kingoflolz/lutcam/gateware/fixtures/lrcca/test12.png

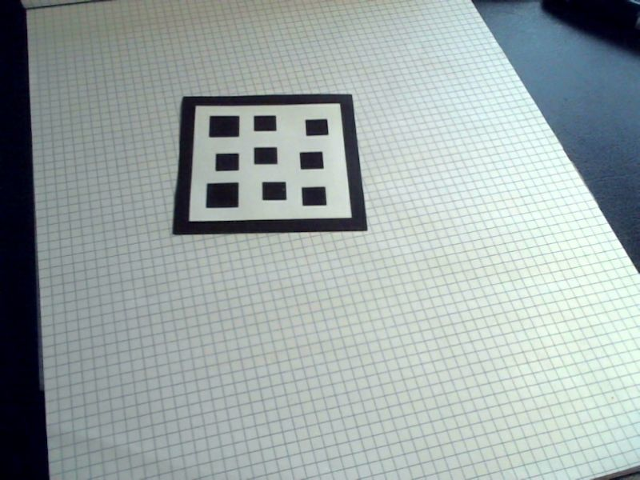
gateware/fixtures/lrcca/test12.png
