kingoflolz/lutcam/hardware/README.md

# Lutcam hardware

Open `lutcam-hardware.kicad_pro` in KiCad to work on the board and schematics.
The [datasheet inventory](datasheets/README.md) and
[3D model provenance](models3d/README.md) describe the supporting assets.

## License

Lutcam's original hardware design files, including schematics, PCB layout,
original symbols and footprints, and original mechanical models, are licensed
under the [Apache License, Version 2.0](../LICENSE).

Third-party library elements, supplier models, and manufacturer documentation
retain their own terms, including when embedded in a design or converted to
another format. See [NOTICE](../NOTICE) and
[THIRD_PARTY_NOTICES.md](../THIRD_PARTY_NOTICES.md) for the scope and exceptions.
