kingoflolz/lutcam/hardware/TI60F225/ti60_pinout-v1.1.xlsx

Sheet: V64
© 2021
Bank Number | Pin Names | Configuration Functions | MIPI RX Function | VREF Function for HSTL/SSTL | LVDS and MIPI Pairs | Clock Region | DDIO | WLCSP64
BL | TDI | TDI |  |  |  |  |  | H5
BL | TCK | TCK |  |  |  |  |  | H4
BL | TMS | TMS |  |  |  |  |  | H3 | Note:
BL | TDO | TDO |  |  |  |  |  | G4 | VCCIOxx_yy_zz indicates Power for I/O banks that are shorted together.
BANK1A | REF_RES_1A |  |  |  |  |  |  | F4 | xx, yy, and zz are the bank locations
BANK1A | CDONE | CDONE |  |  |  |  |  | F2 | For example, VCCIO1B_1C shorts banks 1B and 1C
BANK1A | CRESET_N | CRESET_N |  |  |  |  |  | H1
BANK1A | GPIOL_P_01_SSL_N | SSL_N | RX_DATA_P1_I0 |  | GPIOL_PN_01 | L0 | Y | F3
BANK1A | GPIOL_N_01_CCK | CCK | RX_DATA_N1_I0 |  | GPIOL_PN_01 | L0 | Y | E3
BANK1A | GPIOL_P_02_CSI | CSI | RX_CLK_P_I0 |  | GPIOL_PN_02 | L1 | Y | G1
BANK1A | GPIOL_N_02_CSO | CSO | RX_CLK_N_I0 |  | GPIOL_PN_02 | L1 | Y | F1
BANK1A | GPIOL_P_03_CDI0 | CDI0 | RX_DATA_P2_I0 |  | GPIOL_PN_03 | L1 | Y | D3
BANK1A | GPIOL_N_03_CDI1 | CDI1 | RX_DATA_N2_I0 |  | GPIOL_PN_03 | L1 | Y | C3
BANK1A | GPIOL_P_04_CDI2 | CDI2 | RX_DATA_P3_I0 | VREF1A | GPIOL_PN_04 | L1 | Y | D2
BANK1A | GPIOL_N_04_CDI3 | CDI3 | RX_DATA_N3_I0 |  | GPIOL_PN_04 | L1 | Y | C1
BANK1A | GPIOL_P_08_CLK1_P | EXT_CONFIG_CLK |  |  | GPIOL_PN_08 | L3 | Y | E1
BANK1A | GPIOL_N_08_CLK1_N |  |  |  | GPIOL_PN_08 | L3 | Y | D1
BANK1B | GPIOL_P_10_CLK3_P |  |  |  | GPIOL_PN_10 | L4 | Y | C4
BANK1B | GPIOL_N_10_CLK3_N |  |  |  | GPIOL_PN_10 | L4 | Y | B4
BANK1B | GPIOL_P_13_CBSEL0 | CBSEL0 |  |  | GPIOL_PN_13 | L5 | Y | B6
BANK1B | GPIOL_N_13_CBSEL1 | CBSEL1 |  |  | GPIOL_PN_13 | L5 | Y | B5
BANK1B | GPIOL_P_15_NSTATUS | NSTATUS |  | VREF1B | GPIOL_PN_15 | L6 | Y | A5
BANK1B | GPIOL_N_15_TEST_N | TEST_N |  |  | GPIOL_PN_15 | L6 | Y | A4
BANK1B | GPIOL_P_17_EXTFB |  |  |  | GPIOL_PN_17 | L6, L7 | Y | B3
BANK1B | GPIOL_N_17 |  |  |  | GPIOL_PN_17 | L6, L7 | Y | A3
BANK1B | GPIOL_P_18_PLLIN0 |  |  |  | GPIOL_PN_18 | L7 | Y | A2
BANK1B | GPIOL_N_18 |  |  |  | GPIOL_PN_18 | L7 | Y | A1
BANK1B | REF_RES_1B |  |  |  |  |  |  | C5
BANK2A | REF_RES_2A |  |  |  |  |  |  | A6
BANK2A | REF_RES_3A |  |  |  |  |  |  | A7
BANK3B | GPIOR_N_09_CLK10_N |  |  |  | GPIOR_PN_09 | R3 | Y | B8
BANK3B | GPIOR_P_09_CLK10_P |  |  |  | GPIOR_PN_09 | R3 | Y | B7
BANK3B | GPIOR_N_05_CDI31 |  | RX_DATA_N4_I6 |  | GPIOR_PN_05 | R2 | Y | D8
BANK3B | GPIOR_P_05_CDI30 |  | RX_DATA_P4_I6 | VREF3B | GPIOR_PN_05 | R2 | Y | C8
BANK3B | GPIOR_N_04_CDI29 |  | RX_DATA_N3_I6 |  | GPIOR_PN_04 | R1 | Y | F8
BANK3B | GPIOR_P_04_CDI28 |  | RX_DATA_P3_I6 |  | GPIOR_PN_04 | R1 | Y | E8
BANK3B | GPIOR_N_03_CDI27 |  | RX_DATA_N2_I6 |  | GPIOR_PN_03 | R1 | Y | C7
BANK3B | GPIOR_P_03_CDI26 |  | RX_DATA_P2_I6 |  | GPIOR_PN_03 | R1 | Y | D7
BANK3B | GPIOR_N_02_CDI25 |  | RX_CLK_N_I6 |  | GPIOR_PN_02 | R1 | Y | C6
BANK3B | GPIOR_P_02_CDI24 |  | RX_CLK_P_I6 |  | GPIOR_PN_02 | R1 | Y | D6
BANK3B | GPIOR_N_01_CDI23 |  | RX_DATA_N1_I6 |  | GPIOR_PN_01 | R0 | Y | F7
BANK3B | GPIOR_P_01_EXTFB |  | RX_DATA_P1_I6 |  | GPIOR_PN_01 | R0 | Y | G7
BANK3B | GPIOR_N_00_CDI22 |  | RX_DATA_N0_I6 |  | GPIOR_PN_00 | R0 | Y | G6
BANK3B | GPIOR_P_00_PLLIN0 |  | RX_DATA_P0_I6 |  | GPIOR_PN_00 | R0 | Y | H6
BANK3B | REF_RES_3B |  |  |  |  |  |  | G8
BANK4A | REF_RES_4A |  |  |  |  |  |  | H7
 | VCC |  |  |  |  |  |  | E7
 | VCC |  |  |  |  |  |  | E4
 | VCC |  |  |  |  |  |  | E2
 | VCC |  |  |  |  |  |  | D5
 | VCCA_BR |  |  |  |  |  |  | F6
 | VCCA_TL |  |  |  |  |  |  | B2
 | VCCAUX |  |  |  |  |  |  | F5
 | VCCIO1A_4B |  |  |  |  |  |  | G3
 | VCCIO1B_2A |  |  |  |  |  |  | C2
 | VCCIO2B_3A_3B_4A |  |  |  |  |  |  | E6
 | VCCIO33_BL |  |  |  |  |  |  | H2
 | VQPS_GND |  |  |  |  |  |  | B1
 | GND |  |  |  |  |  |  | H8
 | GND |  |  |  |  |  |  | G5
 | GND |  |  |  |  |  |  | G2
 | GND |  |  |  |  |  |  | E5
 | GND |  |  |  |  |  |  | D4
 | GND |  |  |  |  |  |  | A8

Sheet: W64
© 2021
Bank Number | Pin Names | Configuration Functions | MIPI RX Function | VREF Function for HSTL/SSTL | LVDS and MIPI Pairs | Clock Region | DDIO | WLCSP64
BL | TDI | TDI |  |  |  |  |  | H5
BL | TCK | TCK |  |  |  |  |  | H4
BL | TMS | TMS |  |  |  |  |  | H3 | Note:
BL | TDO | TDO |  |  |  |  |  | G4 | VCCIOxx_yy_zz indicates Power for I/O banks that are shorted together.
BANK1A | REF_RES_1A |  |  |  |  |  |  | F4 | xx, yy, and zz are the bank locations
BANK1A | CDONE | CDONE |  |  |  |  |  | F2 | For example, VCCIO1B_1C shorts banks 1B and 1C
BANK1A | CRESET_N | CRESET_N |  |  |  |  |  | H1
BANK1A | GPIOL_P_01_SSL_N | SSL_N | RX_DATA_P1_I0 |  | GPIOL_PN_01 | L0 | Y | F3
BANK1A | GPIOL_N_01_CCK | CCK | RX_DATA_N1_I0 |  | GPIOL_PN_01 | L0 | Y | E3
BANK1A | GPIOL_P_02_CSI | CSI | RX_CLK_P_I0 |  | GPIOL_PN_02 | L1 | Y | G1
BANK1A | GPIOL_N_02_CSO | CSO | RX_CLK_N_I0 |  | GPIOL_PN_02 | L1 | Y | F1
BANK1A | GPIOL_P_03_CDI0 | CDI0 | RX_DATA_P2_I0 |  | GPIOL_PN_03 | L1 | Y | D3
BANK1A | GPIOL_N_03_CDI1 | CDI1 | RX_DATA_N2_I0 |  | GPIOL_PN_03 | L1 | Y | C3
BANK1A | GPIOL_P_04_CDI2 | CDI2 | RX_DATA_P3_I0 | VREF1A | GPIOL_PN_04 | L1 | Y | D2
BANK1A | GPIOL_N_04_CDI3 | CDI3 | RX_DATA_N3_I0 |  | GPIOL_PN_04 | L1 | Y | C1
BANK1A | GPIOL_P_08_CLK1_P | EXT_CONFIG_CLK |  |  | GPIOL_PN_08 | L3 | Y | E1
BANK1A | GPIOL_N_08_CLK1_N |  |  |  | GPIOL_PN_08 | L3 | Y | D1
BANK1B | GPIOL_P_10_CLK3_P |  |  |  | GPIOL_PN_10 | L4 | Y | C4
BANK1B | GPIOL_N_10_CLK3_N |  |  |  | GPIOL_PN_10 | L4 | Y | B4
BANK1B | GPIOL_P_13_CBSEL0 | CBSEL0 |  |  | GPIOL_PN_13 | L5 | Y | B6
BANK1B | GPIOL_N_13_CBSEL1 | CBSEL1 |  |  | GPIOL_PN_13 | L5 | Y | B5
BANK1B | GPIOL_P_15_NSTATUS | NSTATUS |  | VREF1B | GPIOL_PN_15 | L6 | Y | A5
BANK1B | GPIOL_N_15_TEST_N | TEST_N |  |  | GPIOL_PN_15 | L6 | Y | A4
BANK1B | GPIOL_P_17_EXTFB |  |  |  | GPIOL_PN_17 | L6, L7 | Y | B3
BANK1B | GPIOL_N_17 |  |  |  | GPIOL_PN_17 | L6, L7 | Y | A3
BANK1B | GPIOL_P_18_PLLIN0 |  |  |  | GPIOL_PN_18 | L7 | Y | A2
BANK1B | GPIOL_N_18 |  |  |  | GPIOL_PN_18 | L7 | Y | A1
BANK1B | REF_RES_1B |  |  |  |  |  |  | C5
BANK2A | REF_RES_2A |  |  |  |  |  |  | A6
BANK2A | REF_RES_3A |  |  |  |  |  |  | A7
BANK3B | GPIOR_N_09_CLK10_N |  |  |  | GPIOR_PN_09 | R3 | Y | B8
BANK3B | GPIOR_P_09_CLK10_P |  |  |  | GPIOR_PN_09 | R3 | Y | B7
BANK3B | GPIOR_N_05_CDI31 |  | RX_DATA_N4_I6 |  | GPIOR_PN_05 | R2 | Y | D8
BANK3B | GPIOR_P_05_CDI30 |  | RX_DATA_P4_I6 | VREF3B | GPIOR_PN_05 | R2 | Y | C8
BANK3B | GPIOR_N_04_CDI29 |  | RX_DATA_N3_I6 |  | GPIOR_PN_04 | R1 | Y | F8
BANK3B | GPIOR_P_04_CDI28 |  | RX_DATA_P3_I6 |  | GPIOR_PN_04 | R1 | Y | E8
BANK3B | GPIOR_N_03_CDI27 |  | RX_DATA_N2_I6 |  | GPIOR_PN_03 | R1 | Y | C7
BANK3B | GPIOR_P_03_CDI26 |  | RX_DATA_P2_I6 |  | GPIOR_PN_03 | R1 | Y | D7
BANK3B | GPIOR_N_02_CDI25 |  | RX_CLK_N_I6 |  | GPIOR_PN_02 | R1 | Y | C6
BANK3B | GPIOR_P_02_CDI24 |  | RX_CLK_P_I6 |  | GPIOR_PN_02 | R1 | Y | D6
BANK3B | GPIOR_N_01_CDI23 |  | RX_DATA_N1_I6 |  | GPIOR_PN_01 | R0 | Y | F7
BANK3B | GPIOR_P_01_EXTFB |  | RX_DATA_P1_I6 |  | GPIOR_PN_01 | R0 | Y | G7
BANK3B | GPIOR_N_00_CDI22 |  | RX_DATA_N0_I6 |  | GPIOR_PN_00 | R0 | Y | G6
BANK3B | GPIOR_P_00_PLLIN0 |  | RX_DATA_P0_I6 |  | GPIOR_PN_00 | R0 | Y | H6
BANK3B | REF_RES_3B |  |  |  |  |  |  | G8
BANK4A | REF_RES_4A |  |  |  |  |  |  | H7
 | VCC |  |  |  |  |  |  | E7
 | VCC |  |  |  |  |  |  | E4
 | VCC |  |  |  |  |  |  | E2
 | VCC |  |  |  |  |  |  | D5
 | VCCA_BR |  |  |  |  |  |  | F6
 | VCCA_TL |  |  |  |  |  |  | B2
 | VCCAUX |  |  |  |  |  |  | F5
 | VCCIO1A_4B |  |  |  |  |  |  | G3
 | VCCIO1B_2A |  |  |  |  |  |  | C2
 | VCCIO2B_3A_3B_4A |  |  |  |  |  |  | E6
 | VCCIO33_BL |  |  |  |  |  |  | H2
 | GND |  |  |  |  |  |  | H8
 | GND |  |  |  |  |  |  | G5
 | GND |  |  |  |  |  |  | G2
 | GND |  |  |  |  |  |  | E5
 | GND |  |  |  |  |  |  | D4
 | GND |  |  |  |  |  |  | B1
 | GND |  |  |  |  |  |  | A8

Sheet: F100
© 2024
Bank Number | Pin Names | Configuration Functions | MIPI RX Function | VREF Function for HSTL/SSTL | LVDS and MIPI Pairs | Clock Region | DDIO | FBGA100
BL | TDI | TDI |  |  |  |  |  | K5
BL | TCK | TCK |  |  |  |  |  | K3
BL | TMS | TMS |  |  |  |  |  | K4 | Note:
BL | TDO | TDO |  |  |  |  |  | J4 | VCCIOxx_yy_zz indicates Power for I/O banks that are shorted together.
BANK1A | REF_RES_1A |  |  |  |  |  |  | H4 | xx, yy, and zz are the bank locations
BANK1A | CDONE | CDONE |  |  |  |  |  | H3 | For example, VCCIO1B_1C shorts banks 1B and 1C
BANK1A | CRESET_N | CRESET_N |  |  |  |  |  | K1
BANK1A | GPIOL_P_01_SSL_N | SSL_N |  |  | GPIOL_PN_01 | L0 |  | J1
BANK1A | GPIOL_N_01_CCK | CCK |  |  | GPIOL_PN_01 | L0 |  | J2
BANK1A | GPIOL_P_03_CDI0 | CDI0 |  |  | GPIOL_PN_03 | L1 |  | H2
BANK1A | GPIOL_N_03_CDI1 | CDI1 |  |  | GPIOL_PN_03 | L1 |  | H1
BANK1A | GPIOL_P_05 |  | RX_DATA_P0_I1 |  | GPIOL_PN_05 | L2 | Y | G4
BANK1A | GPIOL_N_05 |  | RX_DATA_N0_I1 |  | GPIOL_PN_05 | L2 | Y | G3
BANK1A | GPIOL_P_06 |  | RX_DATA_P1_I1 |  | GPIOL_PN_06 | L2 | Y | G1
BANK1A | GPIOL_N_06 |  | RX_DATA_N1_I1 |  | GPIOL_PN_06 | L2 | Y | F1
BANK1A | GPIOL_P_07_CLK0_P |  | RX_DATA_P2_I1 |  | GPIOL_PN_07 | L3 | Y | F4
BANK1A | GPIOL_N_07_CLK0_N |  | RX_DATA_N2_I1 |  | GPIOL_PN_07 | L3 | Y | F5
BANK1A | GPIOL_P_08_CLK1_P | EXT_CONFIG_CLK | RX_DATA_P3_I1 |  | GPIOL_PN_08 | L3 | Y | E4
BANK1A | GPIOL_N_08_CLK1_N |  | RX_DATA_N3_I1 |  | GPIOL_PN_08 | L3 | Y | E5
BANK1B | GPIOL_P_09_CLK2_P |  | RX_CLK_P_I1 |  | GPIOL_PN_09 | L4 | Y | F3
BANK1B | GPIOL_N_09_CLK2_N |  | RX_CLK_N_I1 |  | GPIOL_PN_09 | L4 | Y | F2
BANK1B | GPIOL_P_10_CLK3_P |  | RX_DATA_P4_I1 |  | GPIOL_PN_10 | L4 | Y | E1
BANK1B | GPIOL_N_10_CLK3_N |  | RX_DATA_N4_I1 |  | GPIOL_PN_10 | L4 | Y | D1
BANK1B | GPIOL_P_11 |  | RX_DATA_P5_I1 |  | GPIOL_PN_11 | L4 | Y | E2
BANK1B | GPIOL_N_11 |  | RX_DATA_N5_I1 |  | GPIOL_PN_11 | L4 | Y | E3
BANK1B | GPIOL_P_12 |  | RX_DATA_P6_I1 |  | GPIOL_PN_12 | L5 | Y | C3
BANK1B | GPIOL_N_12 |  | RX_DATA_N6_I1 |  | GPIOL_PN_12 | L5 | Y | C2
BANK1B | GPIOL_P_13_CBSEL0 | CBSEL0 | RX_DATA_P7_I1 |  | GPIOL_PN_13 | L5 | Y | B1
BANK1B | GPIOL_N_13_CBSEL1 | CBSEL1 | RX_DATA_N7_I1 |  | GPIOL_PN_13 | L5 | Y | C1
BANK1B | GPIOL_P_15_NSTATUS | NSTATUS |  | VREF1B | GPIOL_PN_15 | L6 | Y | C5
BANK1B | GPIOL_N_15_TEST_N | TEST_N |  |  | GPIOL_PN_15 | L6 | Y | D5
BANK1B | GPIOL_P_17_EXTFB |  |  |  | GPIOL_PN_17 | L6, L7 | Y | B4
BANK1B | GPIOL_N_17 |  |  |  | GPIOL_PN_17 | L6, L7 | Y | C4
BANK1B | GPIOL_P_18_PLLIN0 |  |  |  | GPIOL_PN_18 | L7 | Y | B3
BANK1B | GPIOL_N_18 |  |  |  | GPIOL_PN_18 | L7 | Y | B2
BANK1B | REF_RES_1B |  |  |  |  |  |  | A3
BANK2A | REF_RES_2A |  |  |  |  |  |  | B5
BANK2A | GPIOT_P_01 |  |  |  |  | T0 | Y | A4
BANK3A | REF_RES_3A |  |  |  |  |  |  | B7
BANK3A | GPIOR_N_19 |  |  |  | GPIOR_PN_19 | R7 | Y | A10
BANK3A | GPIOR_P_19_PLLIN0 |  |  |  | GPIOR_PN_19 | R7 | Y | A9
BANK3A | GPIOR_N_14 |  | RX_DATA_N7_I7 |  | GPIOR_PN_14 | R5 | Y | B10
BANK3A | GPIOR_P_14 |  | RX_DATA_P7_I7 |  | GPIOR_PN_14 | R5 | Y | B9
BANK3A | GPIOR_N_13 |  | RX_DATA_N6_I7 |  | GPIOR_PN_13 | R5 | Y | B8
BANK3A | GPIOR_P_13 |  | RX_DATA_P6_I7 | VREF3A | GPIOR_PN_13 | R5 | Y | C8
BANK3A | GPIOR_N_12 |  | RX_DATA_N5_I7 |  | GPIOR_PN_12 | R4 | Y | C10
BANK3A | GPIOR_P_12 |  | RX_DATA_P5_I7 |  | GPIOR_PN_12 | R4 | Y | D10
BANK3A | GPIOR_N_11_CLK8_N |  | RX_DATA_N4_I7 |  | GPIOR_PN_11 | R4 | Y | D9
BANK3A | GPIOR_P_11_CLK8_P |  | RX_DATA_P4_I7 |  | GPIOR_PN_11 | R4 | Y | D8
BANK3A | GPIOR_N_10_CLK9_N |  | RX_CLK_N_I7 |  | GPIOR_PN_10 | R4 | Y | C7
BANK3A | GPIOR_P_10_CLK9_P |  | RX_CLK_P_I7 |  | GPIOR_PN_10 | R4 | Y | D6
BANK3B | GPIOR_N_09_CLK10_N |  | RX_DATA_N3_I7 |  | GPIOR_PN_09 | R3 | Y | E9
BANK3B | GPIOR_P_09_CLK10_P |  | RX_DATA_P3_I7 |  | GPIOR_PN_09 | R3 | Y | E8
BANK3B | GPIOR_N_08_CLK11_N |  | RX_DATA_N2_I7 |  | GPIOR_PN_08 | R3 | Y | E7
BANK3B | GPIOR_P_08_CLK11_P |  | RX_DATA_P2_I7 |  | GPIOR_PN_08 | R3 | Y | F7
BANK3B | GPIOR_N_07 |  | RX_DATA_N1_I7 |  | GPIOR_PN_07 | R3 | Y | F8
BANK3B | GPIOR_P_07 |  | RX_DATA_P1_I7 |  | GPIOR_PN_07 | R3 | Y | G8
BANK3B | GPIOR_N_06 |  | RX_DATA_N0_I7 |  | GPIOR_PN_06 | R2 | Y | F10
BANK3B | GPIOR_P_06 |  | RX_DATA_P0_I7 |  | GPIOR_PN_06 | R2 | Y | F9
BANK3B | GPIOR_N_05 |  | RX_DATA_N4_I6 |  | GPIOR_PN_05 | R2 | Y | H8
BANK3B | GPIOR_P_05 |  | RX_DATA_P4_I6 | VREF3B | GPIOR_PN_05 | R2 | Y | H9
BANK3B | GPIOR_N_04 |  | RX_DATA_N3_I6 |  | GPIOR_PN_04 | R1 | Y | G10
BANK3B | GPIOR_P_04 |  | RX_DATA_P3_I6 |  | GPIOR_PN_04 | R1 | Y | H10
BANK3B | GPIOR_N_03 |  | RX_DATA_N2_I6 |  | GPIOR_PN_03 | R1 | Y | J6
BANK3B | GPIOR_P_03 |  | RX_DATA_P2_I6 |  | GPIOR_PN_03 | R1 | Y | H6
BANK3B | GPIOR_N_02 |  | RX_CLK_N_I6 |  | GPIOR_PN_02 | R1 | Y | J7
BANK3B | GPIOR_P_02 |  | RX_CLK_P_I6 |  | GPIOR_PN_02 | R1 | Y | J8
BANK3B | GPIOR_N_01 |  | RX_DATA_N1_I6 |  | GPIOR_PN_01 | R0 | Y | J10
BANK3B | GPIOR_P_01_EXTFB |  | RX_DATA_P1_I6 |  | GPIOR_PN_01 | R0 | Y | K10
BANK3B | GPIOR_N_00 |  | RX_DATA_N0_I6 |  | GPIOR_PN_00 | R0 | Y | H5
BANK3B | GPIOR_P_00_PLLIN0 |  | RX_DATA_P0_I6 |  | GPIOR_PN_00 | R0 | Y | J5
BANK3B | REF_RES_3B |  |  |  |  |  |  | K9
BANK4A | REF_RES_4A |  |  |  |  |  |  | K8
 | VCC |  |  |  |  |  |  | G5
 | VCC |  |  |  |  |  |  | C6
 | VCC |  |  |  |  |  |  | E6
 | VCC |  |  |  |  |  |  | F6
 | VCC |  |  |  |  |  |  | D7
 | VCC |  |  |  |  |  |  | H7
 | VCCA_BR |  |  |  |  |  |  | K7
 | VCCA_TL |  |  |  |  |  |  | A2
 | VCCA_TR |  |  |  |  |  |  | A7
 | VCCAUX |  |  |  |  |  |  | B6
 | VCCAUX |  |  |  |  |  |  | G6
 | VCCIO1A_4B |  |  |  |  |  |  | G2
 | VCCIO1B |  |  |  |  |  |  | D3
 | VCCIO2A_2B |  |  |  |  |  |  | A6
 | VCCIO33_BL |  |  |  |  |  |  | J3
 | VCCIO3A |  |  |  |  |  |  | C9
 | VCCIO3B_4A |  |  |  |  |  |  | G9
 | VQPS |  |  |  |  |  |  | A5
 | GND |  |  |  |  |  |  | A1
 | GND |  |  |  |  |  |  | D2
 | GND |  |  |  |  |  |  | K2
 | GND |  |  |  |  |  |  | D4
 | GND |  |  |  |  |  |  | K6
 | GND |  |  |  |  |  |  | G7
 | GND |  |  |  |  |  |  | A8
 | GND |  |  |  |  |  |  | J9
 | GND |  |  |  |  |  |  | E10

Sheet: F100S3F2
© 2021
Bank Number | Pin Names | Configuration Functions | MIPI RX Function | VREF Function for HSTL/SSTL | LVDS and MIPI Pairs | Clock Region | DDIO | FBGA100
BL | TDI | TDI |  |  |  |  |  | K5
BL | TCK | TCK |  |  |  |  |  | K3
BL | TMS | TMS |  |  |  |  |  | K4 | Note:
BL | TDO | TDO |  |  |  |  |  | J4 | VCCIOxx_yy_zz indicates Power for I/O banks that are shorted together.
BANK1A | REF_RES_1A |  |  |  |  |  |  | H4 | xx, yy, and zz are the bank locations
BANK1A | CDONE | CDONE |  |  |  |  |  | H3 | For example, VCCIO1B_1C shorts banks 1B and 1C
BANK1A | CRESET_N | CRESET_N |  |  |  |  |  | K1
BANK1A | GPIOL_P_01_SSL_N | SSL_N |  |  | GPIOL_PN_01 | L0 |  | J1
BANK1A | GPIOL_N_01_CCK | CCK |  |  | GPIOL_PN_01 | L0 |  | J2
BANK1A | GPIOL_P_03_CDI0 | CDI0 |  |  | GPIOL_PN_03 | L1 |  | H2
BANK1A | GPIOL_N_03_CDI1 | CDI1 |  |  | GPIOL_PN_03 | L1 |  | H1
BANK1A | GPIOL_P_05 |  | RX_DATA_P0_I1 |  | GPIOL_PN_05 | L2 | Y | G4
BANK1A | GPIOL_N_05 |  | RX_DATA_N0_I1 |  | GPIOL_PN_05 | L2 | Y | G3
BANK1A | GPIOL_P_06 |  | RX_DATA_P1_I1 |  | GPIOL_PN_06 | L2 | Y | G1
BANK1A | GPIOL_N_06 |  | RX_DATA_N1_I1 |  | GPIOL_PN_06 | L2 | Y | F1
BANK1A | GPIOL_P_07_CLK0_P |  | RX_DATA_P2_I1 |  | GPIOL_PN_07 | L3 | Y | F4
BANK1A | GPIOL_N_07_CLK0_N |  | RX_DATA_N2_I1 |  | GPIOL_PN_07 | L3 | Y | F5
BANK1A | GPIOL_P_08_CLK1_P | EXT_CONFIG_CLK | RX_DATA_P3_I1 |  | GPIOL_PN_08 | L3 | Y | E4
BANK1A | GPIOL_N_08_CLK1_N |  | RX_DATA_N3_I1 |  | GPIOL_PN_08 | L3 | Y | E5
BANK1B | GPIOL_P_09_CLK2_P |  | RX_CLK_P_I1 |  | GPIOL_PN_09 | L4 | Y | F3
BANK1B | GPIOL_N_09_CLK2_N |  | RX_CLK_N_I1 |  | GPIOL_PN_09 | L4 | Y | F2
BANK1B | GPIOL_P_10_CLK3_P |  | RX_DATA_P4_I1 |  | GPIOL_PN_10 | L4 | Y | E1
BANK1B | GPIOL_N_10_CLK3_N |  | RX_DATA_N4_I1 |  | GPIOL_PN_10 | L4 | Y | D1
BANK1B | GPIOL_P_11 |  | RX_DATA_P5_I1 |  | GPIOL_PN_11 | L4 | Y | E2
BANK1B | GPIOL_N_11 |  | RX_DATA_N5_I1 |  | GPIOL_PN_11 | L4 | Y | E3
BANK1B | GPIOL_P_12 |  | RX_DATA_P6_I1 |  | GPIOL_PN_12 | L5 | Y | C3
BANK1B | GPIOL_N_12 |  | RX_DATA_N6_I1 |  | GPIOL_PN_12 | L5 | Y | C2
BANK1B | GPIOL_P_13_CBSEL0 | CBSEL0 | RX_DATA_P7_I1 |  | GPIOL_PN_13 | L5 | Y | B1
BANK1B | GPIOL_N_13_CBSEL1 | CBSEL1 | RX_DATA_N7_I1 |  | GPIOL_PN_13 | L5 | Y | C1
BANK1B | GPIOL_P_15_NSTATUS | NSTATUS |  | VREF1B | GPIOL_PN_15 | L6 | Y | C5
BANK1B | GPIOL_N_15_TEST_N | TEST_N |  |  | GPIOL_PN_15 | L6 | Y | D5
BANK1B | GPIOL_P_17_EXTFB |  |  |  | GPIOL_PN_17 | L6, L7 | Y | B4
BANK1B | GPIOL_N_17 |  |  |  | GPIOL_PN_17 | L6, L7 | Y | C4
BANK1B | GPIOL_P_18_PLLIN0 |  |  |  | GPIOL_PN_18 | L7 | Y | B3
BANK1B | GPIOL_N_18 |  |  |  | GPIOL_PN_18 | L7 | Y | B2
BANK1B | REF_RES_1B |  |  |  |  |  |  | A3
BANK2A | REF_RES_2A |  |  |  |  |  |  | B5
BANK2A | GPIOT_P_01 |  |  |  |  | T0 | Y | A4
BANK3A | REF_RES_3A |  |  |  |  |  |  | B7
BANK3A | GPIOR_N_19 |  |  |  | GPIOR_PN_19 | R7 | Y | A10
BANK3A | GPIOR_P_19_PLLIN0 |  |  |  | GPIOR_PN_19 | R7 | Y | A9
BANK3A | GPIOR_N_14 |  | RX_DATA_N7_I7 |  | GPIOR_PN_14 | R5 | Y | B10
BANK3A | GPIOR_P_14 |  | RX_DATA_P7_I7 |  | GPIOR_PN_14 | R5 | Y | B9
BANK3A | GPIOR_N_13 |  | RX_DATA_N6_I7 |  | GPIOR_PN_13 | R5 | Y | B8
BANK3A | GPIOR_P_13 |  | RX_DATA_P6_I7 | VREF3A | GPIOR_PN_13 | R5 | Y | C8
BANK3A | GPIOR_N_12 |  | RX_DATA_N5_I7 |  | GPIOR_PN_12 | R4 | Y | C10
BANK3A | GPIOR_P_12 |  | RX_DATA_P5_I7 |  | GPIOR_PN_12 | R4 | Y | D10
BANK3A | GPIOR_N_11_CLK8_N |  | RX_DATA_N4_I7 |  | GPIOR_PN_11 | R4 | Y | D9
BANK3A | GPIOR_P_11_CLK8_P |  | RX_DATA_P4_I7 |  | GPIOR_PN_11 | R4 | Y | D8
BANK3A | GPIOR_N_10_CLK9_N |  | RX_CLK_N_I7 |  | GPIOR_PN_10 | R4 | Y | C7
BANK3A | GPIOR_P_10_CLK9_P |  | RX_CLK_P_I7 |  | GPIOR_PN_10 | R4 | Y | D6
BANK3B | GPIOR_N_09_CLK10_N |  | RX_DATA_N3_I7 |  | GPIOR_PN_09 | R3 | Y | E9
BANK3B | GPIOR_P_09_CLK10_P |  | RX_DATA_P3_I7 |  | GPIOR_PN_09 | R3 | Y | E8
BANK3B | GPIOR_N_08_CLK11_N |  | RX_DATA_N2_I7 |  | GPIOR_PN_08 | R3 | Y | E7
BANK3B | GPIOR_P_08_CLK11_P |  | RX_DATA_P2_I7 |  | GPIOR_PN_08 | R3 | Y | F7
BANK3B | GPIOR_N_07 |  | RX_DATA_N1_I7 |  | GPIOR_PN_07 | R3 | Y | F8
BANK3B | GPIOR_P_07 |  | RX_DATA_P1_I7 |  | GPIOR_PN_07 | R3 | Y | G8
BANK3B | GPIOR_N_06 |  | RX_DATA_N0_I7 |  | GPIOR_PN_06 | R2 | Y | F10
BANK3B | GPIOR_P_06 |  | RX_DATA_P0_I7 |  | GPIOR_PN_06 | R2 | Y | F9
BANK3B | GPIOR_N_05 |  | RX_DATA_N4_I6 |  | GPIOR_PN_05 | R2 | Y | H8
BANK3B | GPIOR_P_05 |  | RX_DATA_P4_I6 | VREF3B | GPIOR_PN_05 | R2 | Y | H9
BANK3B | GPIOR_N_04 |  | RX_DATA_N3_I6 |  | GPIOR_PN_04 | R1 | Y | G10
BANK3B | GPIOR_P_04 |  | RX_DATA_P3_I6 |  | GPIOR_PN_04 | R1 | Y | H10
BANK3B | GPIOR_N_03 |  | RX_DATA_N2_I6 |  | GPIOR_PN_03 | R1 | Y | J6
BANK3B | GPIOR_P_03 |  | RX_DATA_P2_I6 |  | GPIOR_PN_03 | R1 | Y | H6
BANK3B | GPIOR_N_02 |  | RX_CLK_N_I6 |  | GPIOR_PN_02 | R1 | Y | J7
BANK3B | GPIOR_P_02 |  | RX_CLK_P_I6 |  | GPIOR_PN_02 | R1 | Y | J8
BANK3B | GPIOR_N_01 |  | RX_DATA_N1_I6 |  | GPIOR_PN_01 | R0 | Y | J10
BANK3B | GPIOR_P_01_EXTFB |  | RX_DATA_P1_I6 |  | GPIOR_PN_01 | R0 | Y | K10
BANK3B | GPIOR_N_00 |  | RX_DATA_N0_I6 |  | GPIOR_PN_00 | R0 | Y | H5
BANK3B | GPIOR_P_00_PLLIN0 |  | RX_DATA_P0_I6 |  | GPIOR_PN_00 | R0 | Y | J5
BANK3B | REF_RES_3B |  |  |  |  |  |  | K9
BANK4A | REF_RES_4A |  |  |  |  |  |  | K8
 | VCC |  |  |  |  |  |  | G5
 | VCC |  |  |  |  |  |  | C6
 | VCC |  |  |  |  |  |  | E6
 | VCC |  |  |  |  |  |  | F6
 | VCC |  |  |  |  |  |  | D7
 | VCC |  |  |  |  |  |  | H7
 | VCCA_BR |  |  |  |  |  |  | K7
 | VCCA_TL |  |  |  |  |  |  | A2
 | VCCA_TR |  |  |  |  |  |  | A7
 | VCCAUX |  |  |  |  |  |  | B6
 | VCCAUX |  |  |  |  |  |  | G6
 | VCCIO1A_4B |  |  |  |  |  |  | G2
 | VCCIO1B |  |  |  |  |  |  | D3
 | VCCIO2A_2B |  |  |  |  |  |  | A6
 | VCCIO33_BL |  |  |  |  |  |  | J3
 | VCCIO3A |  |  |  |  |  |  | C9
 | VCCIO3B_4A |  |  |  |  |  |  | G9
 | VQPS_GND |  |  |  |  |  |  | A5
 | GND |  |  |  |  |  |  | A1
 | GND |  |  |  |  |  |  | D2
 | GND |  |  |  |  |  |  | K2
 | GND |  |  |  |  |  |  | D4
 | GND |  |  |  |  |  |  | K6
 | GND |  |  |  |  |  |  | G7
 | GND |  |  |  |  |  |  | A8
 | GND |  |  |  |  |  |  | J9
 | GND |  |  |  |  |  |  | E10

Sheet: F225
© 2021
Bank Number | Pin Names | Configuration Functions | MIPI RX Function | VREF Function for HSTL/SSTL | LVDS and MIPI Pairs | Clock Region | DDIO | FBGA225
BL | GPIOL_01 |  |  |  |  | B0 | Y | R3
BL | GPIOL_02 |  |  |  |  | B0 | Y | R4
BL | TDI | TDI |  |  |  |  |  | P3 | Note:
BL | TCK | TCK |  |  |  |  |  | N4 | VCCIOxx_yy_zz indicates Power for I/O banks that are shorted together.
BL | TMS | TMS |  |  |  |  |  | N3 | xx, yy, and zz are the bank locations
BL | TDO | TDO |  |  |  |  |  | M4 | For example, VCCIO1B_1C shorts banks 1B and 1C
BANK1A | REF_RES_1A |  |  |  |  |  |  | K5
BANK1A | CDONE | CDONE |  |  |  |  |  | L3
BANK1A | CRESET_N | CRESET_N |  |  |  |  |  | J5
BANK1A | GPIOL_P_00_PLLIN0 |  | RX_DATA_P0_I0 |  | GPIOL_PN_00 | L0 | Y | P2
BANK1A | GPIOL_N_00 |  | RX_DATA_N0_I0 |  | GPIOL_PN_00 | L0 | Y | R2
BANK1A | GPIOL_P_01_SSL_N | SSL_N | RX_DATA_P1_I0 |  | GPIOL_PN_01 | L0 | Y | P1
BANK1A | GPIOL_N_01_CCK | CCK | RX_DATA_N1_I0 |  | GPIOL_PN_01 | L0 | Y | N1
BANK1A | GPIOL_P_02_CSI | CSI | RX_CLK_P_I0 |  | GPIOL_PN_02 | L1 | Y | N2
BANK1A | GPIOL_N_02_CSO | CSO | RX_CLK_N_I0 |  | GPIOL_PN_02 | L1 | Y | M2
BANK1A | GPIOL_P_03_CDI0 | CDI0 | RX_DATA_P2_I0 |  | GPIOL_PN_03 | L1 | Y | M1
BANK1A | GPIOL_N_03_CDI1 | CDI1 | RX_DATA_N2_I0 |  | GPIOL_PN_03 | L1 | Y | L1
BANK1A | GPIOL_P_04_CDI2 | CDI2 | RX_DATA_P3_I0 | VREF1A | GPIOL_PN_04 | L1 | Y | H5
BANK1A | GPIOL_N_04_CDI3 | CDI3 | RX_DATA_N3_I0 |  | GPIOL_PN_04 | L1 | Y | H4
BANK1A | GPIOL_P_05 |  | RX_DATA_P0_I1 |  | GPIOL_PN_05 | L2 | Y | K4
BANK1A | GPIOL_N_05 |  | RX_DATA_N0_I1 |  | GPIOL_PN_05 | L2 | Y | J3
BANK1A | GPIOL_P_06 |  | RX_DATA_P1_I1 |  | GPIOL_PN_06 | L2 | Y | K3
BANK1A | GPIOL_N_06 |  | RX_DATA_N1_I1 |  | GPIOL_PN_06 | L2 | Y | K2
BANK1A | GPIOL_P_07_CLK0_P |  | RX_DATA_P2_I1 |  | GPIOL_PN_07 | L3 | Y | K1
BANK1A | GPIOL_N_07_CLK0_N |  | RX_DATA_N2_I1 |  | GPIOL_PN_07 | L3 | Y | J1
BANK1A | GPIOL_P_08_CLK1_P | EXT_CONFIG_CLK | RX_DATA_P3_I1 |  | GPIOL_PN_08 | L3 | Y | J2
BANK1A | GPIOL_N_08_CLK1_N |  | RX_DATA_N3_I1 |  | GPIOL_PN_08 | L3 | Y | H3
BANK1B | GPIOL_P_09_CLK2_P |  | RX_CLK_P_I1 |  | GPIOL_PN_09 | L4 | Y | H1
BANK1B | GPIOL_N_09_CLK2_N |  | RX_CLK_N_I1 |  | GPIOL_PN_09 | L4 | Y | G1
BANK1B | GPIOL_P_10_CLK3_P |  | RX_DATA_P4_I1 |  | GPIOL_PN_10 | L4 | Y | H2
BANK1B | GPIOL_N_10_CLK3_N |  | RX_DATA_N4_I1 |  | GPIOL_PN_10 | L4 | Y | G2
BANK1B | GPIOL_P_11 |  | RX_DATA_P5_I1 |  | GPIOL_PN_11 | L4 | Y | G5
BANK1B | GPIOL_N_11 |  | RX_DATA_N5_I1 |  | GPIOL_PN_11 | L4 | Y | F5
BANK1B | GPIOL_P_12 |  | RX_DATA_P6_I1 |  | GPIOL_PN_12 | L5 | Y | G3
BANK1B | GPIOL_N_12 |  | RX_DATA_N6_I1 |  | GPIOL_PN_12 | L5 | Y | G4
BANK1B | GPIOL_P_13_CBSEL0 | CBSEL0 | RX_DATA_P7_I1 |  | GPIOL_PN_13 | L5 | Y | F3
BANK1B | GPIOL_N_13_CBSEL1 | CBSEL1 | RX_DATA_N7_I1 |  | GPIOL_PN_13 | L5 | Y | E3
BANK1B | GPIOL_P_14 |  | RX_DATA_P0_I2 |  | GPIOL_PN_14 | L6 | Y | F1
BANK1B | GPIOL_N_14 |  | RX_DATA_N0_I2 |  | GPIOL_PN_14 | L6 | Y | F2
BANK1B | GPIOL_P_15_NSTATUS | NSTATUS | RX_DATA_P1_I2 | VREF1B | GPIOL_PN_15 | L6 | Y | E1
BANK1B | GPIOL_N_15_TEST_N | TEST_N | RX_DATA_N1_I2 |  | GPIOL_PN_15 | L6 | Y | E2
BANK1B | GPIOL_P_16 |  | RX_CLK_P_I2 |  | GPIOL_PN_16 | L6 | Y | D1
BANK1B | GPIOL_N_16 |  | RX_CLK_N_I2 |  | GPIOL_PN_16 | L6 | Y | C1
BANK1B | GPIOL_P_17_EXTFB |  | RX_DATA_P2_I2 |  | GPIOL_PN_17 | L6, L7 | Y | B1
BANK1B | GPIOL_N_17 |  | RX_DATA_N2_I2 |  | GPIOL_PN_17 | L6, L7 | Y | C2
BANK1B | GPIOL_P_18_PLLIN0 |  | RX_DATA_P3_I2 |  | GPIOL_PN_18 | L7 | Y | B2
BANK1B | GPIOL_N_18 |  | RX_DATA_N3_I2 |  | GPIOL_PN_18 | L7 | Y | A2
BANK1B | REF_RES_1B |  |  |  |  |  |  | E4
TL | GPIOL_03 |  |  |  |  | T0 | Y | A3
TL | GPIOL_04 |  |  |  |  | T0 | Y | B3
TL | GPIOL_06 |  |  |  |  | T0 | Y | C3
TL | GPIOL_07 |  |  |  |  | T0 | Y | C4
TL | GPIOL_09 |  |  |  |  | T0 | Y | A4
TL | GPIOL_10 |  |  |  |  | T0 | Y | B5
TL | GPIOL_11_PLLIN2 |  |  |  |  | T0 | Y | C5
BANK2A | REF_RES_2A |  |  |  |  |  |  | F6
BANK2A | GPIOT_P_00_PLLIN1 |  | RX_DATA_P0_I3 | VREF2A | GPIOT_PN_00 | T0 | Y | E6
BANK2A | GPIOT_N_00 |  | RX_DATA_N0_I3 |  | GPIOT_PN_00 | T0 | Y | D5
BANK2A | GPIOT_P_01 |  | RX_DATA_P1_I3 |  | GPIOT_PN_01 | T0 | Y | B6
BANK2A | GPIOT_N_01 |  | RX_DATA_N1_I3 |  | GPIOT_PN_01 | T0 | Y | C6
BANK2A | GPIOT_P_03 |  | RX_CLK_P_I3 |  | GPIOT_PN_03 | T0 | Y | A5
BANK2A | GPIOT_N_03 |  | RX_CLK_N_I3 |  | GPIOT_PN_03 | T0 | Y | A6
BANK2A | GPIOT_P_04 |  | RX_DATA_P3_I3 |  | GPIOT_PN_04 | T0 | Y | F7
BANK2A | GPIOT_N_04 |  | RX_DATA_N3_I3 |  | GPIOT_PN_04 | T0 | Y | F8
BANK2A | GPIOT_P_05 |  | RX_DATA_P4_I3 |  | GPIOT_PN_05 | T0 | Y | E7
BANK2A | GPIOT_N_05 |  | RX_DATA_N4_I3 |  | GPIOT_PN_05 | T0 | Y | D7
BANK2A | GPIOT_P_06 |  | RX_DATA_P0_I4 |  | GPIOT_PN_06 | T0 | Y | B7
BANK2A | GPIOT_N_06 |  | RX_DATA_N0_I4 |  | GPIOT_PN_06 | T0 | Y | A7
BANK2A | GPIOT_P_07_CLK4_P |  | RX_DATA_P1_I4 |  | GPIOT_PN_07 | T0 | Y | B8
BANK2A | GPIOT_N_07_CLK4_N |  | RX_DATA_N1_I4 |  | GPIOT_PN_07 | T0 | Y | A8
BANK2B | GPIOT_P_09_CLK6_P |  | RX_CLK_P_I4 |  | GPIOT_PN_09 | T1 | Y | E8
BANK2B | GPIOT_N_09_CLK6_N |  | RX_CLK_N_I4 |  | GPIOT_PN_09 | T1 | Y | D8
BANK2B | GPIOT_P_10_CLK7_P |  | RX_DATA_P3_I4 |  | GPIOT_PN_10 | T1 | Y | C8
BANK2B | GPIOT_N_10_CLK7_N |  | RX_DATA_N3_I4 |  | GPIOT_PN_10 | T1 | Y | C9
BANK2B | GPIOT_P_11 |  | RX_DATA_P4_I4 |  | GPIOT_PN_11 | T1 | Y | B9
BANK2B | GPIOT_N_11 |  | RX_DATA_N4_I4 |  | GPIOT_PN_11 | T1 | Y | A9
BANK2B | GPIOT_P_12 |  | RX_DATA_P0_I5 |  | GPIOT_PN_12 | T1 | Y | F9
BANK2B | GPIOT_N_12 |  | RX_DATA_N0_I5 |  | GPIOT_PN_12 | T1 | Y | E9
BANK2B | GPIOT_P_13 |  | RX_DATA_P1_I5 | VREF2B | GPIOT_PN_13 | T1 | Y | C10
BANK2B | GPIOT_N_13 |  | RX_DATA_N1_I5 |  | GPIOT_PN_13 | T1 | Y | D10
BANK2B | GPIOT_P_14 |  | RX_CLK_P_I5 |  | GPIOT_PN_14 | T1 | Y | A10
BANK2B | GPIOT_N_14 |  | RX_CLK_N_I5 |  | GPIOT_PN_14 | T1 | Y | B10
BANK2B | GPIOT_P_16_EXTFB |  | RX_DATA_P3_I5 |  | GPIOT_PN_16 | T1 | Y | E10
BANK2B | GPIOT_N_16 |  | RX_DATA_N3_I5 |  | GPIOT_PN_16 | T1 | Y | F10
BANK2B | GPIOT_P_17_PLLIN1 |  | RX_DATA_P4_I5 |  | GPIOT_PN_17 | T1 | Y | A11
BANK2B | GPIOT_N_17 |  | RX_DATA_N4_I5 |  | GPIOT_PN_17 | T1 | Y | B11
BANK2B | REF_RES_2B |  |  |  |  |  |  | D11
TR | GPIOR_12 |  |  |  |  | T1 | Y | A13
TR | GPIOR_13 |  |  |  |  | T1 | Y | A12
TR | GPIOR_15 |  |  |  |  | T1 | Y | B12
TR | GPIOR_16 |  |  |  |  | T1 | Y | C12
TR | GPIOR_18 |  |  |  |  | T1 | Y | B14
TR | GPIOR_19 |  |  |  |  | T1 | Y | A14
TR | GPIOR_20 |  |  |  |  | T1 | Y | D12
BANK3A | REF_RES_3A |  |  |  |  |  |  | B15
BANK3A | GPIOR_N_19 |  | RX_DATA_N3_I8 |  | GPIOR_PN_19 | R7 | Y | C15
BANK3A | GPIOR_P_19_PLLIN0 |  | RX_DATA_P3_I8 |  | GPIOR_PN_19 | R7 | Y | C14
BANK3A | GPIOR_N_18 |  | RX_DATA_N2_I8 |  | GPIOR_PN_18 | R6, R7 | Y | D14
BANK3A | GPIOR_P_18 |  | RX_DATA_P2_I8 |  | GPIOR_PN_18 | R6, R7 | Y | D15
BANK3A | GPIOR_N_17 |  | RX_CLK_N_I8 |  | GPIOR_PN_17 | R6 | Y | D13
BANK3A | GPIOR_P_17 |  | RX_CLK_P_I8 |  | GPIOR_PN_17 | R6 | Y | C13
BANK3A | GPIOR_N_16 |  | RX_DATA_N1_I8 |  | GPIOR_PN_16 | R6 | Y | E14
BANK3A | GPIOR_P_16 |  | RX_DATA_P1_I8 |  | GPIOR_PN_16 | R6 | Y | E15
BANK3A | GPIOR_N_15 |  | RX_DATA_N0_I8 |  | GPIOR_PN_15 | R6 | Y | E12
BANK3A | GPIOR_P_15 |  | RX_DATA_P0_I8 |  | GPIOR_PN_15 | R6 | Y | F12
BANK3A | GPIOR_N_14 |  | RX_DATA_N7_I7 |  | GPIOR_PN_14 | R5 | Y | F11
BANK3A | GPIOR_P_14 |  | RX_DATA_P7_I7 |  | GPIOR_PN_14 | R5 | Y | G11
BANK3A | GPIOR_N_13 |  | RX_DATA_N6_I7 |  | GPIOR_PN_13 | R5 | Y | F15
BANK3A | GPIOR_P_13 |  | RX_DATA_P6_I7 | VREF3A | GPIOR_PN_13 | R5 | Y | G15
BANK3A | GPIOR_N_12 |  | RX_DATA_N5_I7 |  | GPIOR_PN_12 | R4 | Y | F13
BANK3A | GPIOR_P_12 |  | RX_DATA_P5_I7 |  | GPIOR_PN_12 | R4 | Y | G13
BANK3A | GPIOR_N_11_CLK8_N |  | RX_DATA_N4_I7 |  | GPIOR_PN_11 | R4 | Y | G14
BANK3A | GPIOR_P_11_CLK8_P |  | RX_DATA_P4_I7 |  | GPIOR_PN_11 | R4 | Y | H14
BANK3A | GPIOR_N_10_CLK9_N |  | RX_CLK_N_I7 |  | GPIOR_PN_10 | R4 | Y | H12
BANK3A | GPIOR_P_10_CLK9_P |  | RX_CLK_P_I7 |  | GPIOR_PN_10 | R4 | Y | H13
BANK3B | GPIOR_N_09_CLK10_N |  | RX_DATA_N3_I7 |  | GPIOR_PN_09 | R3 | Y | H15
BANK3B | GPIOR_P_09_CLK10_P |  | RX_DATA_P3_I7 |  | GPIOR_PN_09 | R3 | Y | J15
BANK3B | GPIOR_N_08_CLK11_N |  | RX_DATA_N2_I7 |  | GPIOR_PN_08 | R3 | Y | H11
BANK3B | GPIOR_P_08_CLK11_P |  | RX_DATA_P2_I7 |  | GPIOR_PN_08 | R3 | Y | H10
BANK3B | GPIOR_N_07 |  | RX_DATA_N1_I7 |  | GPIOR_PN_07 | R3 | Y | J14
BANK3B | GPIOR_P_07 |  | RX_DATA_P1_I7 |  | GPIOR_PN_07 | R3 | Y | K14
BANK3B | GPIOR_N_06_CDI21 | CDI21 | RX_DATA_N0_I7 |  | GPIOR_PN_06 | R2 | Y | J13
BANK3B | GPIOR_P_06_CDI20 | CDI20 | RX_DATA_P0_I7 |  | GPIOR_PN_06 | R2 | Y | K13
BANK3B | GPIOR_N_05_CDI31 | CDI31 | RX_DATA_N4_I6 |  | GPIOR_PN_05 | R2 | Y | K15
BANK3B | GPIOR_P_05_CDI30 | CDI30 | RX_DATA_P4_I6 | VREF3B | GPIOR_PN_05 | R2 | Y | L15
BANK3B | GPIOR_N_04_CDI29 | CDI29 | RX_DATA_N3_I6 |  | GPIOR_PN_04 | R1 | Y | J12
BANK3B | GPIOR_P_04_CDI28 | CDI28 | RX_DATA_P3_I6 |  | GPIOR_PN_04 | R1 | Y | K12
BANK3B | GPIOR_N_03_CDI27 | CDI27 | RX_DATA_N2_I6 |  | GPIOR_PN_03 | R1 | Y | J10
BANK3B | GPIOR_P_03_CDI26 | CDI26 | RX_DATA_P2_I6 |  | GPIOR_PN_03 | R1 | Y | K10
BANK3B | GPIOR_N_02_CDI25 | CDI25 | RX_CLK_N_I6 |  | GPIOR_PN_02 | R1 | Y | M15
BANK3B | GPIOR_P_02_CDI24 | CDI24 | RX_CLK_P_I6 |  | GPIOR_PN_02 | R1 | Y | M14
BANK3B | GPIOR_N_01_CDI23 | CDI23 | RX_DATA_N1_I6 |  | GPIOR_PN_01 | R0 | Y | L13
BANK3B | GPIOR_P_01_EXTFB |  | RX_DATA_P1_I6 |  | GPIOR_PN_01 | R0 | Y | L12
BANK3B | GPIOR_N_00_CDI22 | CDI22 | RX_DATA_N0_I6 |  | GPIOR_PN_00 | R0 | Y | K11
BANK3B | GPIOR_P_00_PLLIN0 |  | RX_DATA_P0_I6 |  | GPIOR_PN_00 | R0 | Y | L11
BANK3B | REF_RES_3B |  |  |  |  |  |  | M12
BR | GPIOR_21 |  |  |  |  | B1 | Y | N14
BR | GPIOR_22 |  |  |  |  | B1 | Y | P14
BR | GPIOR_24 |  |  |  |  | B1 | Y | N13
BR | GPIOR_25 |  |  |  |  | B1 | Y | P15
BR | GPIOR_27 |  |  |  |  | B1 | Y | P13
BR | GPIOR_28 |  |  |  |  | B1 | Y | R14
BR | GPIOR_29_PLLIN2 |  |  |  |  | B1 | Y | R13
BANK4A | REF_RES_4A |  |  |  |  |  |  | N12
BANK4A | GPIOB_N_17 |  | RX_DATA_N4_I11 |  | GPIOB_PN_17 | B1 | Y | P12
BANK4A | GPIOB_P_17_PLLIN1 |  | RX_DATA_P4_I11 |  | GPIOB_PN_17 | B1 | Y | P11
BANK4A | GPIOB_N_15_CDI19 | CDI19 | RX_DATA_N2_I11 |  | GPIOB_PN_15 | B1 | Y | R11
BANK4A | GPIOB_P_15_CDI18 | CDI18 | RX_DATA_P2_I11 |  | GPIOB_PN_15 | B1 | Y | R12
BANK4A | GPIOB_N_14_CDI17 | CDI17 | RX_CLK_N_I11 |  | GPIOB_PN_14 | B1 | Y | P10
BANK4A | GPIOB_P_14_CDI16 | CDI16 | RX_CLK_P_I11 |  | GPIOB_PN_14 | B1 | Y | R10
BANK4A | GPIOB_N_13_CDI15 | CDI15 | RX_DATA_N1_I11 |  | GPIOB_PN_13 | B1 | Y | M10
BANK4A | GPIOB_P_13_CDI14 | CDI14 | RX_DATA_P1_I11 |  | GPIOB_PN_13 | B1 | Y | N10
BANK4A | GPIOB_N_12_CDI13 | CDI13 | RX_DATA_N0_I11 |  | GPIOB_PN_12 | B1 | Y | P9
BANK4A | GPIOB_P_12_CDI12 | CDI12 | RX_DATA_P0_I11 |  | GPIOB_PN_12 | B1 | Y | R9
BANK4A | GPIOB_N_11_CDI11 | CDI11 | RX_DATA_N4_I10 |  | GPIOB_PN_11 | B1 | Y | K9
BANK4A | GPIOB_P_11_CDI10 | CDI10 | RX_DATA_P4_I10 |  | GPIOB_PN_11 | B1 | Y | K8
BANK4A | GPIOB_N_10_CLK12_N |  | RX_DATA_N3_I10 |  | GPIOB_PN_10 | B1 | Y | L9
BANK4A | GPIOB_P_10_CLK12_P |  | RX_DATA_P3_I10 |  | GPIOB_PN_10 | B1 | Y | M9
BANK4A | GPIOB_N_09_CLK13_N |  | RX_CLK_N_I10 |  | GPIOB_PN_09 | B1 | Y | L8
BANK4A | GPIOB_P_09_CLK13_P |  | RX_CLK_P_I10 | VREF4A | GPIOB_PN_09 | B1 | Y | K7
BANK4B | GPIOB_N_08_CLK14_N |  | RX_DATA_N2_I10 |  | GPIOB_PN_08 | B0 | Y | M8
BANK4B | GPIOB_P_08_CLK14_P |  | RX_DATA_P2_I10 |  | GPIOB_PN_08 | B0 | Y | N8
BANK4B | GPIOB_N_07_CLK15_N |  | RX_DATA_N1_I10 |  | GPIOB_PN_07 | B0 | Y | P8
BANK4B | GPIOB_P_07_CLK15_P |  | RX_DATA_P1_I10 |  | GPIOB_PN_07 | B0 | Y | R8
BANK4B | GPIOB_N_06_CDI9 | CDI9 | RX_DATA_N0_I10 |  | GPIOB_PN_06 | B0 | Y | L7
BANK4B | GPIOB_P_06_CDI8 | CDI8 | RX_DATA_P0_I10 |  | GPIOB_PN_06 | B0 | Y | M7
BANK4B | GPIOB_N_04 |  | RX_DATA_N3_I9 |  | GPIOB_PN_04 | B0 | Y | K6
BANK4B | GPIOB_P_04_SSU_N | SSU_N | RX_DATA_P3_I9 | VREF4B | GPIOB_PN_04 | B0 | Y | L6
BANK4B | GPIOB_N_03_CDI7 | CDI7 | RX_CLK_N_I9 |  | GPIOB_PN_03 | B0 | Y | M6
BANK4B | GPIOB_P_03_CDI6 | CDI6 | RX_CLK_P_I9 |  | GPIOB_PN_03 | B0 | Y | N6
BANK4B | GPIOB_N_02_CDI5 | CDI5 | RX_DATA_N2_I9 |  | GPIOB_PN_02 | B0 | Y | P7
BANK4B | GPIOB_P_02_CDI4 | CDI4 | RX_DATA_P2_I9 |  | GPIOB_PN_02 | B0 | Y | R7
BANK4B | GPIOB_N_01 |  | RX_DATA_N1_I9 |  | GPIOB_PN_01 | B0 | Y | P6
BANK4B | GPIOB_P_01_EXTFB |  | RX_DATA_P1_I9 |  | GPIOB_PN_01 | B0 | Y | R6
BANK4B | GPIOB_N_00 |  | RX_DATA_N0_I9 |  | GPIOB_PN_00 | B0 | Y | P5
BANK4B | GPIOB_P_00_PLLIN1 |  | RX_DATA_P0_I9 |  | GPIOB_PN_00 | B0 | Y | R5
BANK4B | REF_RES_4B |  |  |  |  |  |  | M5
 | VCC |  |  |  |  |  |  | M3
 | VCC |  |  |  |  |  |  | H6
 | VCC |  |  |  |  |  |  | G7
 | VCC |  |  |  |  |  |  | J7
 | VCC |  |  |  |  |  |  | H8
 | VCC |  |  |  |  |  |  | G9
 | VCC |  |  |  |  |  |  | J9
 | VCC |  |  |  |  |  |  | E13
 | VCCA_BL |  |  |  |  |  |  | L5
 | VCCA_BR |  |  |  |  |  |  | L10
 | VCCA_TL |  |  |  |  |  |  | E5
 | VCCA_TR |  |  |  |  |  |  | G10
 | VCCAUX |  |  |  |  |  |  | D4
 | VCCAUX |  |  |  |  |  |  | L4
 | VCCAUX |  |  |  |  |  |  | E11
 | VCCAUX |  |  |  |  |  |  | M11
 | VCCIO1A |  |  |  |  |  |  | L2
 | VCCIO1A |  |  |  |  |  |  | J4
 | VCCIO1B |  |  |  |  |  |  | D2
 | VCCIO1B |  |  |  |  |  |  | F4
 | VCCIO2A |  |  |  |  |  |  | D6
 | VCCIO2A |  |  |  |  |  |  | C7
 | VCCIO2B |  |  |  |  |  |  | D9
 | VCCIO2B |  |  |  |  |  |  | C11
 | VCCIO33_BL |  |  |  |  |  |  | P4
 | VCCIO33_BR |  |  |  |  |  |  | N15
 | VCCIO33_TL |  |  |  |  |  |  | B4
 | VCCIO33_TR |  |  |  |  |  |  | B13
 | VCCIO3A |  |  |  |  |  |  | G12
 | VCCIO3A |  |  |  |  |  |  | F14
 | VCCIO3B |  |  |  |  |  |  | J11
 | VCCIO3B |  |  |  |  |  |  | L14
 | VCCIO4A |  |  |  |  |  |  | N9
 | VCCIO4A |  |  |  |  |  |  | N11
 | VCCIO4B |  |  |  |  |  |  | N5
 | VCCIO4B |  |  |  |  |  |  | N7
 | VQPS_GND |  |  |  |  |  |  | G6
 | GND |  |  |  |  |  |  | A1
 | GND |  |  |  |  |  |  | R1
 | GND |  |  |  |  |  |  | D3
 | GND |  |  |  |  |  |  | J6
 | GND |  |  |  |  |  |  | H7
 | GND |  |  |  |  |  |  | G8
 | GND |  |  |  |  |  |  | J8
 | GND |  |  |  |  |  |  | H9
 | GND |  |  |  |  |  |  | M13
 | GND |  |  |  |  |  |  | A15
 | GND |  |  |  |  |  |  | R15

Sheet: F256
© 2024
Bank Number | Pin Names | Configuration Functions | MIPI RX Function | VREF Function for HSTL/SSTL | LVDS and MIPI Pairs | Clock Region | DDIO | FBGA256
BL | GPIOL_01 |  |  |  |  | B0 | Y | N5
BL | GPIOL_02 |  |  |  |  | B0 | Y | N4
BL | TDI | TDI |  |  |  |  |  | T3 | Note:
BL | TCK | TCK |  |  |  |  |  | T2 | VCCIOxx_yy_zz indicates Power for I/O banks that are shorted together.
BL | TMS | TMS |  |  |  |  |  | P3 | xx, yy, and zz are the bank locations
BL | TDO | TDO |  |  |  |  |  | R3 | For example, VCCIO1B_1C shorts banks 1B and 1C
BANK1A | REF_RES_1A |  |  |  |  |  |  | J6
BANK1A | CDONE | CDONE |  |  |  |  |  | K5
BANK1A | CRESET_N | CRESET_N |  |  |  |  |  | J5
BANK1A | GPIOL_P_00_PLLIN0 |  | RX_DATA_P0_I0 |  | GPIOL_PN_00 | L0 | Y | M5
BANK1A | GPIOL_N_00 |  | RX_DATA_N0_I0 |  | GPIOL_PN_00 | L0 | Y | M4
BANK1A | GPIOL_P_01_SSL_N | SSL_N | RX_DATA_P1_I0 |  | GPIOL_PN_01 | L0 | Y | R1
BANK1A | GPIOL_N_01_CCK | CCK | RX_DATA_N1_I0 |  | GPIOL_PN_01 | L0 | Y | P1
BANK1A | GPIOL_P_02_CSI | CSI | RX_CLK_P_I0 |  | GPIOL_PN_02 | L1 | Y | P2
BANK1A | GPIOL_N_02_CSO | CSO | RX_CLK_N_I0 |  | GPIOL_PN_02 | L1 | Y | N3
BANK1A | GPIOL_P_03_CDI0 | CDI0 | RX_DATA_P2_I0 |  | GPIOL_PN_03 | L1 | Y | N2
BANK1A | GPIOL_N_03_CDI1 | CDI1 | RX_DATA_N2_I0 |  | GPIOL_PN_03 | L1 | Y | M2
BANK1A | GPIOL_P_04_CDI2 | CDI2 | RX_DATA_P3_I0 | VREF1A | GPIOL_PN_04 | L1 | Y | M1
BANK1A | GPIOL_N_04_CDI3 | CDI3 | RX_DATA_N3_I0 |  | GPIOL_PN_04 | L1 | Y | L1
BANK1A | GPIOL_P_05 |  | RX_DATA_P0_I1 |  | GPIOL_PN_05 | L2 | Y | L3
BANK1A | GPIOL_N_05 |  | RX_DATA_N0_I1 |  | GPIOL_PN_05 | L2 | Y | L2
BANK1A | GPIOL_P_06 |  | RX_DATA_P1_I1 |  | GPIOL_PN_06 | L2 | Y | L4
BANK1A | GPIOL_N_06 |  | RX_DATA_N1_I1 |  | GPIOL_PN_06 | L2 | Y | K4
BANK1A | GPIOL_P_07_CLK0_P |  | RX_DATA_P2_I1 |  | GPIOL_PN_07 | L3 | Y | K3
BANK1A | GPIOL_N_07_CLK0_N |  | RX_DATA_N2_I1 |  | GPIOL_PN_07 | L3 | Y | J3
BANK1A | GPIOL_P_08_CLK1_P | EXT_CONFIG_CLK | RX_DATA_P3_I1 |  | GPIOL_PN_08 | L3 | Y | K1
BANK1A | GPIOL_N_08_CLK1_N |  | RX_DATA_N3_I1 |  | GPIOL_PN_08 | L3 | Y | J1
BANK1B | GPIOL_P_09_CLK2_P |  | RX_CLK_P_I1 |  | GPIOL_PN_09 | L4 | Y | J2
BANK1B | GPIOL_N_09_CLK2_N |  | RX_CLK_N_I1 |  | GPIOL_PN_09 | L4 | Y | H2
BANK1B | GPIOL_P_10_CLK3_P |  | RX_DATA_P4_I1 |  | GPIOL_PN_10 | L4 | Y | G2
BANK1B | GPIOL_N_10_CLK3_N |  | RX_DATA_N4_I1 |  | GPIOL_PN_10 | L4 | Y | G1
BANK1B | GPIOL_P_11 |  | RX_DATA_P5_I1 |  | GPIOL_PN_11 | L4 | Y | H4
BANK1B | GPIOL_N_11 |  | RX_DATA_N5_I1 |  | GPIOL_PN_11 | L4 | Y | H3
BANK1B | GPIOL_P_12 |  | RX_DATA_P6_I1 |  | GPIOL_PN_12 | L5 | Y | F2
BANK1B | GPIOL_N_12 |  | RX_DATA_N6_I1 |  | GPIOL_PN_12 | L5 | Y | F1
BANK1B | GPIOL_P_13_CBSEL0 | CBSEL0 | RX_DATA_P7_I1 |  | GPIOL_PN_13 | L5 | Y | E1
BANK1B | GPIOL_N_13_CBSEL1 | CBSEL1 | RX_DATA_N7_I1 |  | GPIOL_PN_13 | L5 | Y | D1
BANK1B | GPIOL_P_14 |  | RX_DATA_P0_I2 |  | GPIOL_PN_14 | L6 | Y | G5
BANK1B | GPIOL_N_14 |  | RX_DATA_N0_I2 |  | GPIOL_PN_14 | L6 | Y | G4
BANK1B | GPIOL_P_15_NSTATUS | NSTATUS | RX_DATA_P1_I2 | VREF1B | GPIOL_PN_15 | L6 | Y | F4
BANK1B | GPIOL_N_15_TEST_N | TEST_N | RX_DATA_N1_I2 |  | GPIOL_PN_15 | L6 | Y | F3
BANK1B | GPIOL_P_16 |  | RX_CLK_P_I2 |  | GPIOL_PN_16 | L6 | Y | D3
BANK1B | GPIOL_N_16 |  | RX_CLK_N_I2 |  | GPIOL_PN_16 | L6 | Y | D2
BANK1B | GPIOL_P_17_EXTFB |  | RX_DATA_P2_I2 |  | GPIOL_PN_17 | L6,L7 | Y | E4
BANK1B | GPIOL_N_17 |  | RX_DATA_N2_I2 |  | GPIOL_PN_17 | L6,L7 | Y | E3
BANK1B | GPIOL_P_18_PLLIN0 |  | RX_DATA_P3_I2 |  | GPIOL_PN_18 | L7 | Y | C3
BANK1B | GPIOL_N_18 |  | RX_DATA_N3_I2 |  | GPIOL_PN_18 | L7 | Y | C2
BANK1B | REF_RES_1B |  |  |  |  |  |  | H5
TL | GPIOL_03 |  |  |  |  | T0 | Y | E5
TL | GPIOL_04 |  |  |  |  | T0 | Y | D5
TL | GPIOL_06 |  |  |  |  | T0 | Y | B1
TL | GPIOL_07 |  |  |  |  | T0 | Y | A2
TL | GPIOL_09 |  |  |  |  | T0 | Y | B2
TL | GPIOL_10 |  |  |  |  | T0 | Y | A3
TL | GPIOL_11_PLLIN2 |  |  |  |  | T0 | Y | C4
BANK2A | REF_RES_2A |  |  |  |  |  |  | F8
BANK2A | GPIOT_P_00_PLLIN1 |  | RX_DATA_P0_I3 | VREF2A | GPIOT_PN_00 | T0 | Y | D6
BANK2A | GPIOT_N_00 |  | RX_DATA_N0_I3 |  | GPIOT_PN_00 | T0 | Y | E6
BANK2A | GPIOT_P_01 |  | RX_DATA_P1_I3 |  | GPIOT_PN_01 | T0 | Y | B5
BANK2A | GPIOT_N_01 |  | RX_DATA_N1_I3 |  | GPIOT_PN_01 | T0 | Y | C5
BANK2A | GPIOT_P_03 |  | RX_CLK_P_I3 |  | GPIOT_PN_03 | T0 | Y | A4
BANK2A | GPIOT_N_03 |  | RX_CLK_N_I3 |  | GPIOT_PN_03 | T0 | Y | B4
BANK2A | GPIOT_P_04 |  | RX_DATA_P3_I3 |  | GPIOT_PN_04 | T0 | Y | D7
BANK2A | GPIOT_N_04 |  | RX_DATA_N3_I3 |  | GPIOT_PN_04 | T0 | Y | E8
BANK2A | GPIOT_P_05 |  | RX_DATA_P4_I3 |  | GPIOT_PN_05 | T0 | Y | A6
BANK2A | GPIOT_N_05 |  | RX_DATA_N4_I3 |  | GPIOT_PN_05 | T0 | Y | B6
BANK2A | GPIOT_P_06 |  | RX_DATA_P0_I4 |  | GPIOT_PN_06 | T0 | Y | B7
BANK2A | GPIOT_N_06 |  | RX_DATA_N0_I4 |  | GPIOT_PN_06 | T0 | Y | C7
BANK2A | GPIOT_P_07_CLK4_P |  | RX_DATA_P1_I4 |  | GPIOT_PN_07 | T0 | Y | C8
BANK2A | GPIOT_N_07_CLK4_N |  | RX_DATA_N1_I4 |  | GPIOT_PN_07 | T0 | Y | D8
BANK2A | GPIOT_P_08_CLK5_P |  | RX_DATA_P2_I4 |  | GPIOT_PN_08 | T0 | Y | A8
BANK2A | GPIOT_N_08_CLK5_N |  | RX_DATA_N2_I4 |  | GPIOT_PN_08 | T0 | Y | A7
BANK2B | GPIOT_P_09_CLK6_P |  | RX_CLK_P_I4 |  | GPIOT_PN_09 | T1 | Y | A9
BANK2B | GPIOT_N_09_CLK6_N |  | RX_CLK_N_I4 |  | GPIOT_PN_09 | T1 | Y | B9
BANK2B | GPIOT_P_10_CLK7_P |  | RX_DATA_P3_I4 |  | GPIOT_PN_10 | T1 | Y | B10
BANK2B | GPIOT_N_10_CLK7_N |  | RX_DATA_N3_I4 |  | GPIOT_PN_10 | T1 | Y | C9
BANK2B | GPIOT_P_11 |  | RX_DATA_P4_I4 |  | GPIOT_PN_11 | T1 | Y | E9
BANK2B | GPIOT_N_11 |  | RX_DATA_N4_I4 |  | GPIOT_PN_11 | T1 | Y | F9
BANK2B | GPIOT_P_12 |  | RX_DATA_P0_I5 |  | GPIOT_PN_12 | T1 | Y | C10
BANK2B | GPIOT_N_12 |  | RX_DATA_N0_I5 |  | GPIOT_PN_12 | T1 | Y | D10
BANK2B | GPIOT_P_13 |  | RX_DATA_P1_I5 | VREF2B | GPIOT_PN_13 | T1 | Y | A11
BANK2B | GPIOT_N_13 |  | RX_DATA_N1_I5 |  | GPIOT_PN_13 | T1 | Y | B11
BANK2B | GPIOT_P_14 |  | RX_CLK_P_I5 |  | GPIOT_PN_14 | T1 | Y | E11
BANK2B | GPIOT_N_14 |  | RX_CLK_N_I5 |  | GPIOT_PN_14 | T1 | Y | E10
BANK2B | GPIOT_P_16_EXTFB |  | RX_DATA_P3_I5 |  | GPIOT_PN_16 | T1 | Y | B12
BANK2B | GPIOT_N_16 |  | RX_DATA_N3_I5 |  | GPIOT_PN_16 | T1 | Y | C12
BANK2B | GPIOT_P_17_PLLIN1 |  | RX_DATA_P4_I5 |  | GPIOT_PN_17 | T1 | Y | D12
BANK2B | GPIOT_N_17 |  | RX_DATA_N4_I5 |  | GPIOT_PN_17 | T1 | Y | D11
BANK2B | REF_RES_2B |  |  |  |  |  |  | F10
TR | GPIOR_12 |  |  |  |  | T1 | Y | A12
TR | GPIOR_13 |  |  |  |  | T1 | Y | A13
TR | GPIOR_14 |  |  |  |  | T1 | Y | C13
TR | GPIOR_15 |  |  |  |  | T1 | Y | A14
TR | GPIOR_16 |  |  |  |  | T1 | Y | A15
TR | GPIOR_17 |  |  |  |  | T1 | Y | B14
TR | GPIOR_18 |  |  |  |  | T1 | Y | D13
TR | GPIOR_19 |  |  |  |  | T1 | Y | C14
TR | GPIOR_20 |  |  |  |  | T1 | Y | E13
BANK3A | REF_RES_3A |  |  |  |  |  |  | H11
BANK3A | GPIOR_N_19 |  | RX_DATA_N3_I8 |  | GPIOR_PN_19 | R7 | Y | B16
BANK3A | GPIOR_P_19_PLLIN0 |  | RX_DATA_P3_I8 |  | GPIOR_PN_19 | R7 | Y | B15
BANK3A | GPIOR_N_18 |  | RX_DATA_N2_I8 |  | GPIOR_PN_18 | R6,R7 | Y | D15
BANK3A | GPIOR_P_18 |  | RX_DATA_P2_I8 |  | GPIOR_PN_18 | R6,R7 | Y | C15
BANK3A | GPIOR_N_17 |  | RX_CLK_N_I8 |  | GPIOR_PN_17 | R6 | Y | F14
BANK3A | GPIOR_P_17 |  | RX_CLK_P_I8 |  | GPIOR_PN_17 | R6 | Y | E14
BANK3A | GPIOR_N_16 |  | RX_DATA_N1_I8 |  | GPIOR_PN_16 | R6 | Y | F13
BANK3A | GPIOR_P_16 |  | RX_DATA_P1_I8 |  | GPIOR_PN_16 | R6 | Y | F12
BANK3A | GPIOR_N_15 |  | RX_DATA_N0_I8 |  | GPIOR_PN_15 | R6 | Y | D16
BANK3A | GPIOR_P_15 |  | RX_DATA_P0_I8 |  | GPIOR_PN_15 | R6 | Y | E15
BANK3A | GPIOR_N_14 |  | RX_DATA_N7_I7 |  | GPIOR_PN_14 | R5 | Y | H12
BANK3A | GPIOR_P_14 |  | RX_DATA_P7_I7 |  | GPIOR_PN_14 | R5 | Y | G12
BANK3A | GPIOR_N_13 |  | RX_DATA_N6_I7 |  | GPIOR_PN_13 | R5 | Y | F16
BANK3A | GPIOR_P_13 |  | RX_DATA_P6_I7 | VREF3A | GPIOR_PN_13 | R5 | Y | E16
BANK3A | GPIOR_N_12 |  | RX_DATA_N5_I7 |  | GPIOR_PN_12 | R4 | Y | G16
BANK3A | GPIOR_P_12 |  | RX_DATA_P5_I7 |  | GPIOR_PN_12 | R4 | Y | G15
BANK3A | GPIOR_N_11_CLK8_N |  | RX_DATA_N4_I7 |  | GPIOR_PN_11 | R4 | Y | H14
BANK3A | GPIOR_P_11_CLK8_P |  | RX_DATA_P4_I7 |  | GPIOR_PN_11 | R4 | Y | H13
BANK3A | GPIOR_N_10_CLK9_N |  | RX_CLK_N_I7 |  | GPIOR_PN_10 | R4 | Y | H15
BANK3A | GPIOR_P_10_CLK9_P |  | RX_CLK_P_I7 |  | GPIOR_PN_10 | R4 | Y | G14
BANK3B | GPIOR_N_09_CLK10_N |  | RX_DATA_N3_I7 |  | GPIOR_PN_09 | R3 | Y | J16
BANK3B | GPIOR_P_09_CLK10_P |  | RX_DATA_P3_I7 |  | GPIOR_PN_09 | R3 | Y | J15
BANK3B | GPIOR_N_08_CLK11_N |  | RX_DATA_N2_I7 |  | GPIOR_PN_08 | R3 | Y | J13
BANK3B | GPIOR_P_08_CLK11_P |  | RX_DATA_P2_I7 |  | GPIOR_PN_08 | R3 | Y | J12
BANK3B | GPIOR_N_07 |  | RX_DATA_N1_I7 |  | GPIOR_PN_07 | R3 | Y | K16
BANK3B | GPIOR_P_07 |  | RX_DATA_P1_I7 |  | GPIOR_PN_07 | R3 | Y | K15
BANK3B | GPIOR_N_06_CDI21 | CDI21 | RX_DATA_N0_I7 |  | GPIOR_PN_06 | R2 | Y | L14
BANK3B | GPIOR_P_06_CDI20 | CDI20 | RX_DATA_P0_I7 |  | GPIOR_PN_06 | R2 | Y | K14
BANK3B | GPIOR_N_05_CDI31 | CDI31 | RX_DATA_N4_I6 |  | GPIOR_PN_05 | R2 | Y | L13
BANK3B | GPIOR_P_05_CDI30 | CDI30 | RX_DATA_P4_I6 | VREF3B | GPIOR_PN_05 | R2 | Y | K13
BANK3B | GPIOR_N_04_CDI29 | CDI29 | RX_DATA_N3_I6 |  | GPIOR_PN_04 | R1 | Y | M16
BANK3B | GPIOR_P_04_CDI28 | CDI28 | RX_DATA_P3_I6 |  | GPIOR_PN_04 | R1 | Y | L16
BANK3B | GPIOR_N_03_CDI27 | CDI27 | RX_DATA_N2_I6 |  | GPIOR_PN_03 | R1 | Y | M15
BANK3B | GPIOR_P_03_CDI26 | CDI26 | RX_DATA_P2_I6 |  | GPIOR_PN_03 | R1 | Y | M14
BANK3B | GPIOR_N_02_CDI25 | CDI25 | RX_CLK_N_I6 |  | GPIOR_PN_02 | R1 | Y | P15
BANK3B | GPIOR_P_02_CDI24 | CDI24 | RX_CLK_P_I6 |  | GPIOR_PN_02 | R1 | Y | P16
BANK3B | GPIOR_N_01_CDI23 | CDI23 | RX_DATA_N1_I6 |  | GPIOR_PN_01 | R0 | Y | N15
BANK3B | GPIOR_P_01_EXTFB |  | RX_DATA_P1_I6 |  | GPIOR_PN_01 | R0 | Y | N14
BANK3B | GPIOR_N_00_CDI22 | CDI22 | RX_DATA_N0_I6 |  | GPIOR_PN_00 | R0 | Y | L12
BANK3B | GPIOR_P_00_PLLIN0 |  | RX_DATA_P0_I6 |  | GPIOR_PN_00 | R0 | Y | L11
BANK3B | REF_RES_3B |  |  |  |  |  |  | J11
BR | GPIOR_21 |  |  |  |  | B1 | Y | R16
BR | GPIOR_22 |  |  |  |  | B1 | Y | N13
BR | GPIOR_23 |  |  |  |  | B1 | Y | M12
BR | GPIOR_24 |  |  |  |  | B1 | Y | R14
BR | GPIOR_25 |  |  |  |  | B1 | Y | R15
BR | GPIOR_26 |  |  |  |  | B1 | Y | N12
BR | GPIOR_27 |  |  |  |  | B1 | Y | P13
BR | GPIOR_28 |  |  |  |  | B1 | Y | R13
BR | GPIOR_29_PLLIN2 |  |  |  |  | B1 | Y | T14
BANK4A | REF_RES_4A |  |  |  |  |  |  | L9
BANK4A | GPIOB_N_17 |  | RX_DATA_N4_I11 |  | GPIOB_PN_17 | B1 | Y | P12
BANK4A | GPIOB_P_17_PLLIN1 |  | RX_DATA_P4_I11 |  | GPIOB_PN_17 | B1 | Y | P11
BANK4A | GPIOB_N_15_CDI19 | CDI19 | RX_DATA_N2_I11 |  | GPIOB_PN_15 | B1 | Y | T13
BANK4A | GPIOB_P_15_CDI18 | CDI18 | RX_DATA_P2_I11 |  | GPIOB_PN_15 | B1 | Y | T12
BANK4A | GPIOB_N_14_CDI17 | CDI17 | RX_CLK_N_I11 |  | GPIOB_PN_14 | B1 | Y | M11
BANK4A | GPIOB_P_14_CDI16 | CDI16 | RX_CLK_P_I11 |  | GPIOB_PN_14 | B1 | Y | M10
BANK4A | GPIOB_N_13_CDI15 | CDI15 | RX_DATA_N1_I11 |  | GPIOB_PN_13 | B1 | Y | R11
BANK4A | GPIOB_P_13_CDI14 | CDI14 | RX_DATA_P1_I11 |  | GPIOB_PN_13 | B1 | Y | T11
BANK4A | GPIOB_N_12_CDI13 | CDI13 | RX_DATA_N0_I11 |  | GPIOB_PN_12 | B1 | Y | P10
BANK4A | GPIOB_P_12_CDI12 | CDI12 | RX_DATA_P0_I11 |  | GPIOB_PN_12 | B1 | Y | R10
BANK4A | GPIOB_N_11_CDI11 | CDI11 | RX_DATA_N4_I10 |  | GPIOB_PN_11 | B1 | Y | R9
BANK4A | GPIOB_P_11_CDI10 | CDI10 | RX_DATA_P4_I10 |  | GPIOB_PN_11 | B1 | Y | T9
BANK4A | GPIOB_N_10_CLK12_N |  | RX_DATA_N3_I10 |  | GPIOB_PN_10 | B1 | Y | N10
BANK4A | GPIOB_P_10_CLK12_P |  | RX_DATA_P3_I10 |  | GPIOB_PN_10 | B1 | Y | N9
BANK4A | GPIOB_N_09_CLK13_N |  | RX_CLK_N_I10 |  | GPIOB_PN_09 | B1 | Y | M9
BANK4A | GPIOB_P_09_CLK13_P |  | RX_CLK_P_I10 | VREF4A | GPIOB_PN_09 | B1 | Y | N8
BANK4B | GPIOB_N_08_CLK14_N |  | RX_DATA_N2_I10 |  | GPIOB_PN_08 | B0 | Y | T8
BANK4B | GPIOB_P_08_CLK14_P |  | RX_DATA_P2_I10 |  | GPIOB_PN_08 | B0 | Y | R8
BANK4B | GPIOB_N_07_CLK15_N |  | RX_DATA_N1_I10 |  | GPIOB_PN_07 | B0 | Y | P7
BANK4B | GPIOB_P_07_CLK15_P |  | RX_DATA_P1_I10 |  | GPIOB_PN_07 | B0 | Y | P8
BANK4B | GPIOB_N_06_CDI9 | CDI9 | RX_DATA_N0_I10 |  | GPIOB_PN_06 | B0 | Y | T6
BANK4B | GPIOB_P_06_CDI8 | CDI8 | RX_DATA_P0_I10 |  | GPIOB_PN_06 | B0 | Y | T7
BANK4B | GPIOB_N_04 |  | RX_DATA_N3_I9 |  | GPIOB_PN_04 | B0 | Y | R6
BANK4B | GPIOB_P_04_SSU_N | SSU_N | RX_DATA_P3_I9 | VREF4B | GPIOB_PN_04 | B0 | Y | P6
BANK4B | GPIOB_N_03_CDI7 | CDI7 | RX_CLK_N_I9 |  | GPIOB_PN_03 | B0 | Y | N7
BANK4B | GPIOB_P_03_CDI6 | CDI6 | RX_CLK_P_I9 |  | GPIOB_PN_03 | B0 | Y | M7
BANK4B | GPIOB_N_02_CDI5 | CDI5 | RX_DATA_N2_I9 |  | GPIOB_PN_02 | B0 | Y | R5
BANK4B | GPIOB_P_02_CDI4 | CDI4 | RX_DATA_P2_I9 |  | GPIOB_PN_02 | B0 | Y | P5
BANK4B | GPIOB_N_01 |  | RX_DATA_N1_I9 |  | GPIOB_PN_01 | B0 | Y | T4
BANK4B | GPIOB_P_01_EXTFB |  | RX_DATA_P1_I9 |  | GPIOB_PN_01 | B0 | Y | R4
BANK4B | GPIOB_N_00 |  | RX_DATA_N0_I9 |  | GPIOB_PN_00 | B0 | Y | M6
BANK4B | GPIOB_P_00_PLLIN1 |  | RX_DATA_P0_I9 |  | GPIOB_PN_00 | B0 | Y | L6
BANK4B | REF_RES_4B |  |  |  |  |  |  | L8
 | VCC |  |  |  |  |  |  | G8
 | VCC |  |  |  |  |  |  | G10
 | VCC |  |  |  |  |  |  | H7
 | VCC |  |  |  |  |  |  | H9
 | VCC |  |  |  |  |  |  | J8
 | VCC |  |  |  |  |  |  | J10
 | VCC |  |  |  |  |  |  | K7
 | VCC |  |  |  |  |  |  | K9
 | VCCA_BL |  |  |  |  |  |  | L7
 | VCCA_BR |  |  |  |  |  |  | L10
 | VCCA_TL |  |  |  |  |  |  | F6
 | VCCA_TR |  |  |  |  |  |  | F11
 | VCCAUX |  |  |  |  |  |  | G6
 | VCCAUX |  |  |  |  |  |  | G11
 | VCCAUX |  |  |  |  |  |  | K6
 | VCCAUX |  |  |  |  |  |  | K11
 | VCCIO1A |  |  |  |  |  |  | J4
 | VCCIO1A |  |  |  |  |  |  | M3
 | VCCIO1B |  |  |  |  |  |  | F5
 | VCCIO1B |  |  |  |  |  |  | G3
 | VCCIO1B |  |  |  |  |  |  | H6
 | VCCIO2A |  |  |  |  |  |  | C6
 | VCCIO2A |  |  |  |  |  |  | E7
 | VCCIO2B |  |  |  |  |  |  | C11
 | VCCIO2B |  |  |  |  |  |  | D9
 | VCCIO33_BL |  |  |  |  |  |  | P4
 | VCCIO33_BR |  |  |  |  |  |  | T15
 | VCCIO33_BR |  |  |  |  |  |  | P14
 | VCCIO33_TL |  |  |  |  |  |  | B3
 | VCCIO33_TR |  |  |  |  |  |  | B13
 | VCCIO33_TR |  |  |  |  |  |  | D14
 | VCCIO3A |  |  |  |  |  |  | C16
 | VCCIO3A |  |  |  |  |  |  | F15
 | VCCIO3A |  |  |  |  |  |  | G13
 | VCCIO3B |  |  |  |  |  |  | J14
 | VCCIO3B |  |  |  |  |  |  | K12
 | VCCIO3B |  |  |  |  |  |  | L15
 | VCCIO4A |  |  |  |  |  |  | M8
 | VCCIO4A |  |  |  |  |  |  | P9
 | VCCIO4B |  |  |  |  |  |  | N6
 | VCCIO4B |  |  |  |  |  |  | R7
 | VCCIO4B |  |  |  |  |  |  | T5
 | VQPS |  |  |  |  |  |  | F7
 | GND |  |  |  |  |  |  | A1
 | GND |  |  |  |  |  |  | A5
 | GND |  |  |  |  |  |  | A10
 | GND |  |  |  |  |  |  | A16
 | GND |  |  |  |  |  |  | B8
 | GND |  |  |  |  |  |  | C1
 | GND |  |  |  |  |  |  | D4
 | GND |  |  |  |  |  |  | E2
 | GND |  |  |  |  |  |  | E12
 | GND |  |  |  |  |  |  | G7
 | GND |  |  |  |  |  |  | G9
 | GND |  |  |  |  |  |  | H1
 | GND |  |  |  |  |  |  | H8
 | GND |  |  |  |  |  |  | H10
 | GND |  |  |  |  |  |  | H16
 | GND |  |  |  |  |  |  | J7
 | GND |  |  |  |  |  |  | J9
 | GND |  |  |  |  |  |  | K2
 | GND |  |  |  |  |  |  | K8
 | GND |  |  |  |  |  |  | K10
 | GND |  |  |  |  |  |  | L5
 | GND |  |  |  |  |  |  | M13
 | GND |  |  |  |  |  |  | N1
 | GND |  |  |  |  |  |  | N11
 | GND |  |  |  |  |  |  | N16
 | GND |  |  |  |  |  |  | R2
 | GND |  |  |  |  |  |  | R12
 | GND |  |  |  |  |  |  | T1
 | GND |  |  |  |  |  |  | T10
 | GND |  |  |  |  |  |  | T16

Sheet: Revision History
Revision History
Date | Version | Package | Remarks
2021-05-16 | 0.1 | All | Initial preliminary release
2021-10-28 | 0.2 | F100, F225 | Updated MIPI function for GPIOL_N_07_CLK0_N from RX_DATA_P2_I1 to RX_DATA_N2_I1
2021-12-03 | 0.3 | W64 | For pin A7, updated Pin Names from GPIOT_P_01 to REF_RES_3A and deleted DDIO support
2022-01-07 | 0.4 | All | Added LVDS and MIPI pairs column
2022-02-07 | 0.5 | All | Added clock region column Final Release
2024-03-08 | 0.6 | All | Changed tab name F100 to F100S3F2. Initial preliminary release for F100 and F256. Corrected typo on MIPI and LVDS name for F225 Pin E10. Updated Efinix Logo, and Configuration Function for JTAG pins.
2024-05-17 | 0.7 | F100 | Removed CDI20-CDI31 from pin name.
 |  | F100S3F2 | Removed CDI20-CDI31 from pin name. Updated pin name for pin A5 to "VQPS_GND".
 |  | F225 | Updated pin name for pin G6 to "VQPS_GND".
 |  | F256 | Corrected package type.
2024-11-06 | 0.8 | F256 | Updated pin mapping for C2,C3,D1,D2,D3,D5,E1,E5,F1,F2,G1,G2,G14,H2,H13,H14,H15,J1,J2,J3,J5,K1,K3,K5,L1,L2,L8,L9,M1,N14,N15,P7,P8
2024-12-11 | 1.0 | F100, F256 | Production release.
2025-07-18 | 1.1 | V64 | Initial release
