kingoflolz/lutcam/software/crates/lwc/Set12-1280x800/08.png

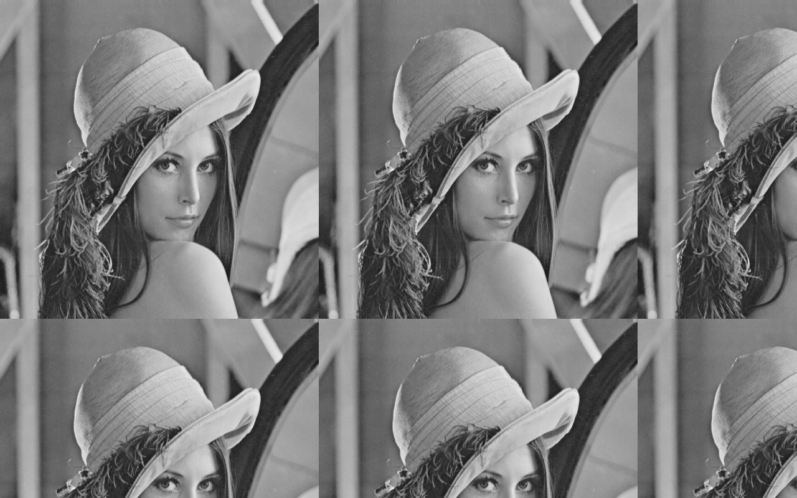
software/crates/lwc/Set12-1280x800/08.png
