kingoflolz/lutcam/software/crates/lwc/Set12-1280x800/09.png

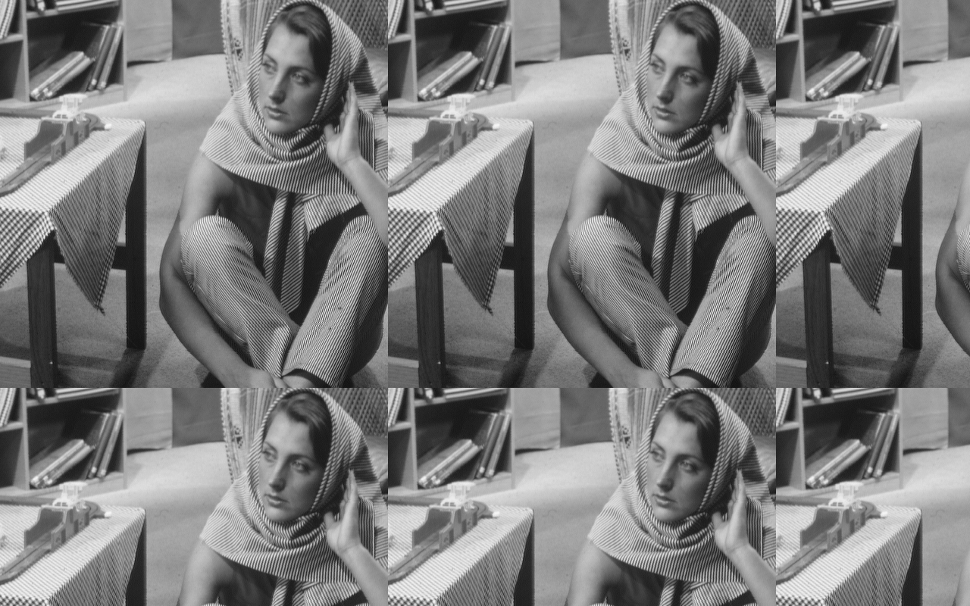
software/crates/lwc/Set12-1280x800/09.png
