kingoflolz/lutcam/software/crates/lwc/Set12-1280x800/10.png

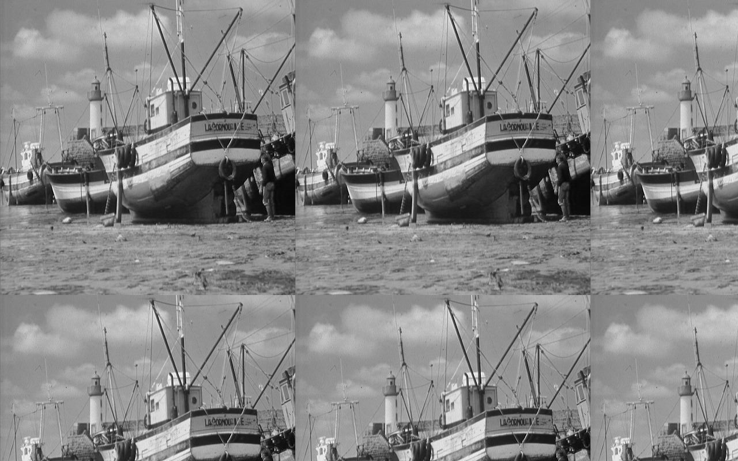
software/crates/lwc/Set12-1280x800/10.png
