kingoflolz/lutcam/hardware/models3d/ABS210.step

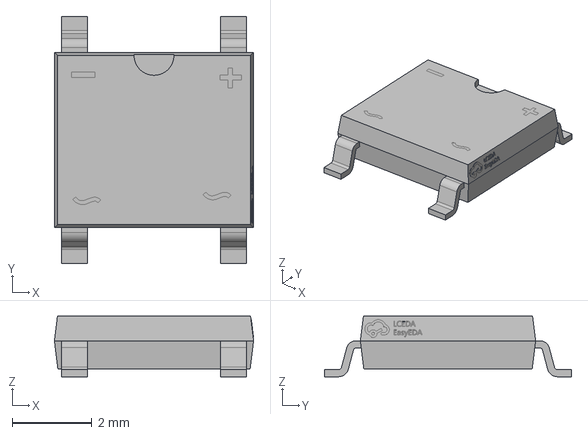
[picture p14: CAD file, 2026-11-08]
hardware/models3d/ABS210.step
5.00 x 6.20 x 1.52 mm
