kingoflolz/lutcam/hardware/models3d/PSPMAA0605H.step

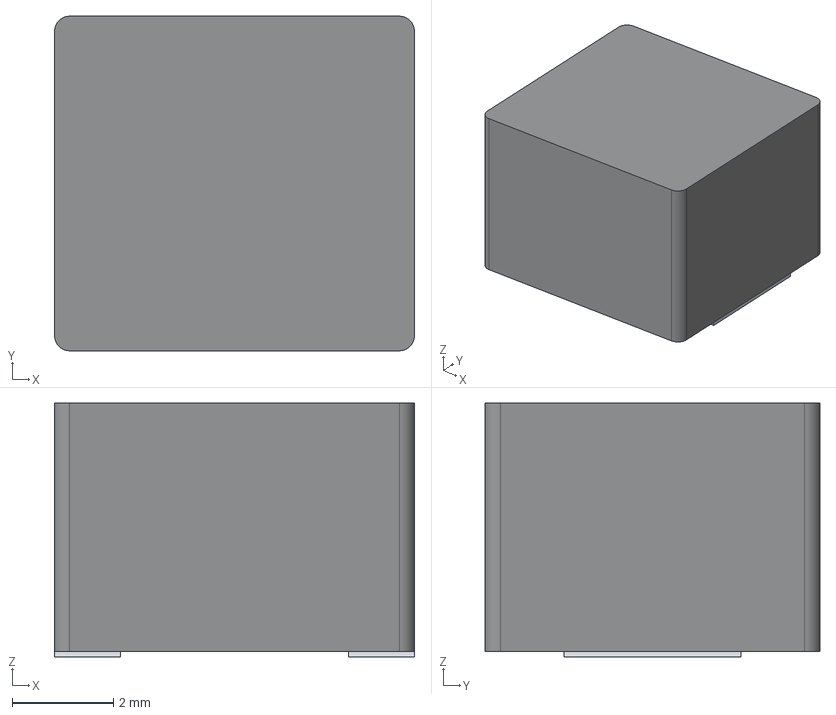
[picture p15: CAD file, 2026-11-08]
hardware/models3d/PSPMAA0605H.step
7.10 x 6.60 x 5.00 mm
molded_body
terminal_1
terminal_2
