kingoflolz/lutcam/hardware/models3d/Generic_M8_LensHolder_20mm.step

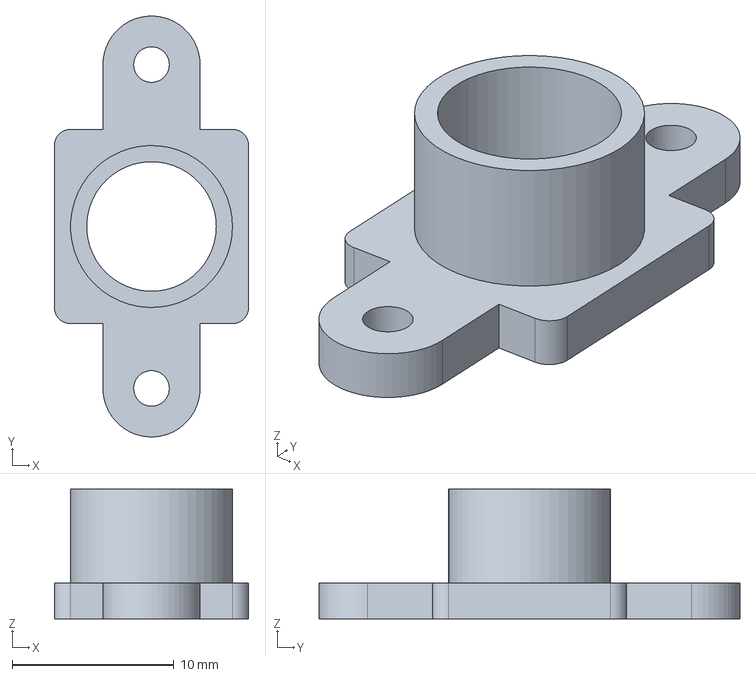
[picture p16: CAD file, 2026-11-08]
hardware/models3d/Generic_M8_LensHolder_20mm.step
12.0 x 26.0 x 8.00 mm
