kingoflolz/lutcam/hardware/models3d/YXC_OSC_1612.step

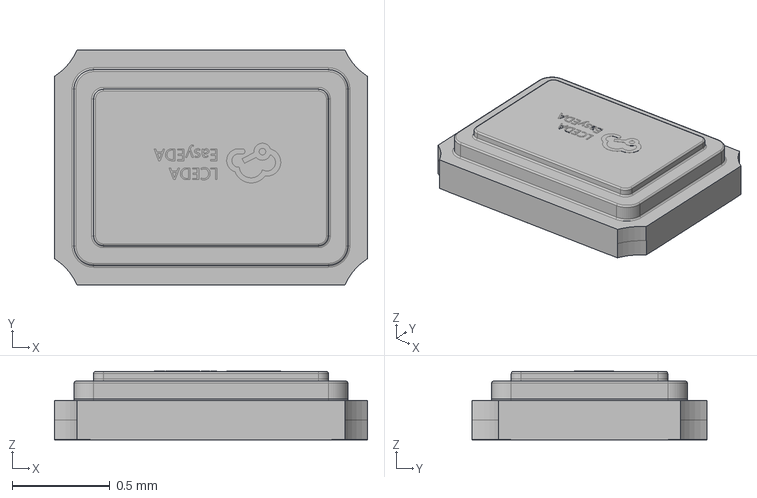
[picture p17: CAD file, 2026-11-08]
hardware/models3d/YXC_OSC_1612.step
1.60 x 1.20 x 0.351 mm
