kingoflolz/lutcam/hardware/models3d/D_PowerDI-5.step

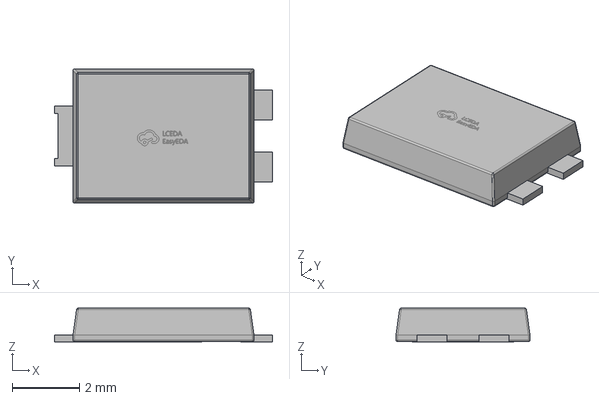
[picture p18: CAD file, 2026-11-08]
hardware/models3d/D_PowerDI-5.step
6.50 x 4.00 x 1.01 mm
