kingoflolz/lutcam/hardware/models3d/GT-USB-7055BB.step

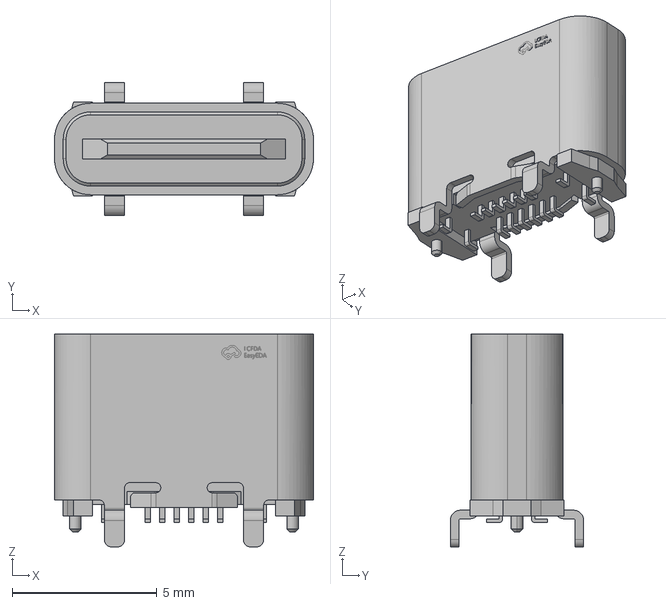
[picture p19: CAD file, 2026-11-08]
hardware/models3d/GT-USB-7055BB.step
8.94 x 4.60 x 7.35 mm
