kingoflolz/lutcam/hardware/models3d/G2419S.step

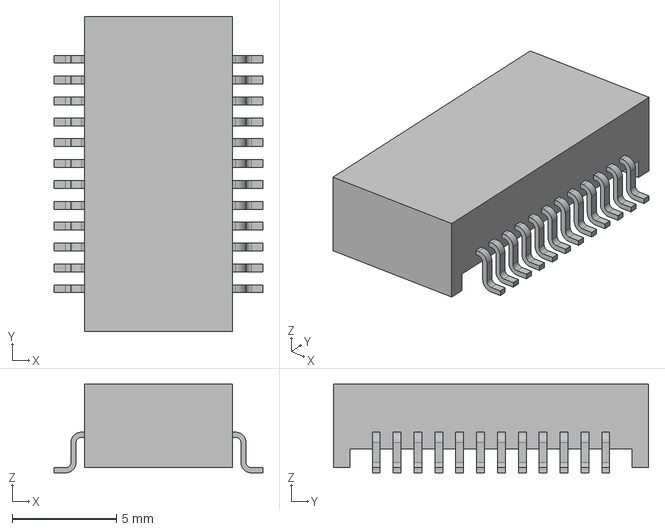
[picture p20: CAD file, 2026-11-08]
hardware/models3d/G2419S.step
10.0 x 15.1 x 4.25 mm
