kingoflolz/lutcam/hardware/models3d/R-RJ45S08P-B000.step

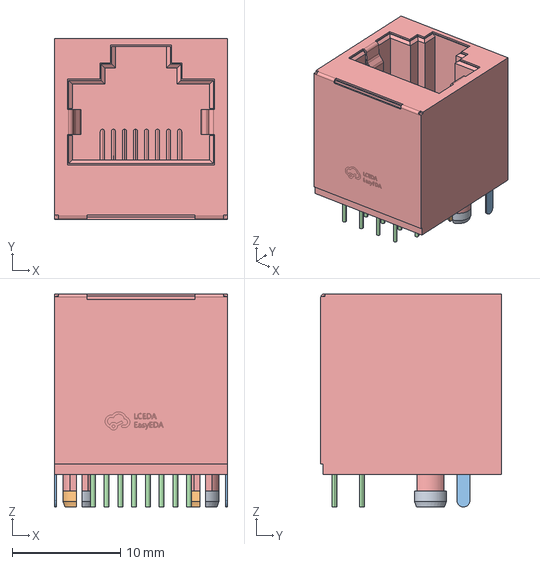
[picture p21: CAD file, 2026-11-08]
hardware/models3d/R-RJ45S08P-B000.step
16.0 x 16.7 x 19.7 mm
