kingoflolz/lutcam/hardware/models3d/OV9281_CSP64.step

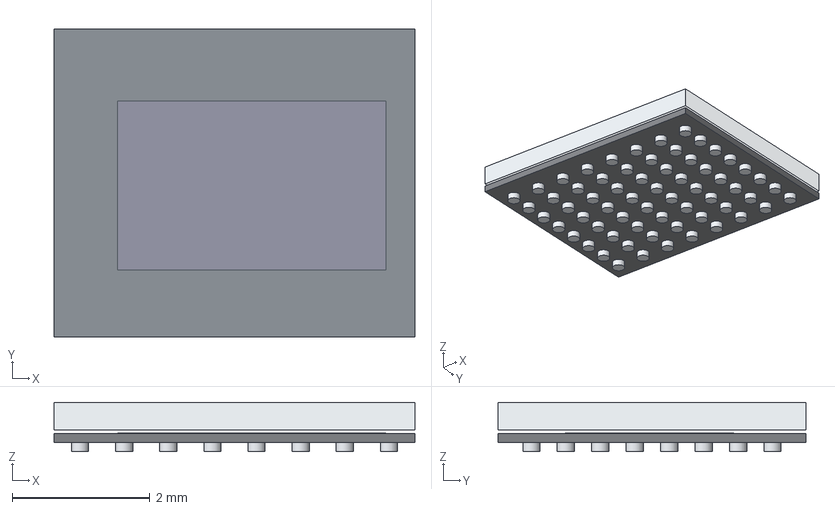
[picture p22: CAD file, 2026-11-08]
hardware/models3d/OV9281_CSP64.step
5.24 x 4.46 x 0.715 mm
sensor_wafer
active_array
cover_glass
balls_simplified
