kingoflolz/lutcam/hardware/models3d/TI60F225C4.step

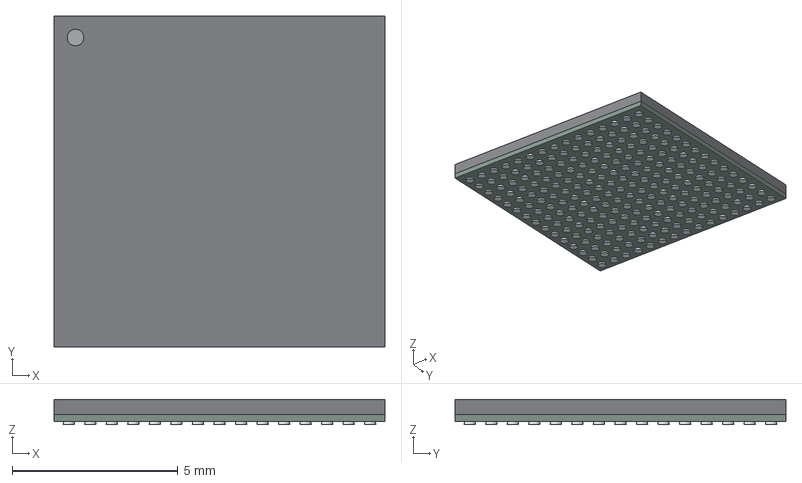
[picture p23: CAD file, 2026-11-08]
hardware/models3d/TI60F225C4.step
10.0 x 10.0 x 0.757 mm
substrate
mold
balls
pin1
