kingoflolz/lutcam/hardware/models3d/Si3404_QFN20.step

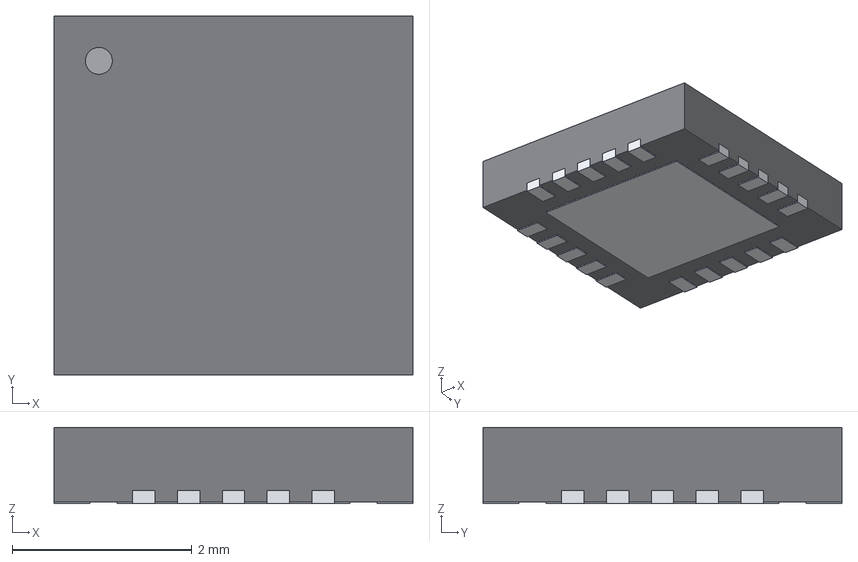
[picture p24: CAD file, 2026-11-08]
hardware/models3d/Si3404_QFN20.step
4.00 x 4.00 x 0.852 mm
mold
thermal_pad
lead_0_0
lead_0_1
lead_0_2
lead_0_3
lead_0_4
lead_1_0
lead_1_1
lead_1_2
lead_1_3
lead_1_4
lead_2_0
lead_2_1
lead_2_2
lead_2_3
lead_2_4
lead_3_0
lead_3_1
lead_3_2
lead_3_3
lead_3_4
pin1
