kingoflolz/lutcam/hardware/lutcam-hardware.kicad_pcb

## KiCad design hardware/lutcam-hardware.kicad_pcb (2026-11-08)

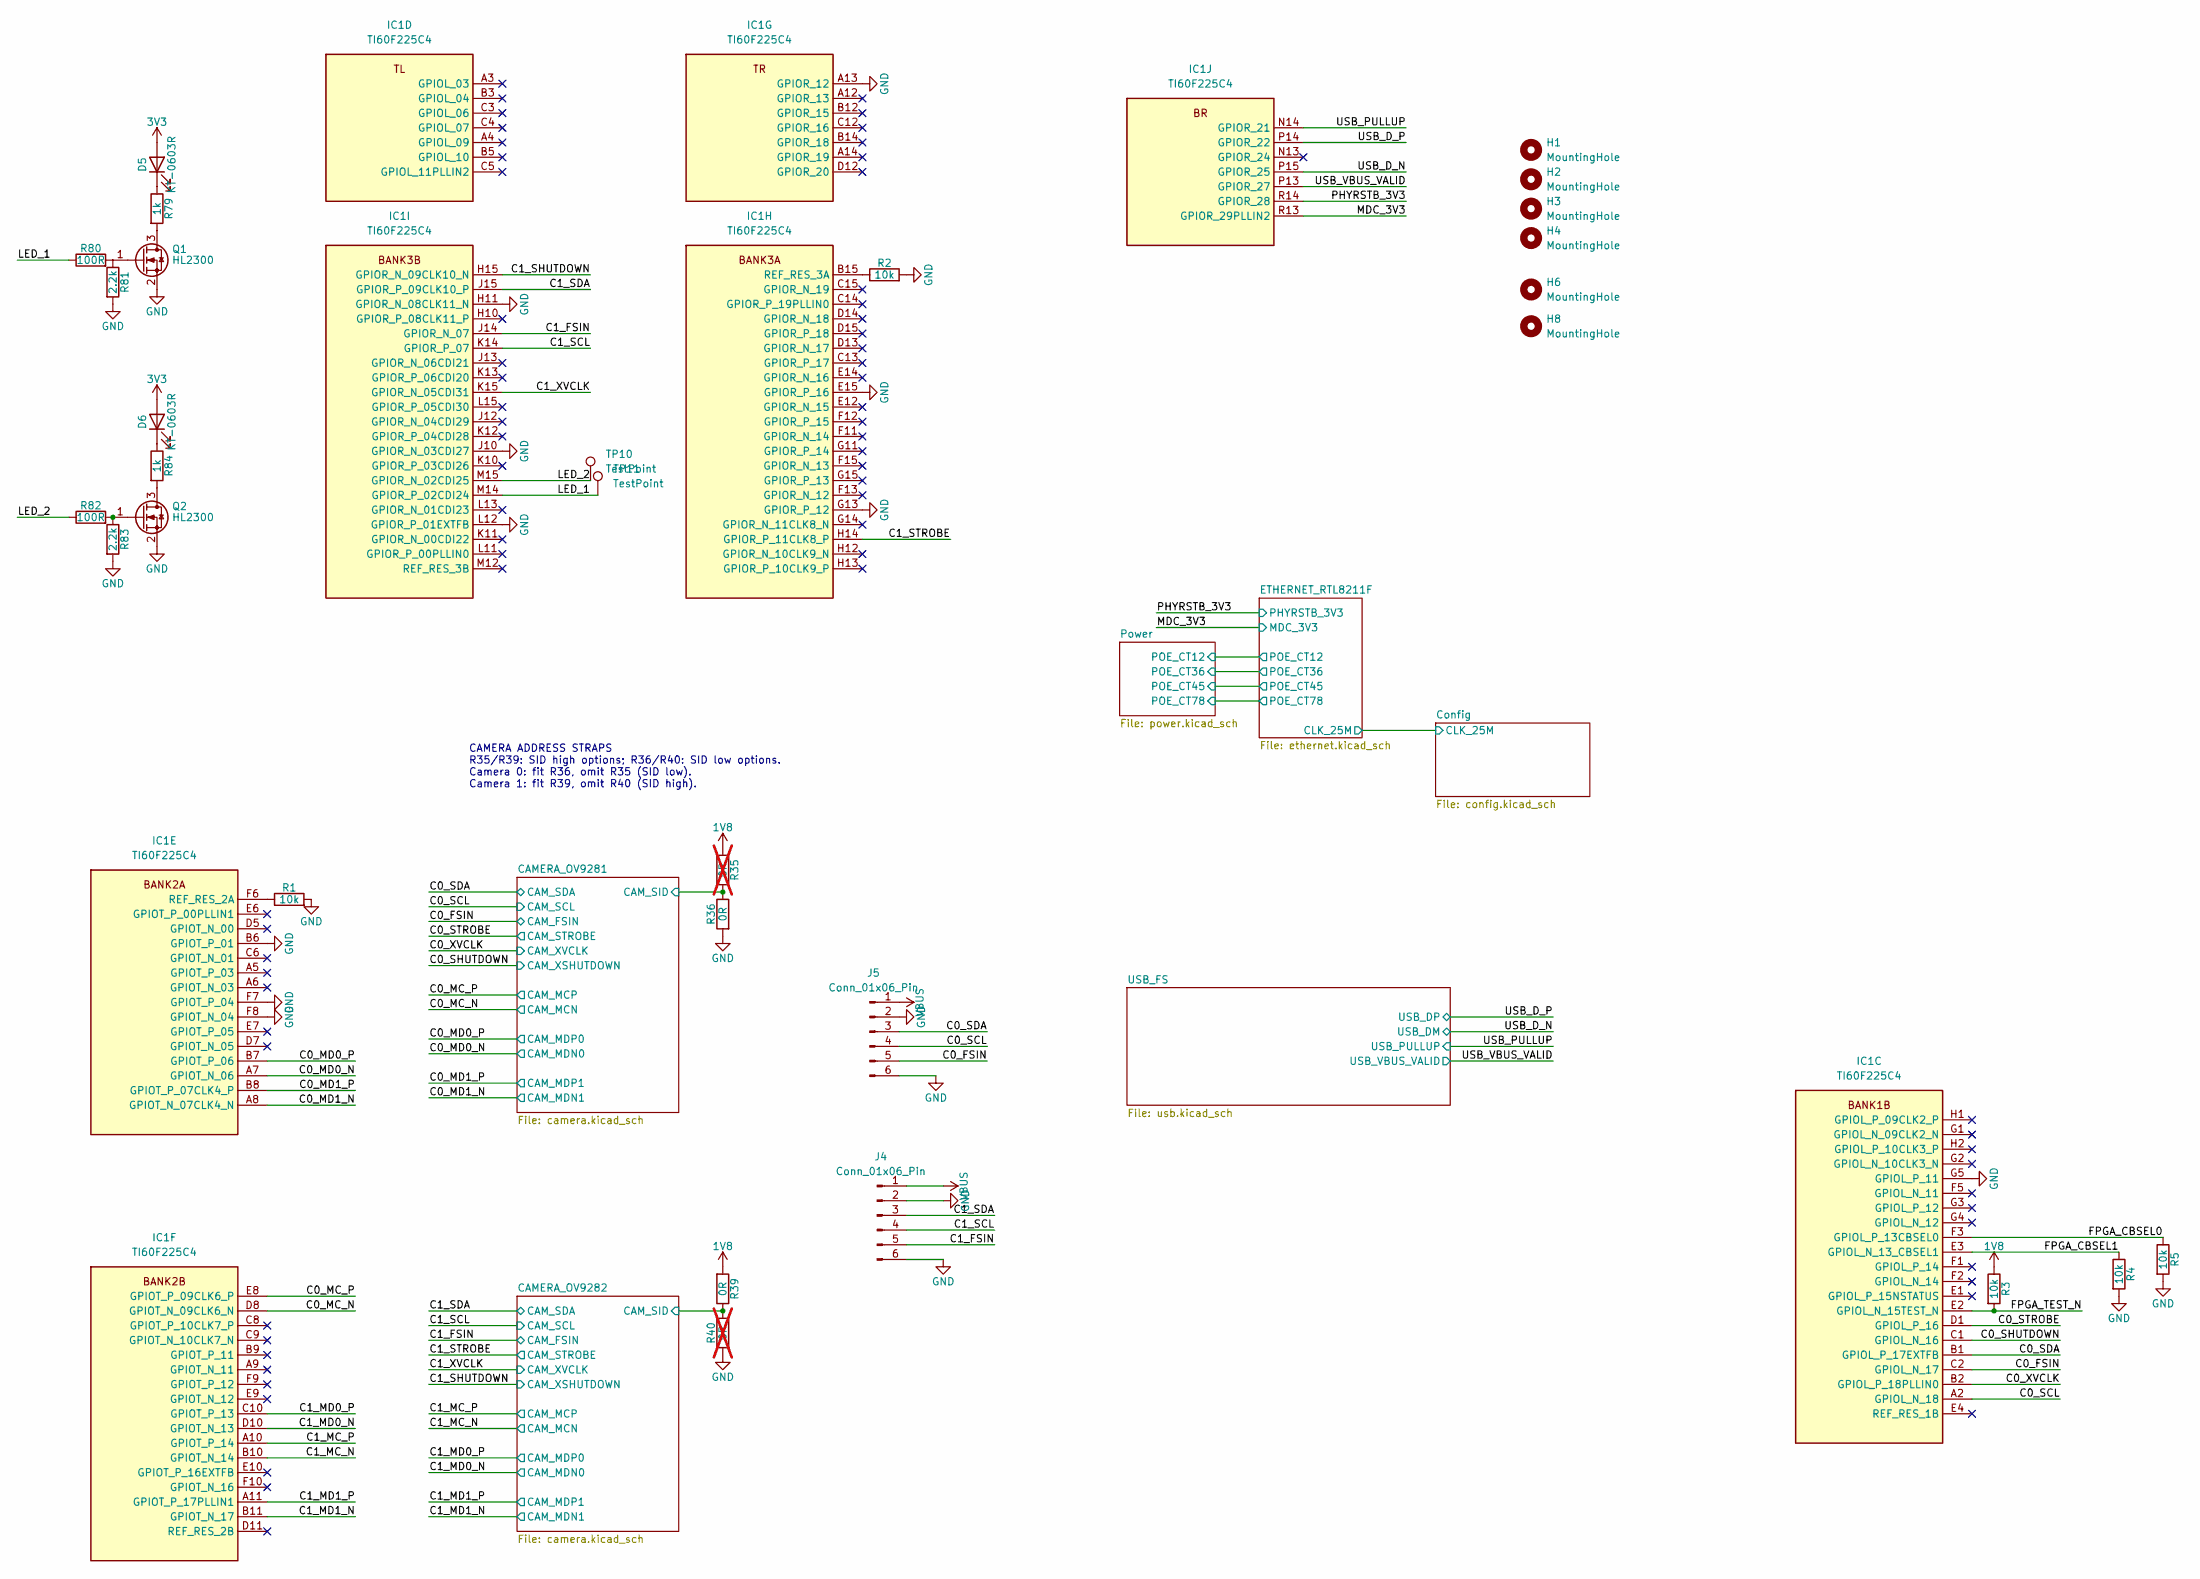
[picture p25: schematic lutcam-hardware.kicad_sch]

Parts:
D5, D6: KT-0603R; LED_0603_1608Metric; MPN KT-0603R; JLCPCB Library Basic
H1, H2, H3, H4, H6: MountingHole; MountingHole_2.2mm_M2_Pad_Via
H8: MountingHole; ToolingHole_1.152mm
IC1: TI60F225C4; BGA225C65P15X15_1000X1000X100; Manufacturer_Part_Number TI60F225C4
J4, J5: Conn_01x06_Pin; PinHeader_1x06_P2.54mm_Vertical
Q1, Q2: HL2300; SOT-23; MPN HL2300; JLCPCB Library Promotional Extended
R1, R2, R3, R4, R5: 10k; R_0402_1005Metric; MPN 0402WGF1002TCE; JLCPCB Library Basic
R35, R40: 0R; R_0402_1005Metric; MPN 0402WGF0000TCE; JLCPCB Library Basic; not fitted
R36, R39: 0R; R_0402_1005Metric; MPN 0402WGF0000TCE; JLCPCB Library Basic
R79, R84: 1k; R_0402_1005Metric; MPN 0402WGF1001TCE; JLCPCB Library Basic
R80, R82: 100R; R_0402_1005Metric; MPN 0402WGF1000TCE; JLCPCB Library Basic
R81, R83: 2.2k; R_0402_1005Metric; MPN 0402WGF2201TCE; JLCPCB Library Basic
TP10, TP11: TestPoint; TestPoint_Pad_D2.0mm

Connections:
1V8: R3.1, R35.2, R39.2; also elsewhere on the board
3V3: D5.2 (A), D6.2 (A); also elsewhere on the board
/C0_FSIN: IC1.C2 (GPIOL_N_17), J5.5; also elsewhere on the board
/C0_MC_N: IC1.D8 (GPIOT_N_09CLK6_N); also elsewhere on the board
/C0_MC_P: IC1.E8 (GPIOT_P_09CLK6_P); also elsewhere on the board
/C0_MD0_N: IC1.A7 (GPIOT_N_06); also elsewhere on the board
/C0_MD0_P: IC1.B7 (GPIOT_P_06); also elsewhere on the board
/C0_MD1_N: IC1.A8 (GPIOT_N_07CLK4_N); also elsewhere on the board
/C0_MD1_P: IC1.B8 (GPIOT_P_07CLK4_P); also elsewhere on the board
/C0_SCL: IC1.A2 (GPIOL_N_18), J5.4; also elsewhere on the board
/C0_SDA: IC1.B1 (GPIOL_P_17EXTFB), J5.3; also elsewhere on the board
/C0_SHUTDOWN: IC1.C1 (GPIOL_N_16); also elsewhere on the board
/C0_STROBE: IC1.D1 (GPIOL_P_16); also elsewhere on the board
/C0_XVCLK: IC1.B2 (GPIOL_P_18PLLIN0); also elsewhere on the board
/C1_FSIN: IC1.J14 (GPIOR_N_07), J4.5; also elsewhere on the board
/C1_MC_N: IC1.B10 (GPIOT_N_14); also elsewhere on the board
/C1_MC_P: IC1.A10 (GPIOT_P_14); also elsewhere on the board
/C1_MD0_N: IC1.D10 (GPIOT_N_13); also elsewhere on the board
/C1_MD0_P: IC1.C10 (GPIOT_P_13); also elsewhere on the board
/C1_MD1_N: IC1.B11 (GPIOT_N_17); also elsewhere on the board
/C1_MD1_P: IC1.A11 (GPIOT_P_17PLLIN1); also elsewhere on the board
/C1_SCL: IC1.K14 (GPIOR_P_07), J4.4; also elsewhere on the board
/C1_SDA: IC1.J15 (GPIOR_P_09CLK10_P), J4.3; also elsewhere on the board
/C1_SHUTDOWN: IC1.H15 (GPIOR_N_09CLK10_N); also elsewhere on the board
/C1_STROBE: IC1.H14 (GPIOR_P_11CLK8_P); also elsewhere on the board
/C1_XVCLK: IC1.K15 (GPIOR_N_05CDI31); also elsewhere on the board
/CAMERA_OV9281/CAM_SID: R35.1, R36.1; also elsewhere on the board
/CAMERA_OV9282/CAM_SID: R39.1, R40.1; also elsewhere on the board
/FPGA_CBSEL0: IC1.F3 (GPIOL_P_13CBSEL0), R5.1
/FPGA_CBSEL1: IC1.E3 (GPIOL_N_13_CBSEL1), R4.1
/FPGA_TEST_N: IC1.E2 (GPIOL_N_15TEST_N), R3.2
/LED_1: IC1.M14 (GPIOR_P_02CDI24), R80.1, TP11.1 (1_1)
/LED_2: IC1.M15 (GPIOR_N_02CDI25), R82.1, TP10.1 (1_1)
/MDC_3V3: IC1.R13 (GPIOR_29PLLIN2); also elsewhere on the board
/PHYRSTB_3V3: IC1.R14 (GPIOR_28); also elsewhere on the board
/USB_D_N: IC1.P15 (GPIOR_25); also elsewhere on the board
/USB_D_P: IC1.P14 (GPIOR_22); also elsewhere on the board
/USB_PULLUP: IC1.N14 (GPIOR_21); also elsewhere on the board
/USB_VBUS_VALID: IC1.P13 (GPIOR_27); also elsewhere on the board
GND: IC1.A13 (GPIOR_12), IC1.B6 (GPIOT_P_01), IC1.E15 (GPIOR_P_16), IC1.F7 (GPIOT_P_04), IC1.F8 (GPIOT_N_04), IC1.G5 (GPIOL_P_11), IC1.G13 (GPIOR_P_12), IC1.H11 (GPIOR_N_08CLK11_N), IC1.J10 (GPIOR_N_03CDI27), IC1.L12 (GPIOR_P_01EXTFB), J4.2, J4.6, J5.2, J5.6, Q1.2 (S), Q2.2 (S), R1.2, R2.2, R4.2, R5.2, R36.2, R40.2, R81.2, R83.2; also elsewhere on the board
unnamed: D5.1 (K), R79.1
unnamed: D6.1 (K), R84.1
unnamed: IC1.F6 (REF_RES_2A), R1.1
unnamed: IC1.B15 (REF_RES_3A), R2.1
unnamed: Q1.3 (D), R79.2
unnamed: Q1.1 (G), R80.2, R81.1
unnamed: Q2.3 (D), R84.2
unnamed: Q2.1 (G), R82.2, R83.1
VBUS: J4.1, J5.1; also elsewhere on the board

Notes on the sheet:
CAMERA ADDRESS STRAPS R35/R39: SID high options; R36/R40: SID low options. Camera 0: fit R36, omit R35 (SID low). Camera 1: fit R39, omit R40 (SID high).

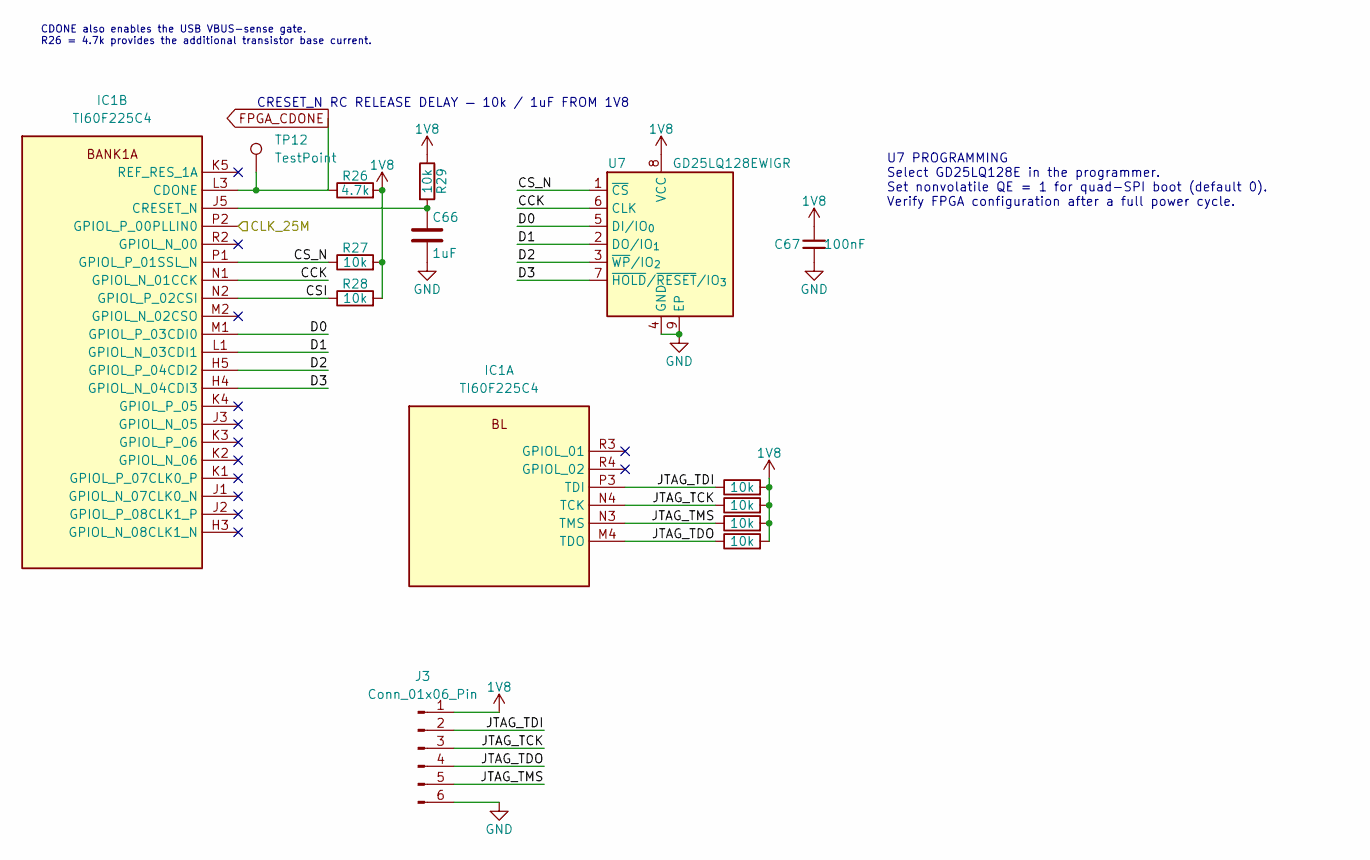
[picture p26: schematic config.kicad_sch]

Parts:
C66: 1uF; C_0402_1005Metric; MPN CL05A105KA5NQNC; JLCPCB Library Basic
C67: 100nF; C_0402_1005Metric; MPN CL05B104KO5NNNC; JLCPCB Library Basic
IC1: TI60F225C4; BGA225C65P15X15_1000X1000X100; Manufacturer_Part_Number TI60F225C4
J3: Conn_01x06_Pin; PinHeader_1x06_P2.54mm_Vertical
R26: 4.7k; R_0402_1005Metric; MPN 0402WGF4701TCE; JLCPCB Library Basic
R27, R28, R29, R30, R31, R32, R33: 10k; R_0402_1005Metric; MPN 0402WGF1002TCE; JLCPCB Library Basic
TP12: TestPoint; TestPoint_Pad_D2.0mm
U7: GD25LQ128EWIGR; WSON-8-1EP_6x5mm_P1.27mm_EP3.4x4.3mm; MPN GD25LQ128EWIGR; LCSC C2928889

Connections:
1V8: C67.2, J3.1, R26.2, R27.2, R28.2, R29.1, R30.2, R31.2, R32.2, R33.2, U7.8 (VCC); also elsewhere on the board
/Config/CCK: IC1.N1 (GPIOL_N_01CCK), U7.6 (CLK)
/Config/CLK_25M: IC1.P2 (GPIOL_P_00PLLIN0); also elsewhere on the board
/Config/CSI: IC1.N2 (GPIOL_P_02CSI), R28.1
/Config/CS_N: IC1.P1 (GPIOL_P_01SSL_N), R27.1, U7.1 (~CS)
/Config/D0: IC1.M1 (GPIOL_P_03CDI0), U7.5 (DI/IO_{0})
/Config/D1: IC1.L1 (GPIOL_N_03CDI1), U7.2 (DO/IO_{1})
/Config/D2: IC1.H5 (GPIOL_P_04CDI2), U7.3 (~WP/IO_{2})
/Config/D3: IC1.H4 (GPIOL_N_04CDI3), U7.7 (~HOLD/~RESET/IO_{3})
/Config/JTAG_TCK: IC1.N4 (TCK), J3.3, R31.1
/Config/JTAG_TDI: IC1.P3 (TDI), J3.2, R30.1
/Config/JTAG_TDO: IC1.M4 (TDO), J3.4, R33.1
/Config/JTAG_TMS: IC1.N3 (TMS), J3.5, R32.1
FPGA_CDONE: IC1.L3 (CDONE), R26.1, TP12.1 (1_1); also elsewhere on the board
GND: C66.2, C67.1, J3.6, U7.4 (GND), U7.9 (EP); also elsewhere on the board
unnamed: C66.1, IC1.J5 (CRESET_N), R29.2

Notes on the sheet:
CRESET_N RC RELEASE DELAY — 10k / 1uF FROM 1V8
U7 PROGRAMMING Select GD25LQ128E in the programmer. Set nonvolatile QE = 1 for quad-SPI boot (default 0). Verify FPGA configuration after a full power cycle.
CDONE also enables the USB VBUS-sense gate. R26 = 4.7k provides the additional transistor base current.

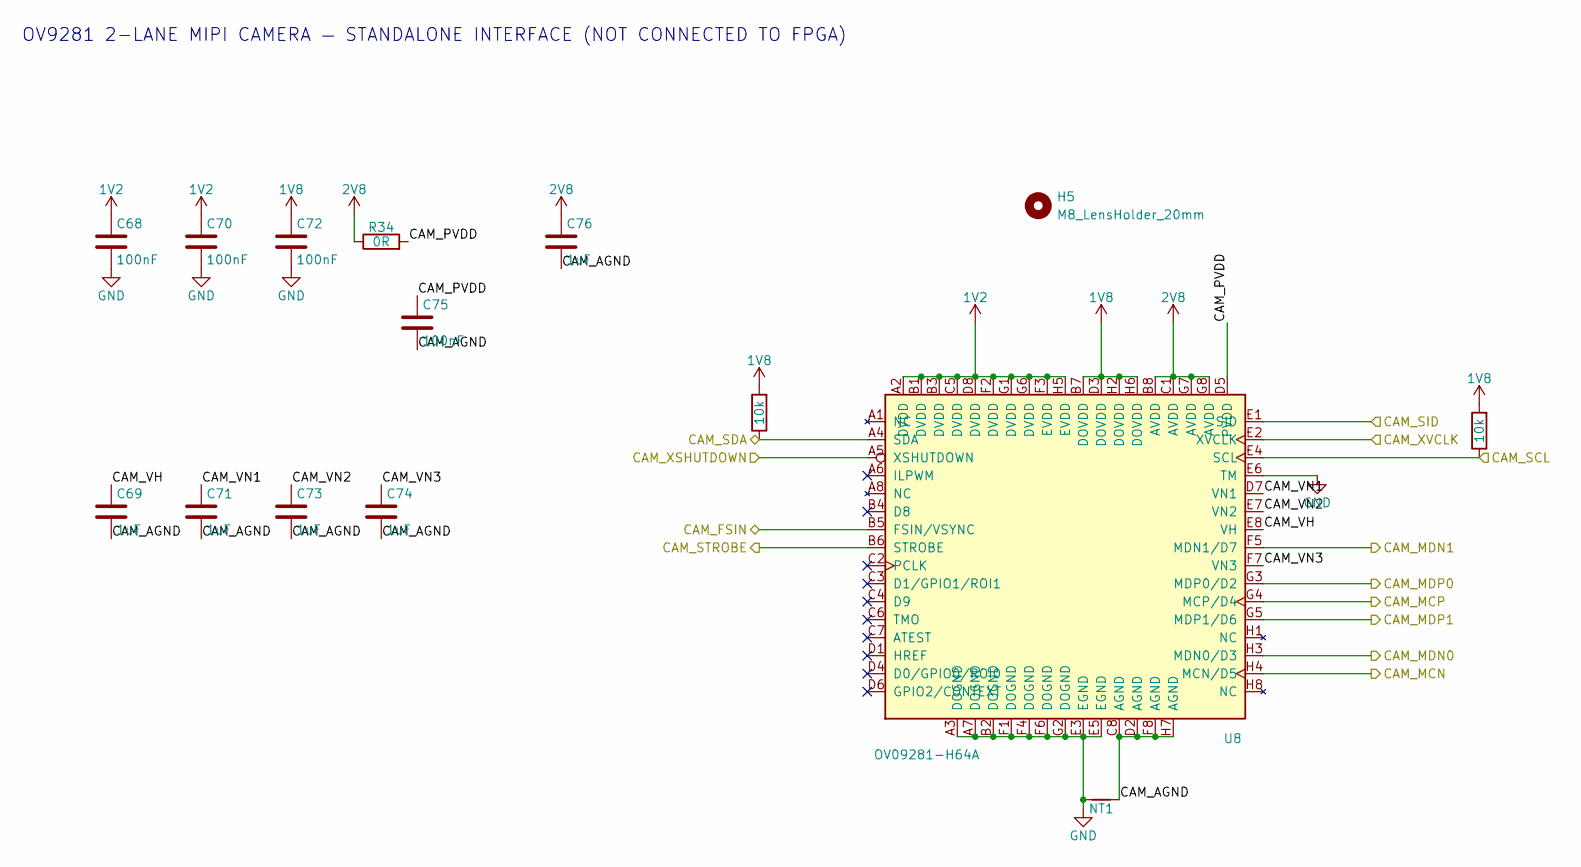
[picture p27: schematic camera.kicad_sch]

Parts:
C68, C70, C72, C75: 100nF; C_0402_1005Metric; MPN CL05B104KO5NNNC; JLCPCB Library Basic
C69, C71, C73, C74, C76: 1uF; C_0402_1005Metric; MPN CL05A105KA5NQNC; JLCPCB Library Basic
H5: M8_LensHolder_20mm; MountingHole_M8_LensHolder_P20mm_2xM2_Pad_Via
NT1: CAM_AGND-GND; NetTie-2_SMD_Pad0.5mm
R34: 0R; R_0402_1005Metric; MPN 0402WGF0000TCE; JLCPCB Library Basic
R212, R213: 10k; R_0402_1005Metric; MPN 0402WGF1002TCE; JLCPCB Library Basic
U8: OV09281-H64A; OmniVision_CSP-64_5.237x4.463mm_Layout8x8_P0.64x0.50mm; MPN OV09281-H64A

Connections:
1V2: C68.1, C70.1, U8.A2 (DVDD), U8.B1 (DVDD), U8.B3 (DVDD), U8.C5 (DVDD), U8.D8 (DVDD), U8.F2 (DVDD), U8.F3 (EVDD), U8.G1 (DVDD), U8.G6 (DVDD), U8.H5 (EVDD); also elsewhere on the board
1V8: C72.1, R212.2, R213.2, U8.B7 (DOVDD), U8.D3 (DOVDD), U8.H2 (DOVDD), U8.H6 (DOVDD); also elsewhere on the board
2V8: C76.1, R34.1, U8.B8 (AVDD), U8.C1 (AVDD), U8.G7 (AVDD), U8.G8 (AVDD); also elsewhere on the board
/C0_FSIN: U8.B5 (FSIN/VSYNC); also elsewhere on the board
/C0_MC_N: U8.H4 (MCN/D5); also elsewhere on the board
/C0_MC_P: U8.G4 (MCP/D4); also elsewhere on the board
/C0_MD0_N: U8.H3 (MDN0/D3); also elsewhere on the board
/C0_MD0_P: U8.G3 (MDP0/D2); also elsewhere on the board
/C0_MD1_N: U8.F5 (MDN1/D7); also elsewhere on the board
/C0_MD1_P: U8.G5 (MDP1/D6); also elsewhere on the board
/C0_SCL: R213.1, U8.E4 (SCL); also elsewhere on the board
/C0_SDA: R212.1, U8.A4 (SDA); also elsewhere on the board
/C0_SHUTDOWN: U8.A5 (XSHUTDOWN); also elsewhere on the board
/C0_STROBE: U8.B6 (STROBE); also elsewhere on the board
/C0_XVCLK: U8.E2 (XVCLK); also elsewhere on the board
/CAMERA_OV9281/CAM_AGND: C69.2, C71.2, C73.2, C74.2, C75.2, C76.2, NT1.1, U8.C8 (AGND), U8.D2 (AGND), U8.F8 (AGND), U8.H7 (AGND)
/CAMERA_OV9281/CAM_PVDD: C75.1, R34.2, U8.D5 (PVDD)
/CAMERA_OV9281/CAM_SID: U8.E1 (SID); also elsewhere on the board
/CAMERA_OV9281/CAM_VH: C69.1, U8.E8 (VH)
/CAMERA_OV9281/CAM_VN1: C71.1, U8.D7 (VN1)
/CAMERA_OV9281/CAM_VN2: C73.1, U8.E7 (VN2)
/CAMERA_OV9281/CAM_VN3: C74.1, U8.F7 (VN3)
GND: C68.2, C70.2, C72.2, NT1.2, U8.A3 (DOGND), U8.A7 (DOGND), U8.B2 (DOGND), U8.E3 (EGND), U8.E5 (EGND), U8.E6 (TM), U8.F1 (DOGND), U8.F4 (DOGND), U8.F6 (DOGND), U8.G2 (DOGND); also elsewhere on the board

Parts of its further copies:
C95, C97, C99, C102: 100nF; C_0402_1005Metric; MPN CL05B104KO5NNNC; JLCPCB Library Basic
C96, C98, C100, C101, C103: 1uF; C_0402_1005Metric; MPN CL05A105KA5NQNC; JLCPCB Library Basic
H7: M8_LensHolder_20mm; MountingHole_M8_LensHolder_P20mm_2xM2_Pad_Via
NT2: CAM_AGND-GND; NetTie-2_SMD_Pad0.5mm
R78: 0R; R_0402_1005Metric; MPN 0402WGF0000TCE; JLCPCB Library Basic
R214, R215: 10k; R_0402_1005Metric; MPN 0402WGF1002TCE; JLCPCB Library Basic
U11: OV09281-H64A; OmniVision_CSP-64_5.237x4.463mm_Layout8x8_P0.64x0.50mm; MPN OV09281-H64A

Connections of its further copies:
1V2: C95.1, C97.1, U11.A2 (DVDD), U11.B1 (DVDD), U11.B3 (DVDD), U11.C5 (DVDD), U11.D8 (DVDD), U11.F2 (DVDD), U11.F3 (EVDD), U11.G1 (DVDD), U11.G6 (DVDD), U11.H5 (EVDD); also elsewhere on the board
1V8: C99.1, R214.2, R215.2, U11.B7 (DOVDD), U11.D3 (DOVDD), U11.H2 (DOVDD), U11.H6 (DOVDD); also elsewhere on the board
2V8: C103.1, R78.1, U11.B8 (AVDD), U11.C1 (AVDD), U11.G7 (AVDD), U11.G8 (AVDD); also elsewhere on the board
/C1_FSIN: U11.B5 (FSIN/VSYNC); also elsewhere on the board
/C1_MC_N: U11.H4 (MCN/D5); also elsewhere on the board
/C1_MC_P: U11.G4 (MCP/D4); also elsewhere on the board
/C1_MD0_N: U11.H3 (MDN0/D3); also elsewhere on the board
/C1_MD0_P: U11.G3 (MDP0/D2); also elsewhere on the board
/C1_MD1_N: U11.F5 (MDN1/D7); also elsewhere on the board
/C1_MD1_P: U11.G5 (MDP1/D6); also elsewhere on the board
/C1_SCL: R215.1, U11.E4 (SCL); also elsewhere on the board
/C1_SDA: R214.1, U11.A4 (SDA); also elsewhere on the board
/C1_SHUTDOWN: U11.A5 (XSHUTDOWN); also elsewhere on the board
/C1_STROBE: U11.B6 (STROBE); also elsewhere on the board
/C1_XVCLK: U11.E2 (XVCLK); also elsewhere on the board
/CAMERA_OV9282/CAM_AGND: C96.2, C98.2, C100.2, C101.2, C102.2, C103.2, NT2.1, U11.C8 (AGND), U11.D2 (AGND), U11.F8 (AGND), U11.H7 (AGND)
/CAMERA_OV9282/CAM_PVDD: C102.1, R78.2, U11.D5 (PVDD)
/CAMERA_OV9282/CAM_SID: U11.E1 (SID); also elsewhere on the board
/CAMERA_OV9282/CAM_VH: C96.1, U11.E8 (VH)
/CAMERA_OV9282/CAM_VN1: C98.1, U11.D7 (VN1)
/CAMERA_OV9282/CAM_VN2: C100.1, U11.E7 (VN2)
/CAMERA_OV9282/CAM_VN3: C101.1, U11.F7 (VN3)
GND: C95.2, C97.2, C99.2, NT2.2, U11.A3 (DOGND), U11.A7 (DOGND), U11.B2 (DOGND), U11.E3 (EGND), U11.E5 (EGND), U11.E6 (TM), U11.F1 (DOGND), U11.F4 (DOGND), U11.F6 (DOGND), U11.G2 (DOGND); also elsewhere on the board

Notes on the sheet:
OV9281 2-LANE MIPI CAMERA — STANDALONE INTERFACE (NOT CONNECTED TO FPGA)

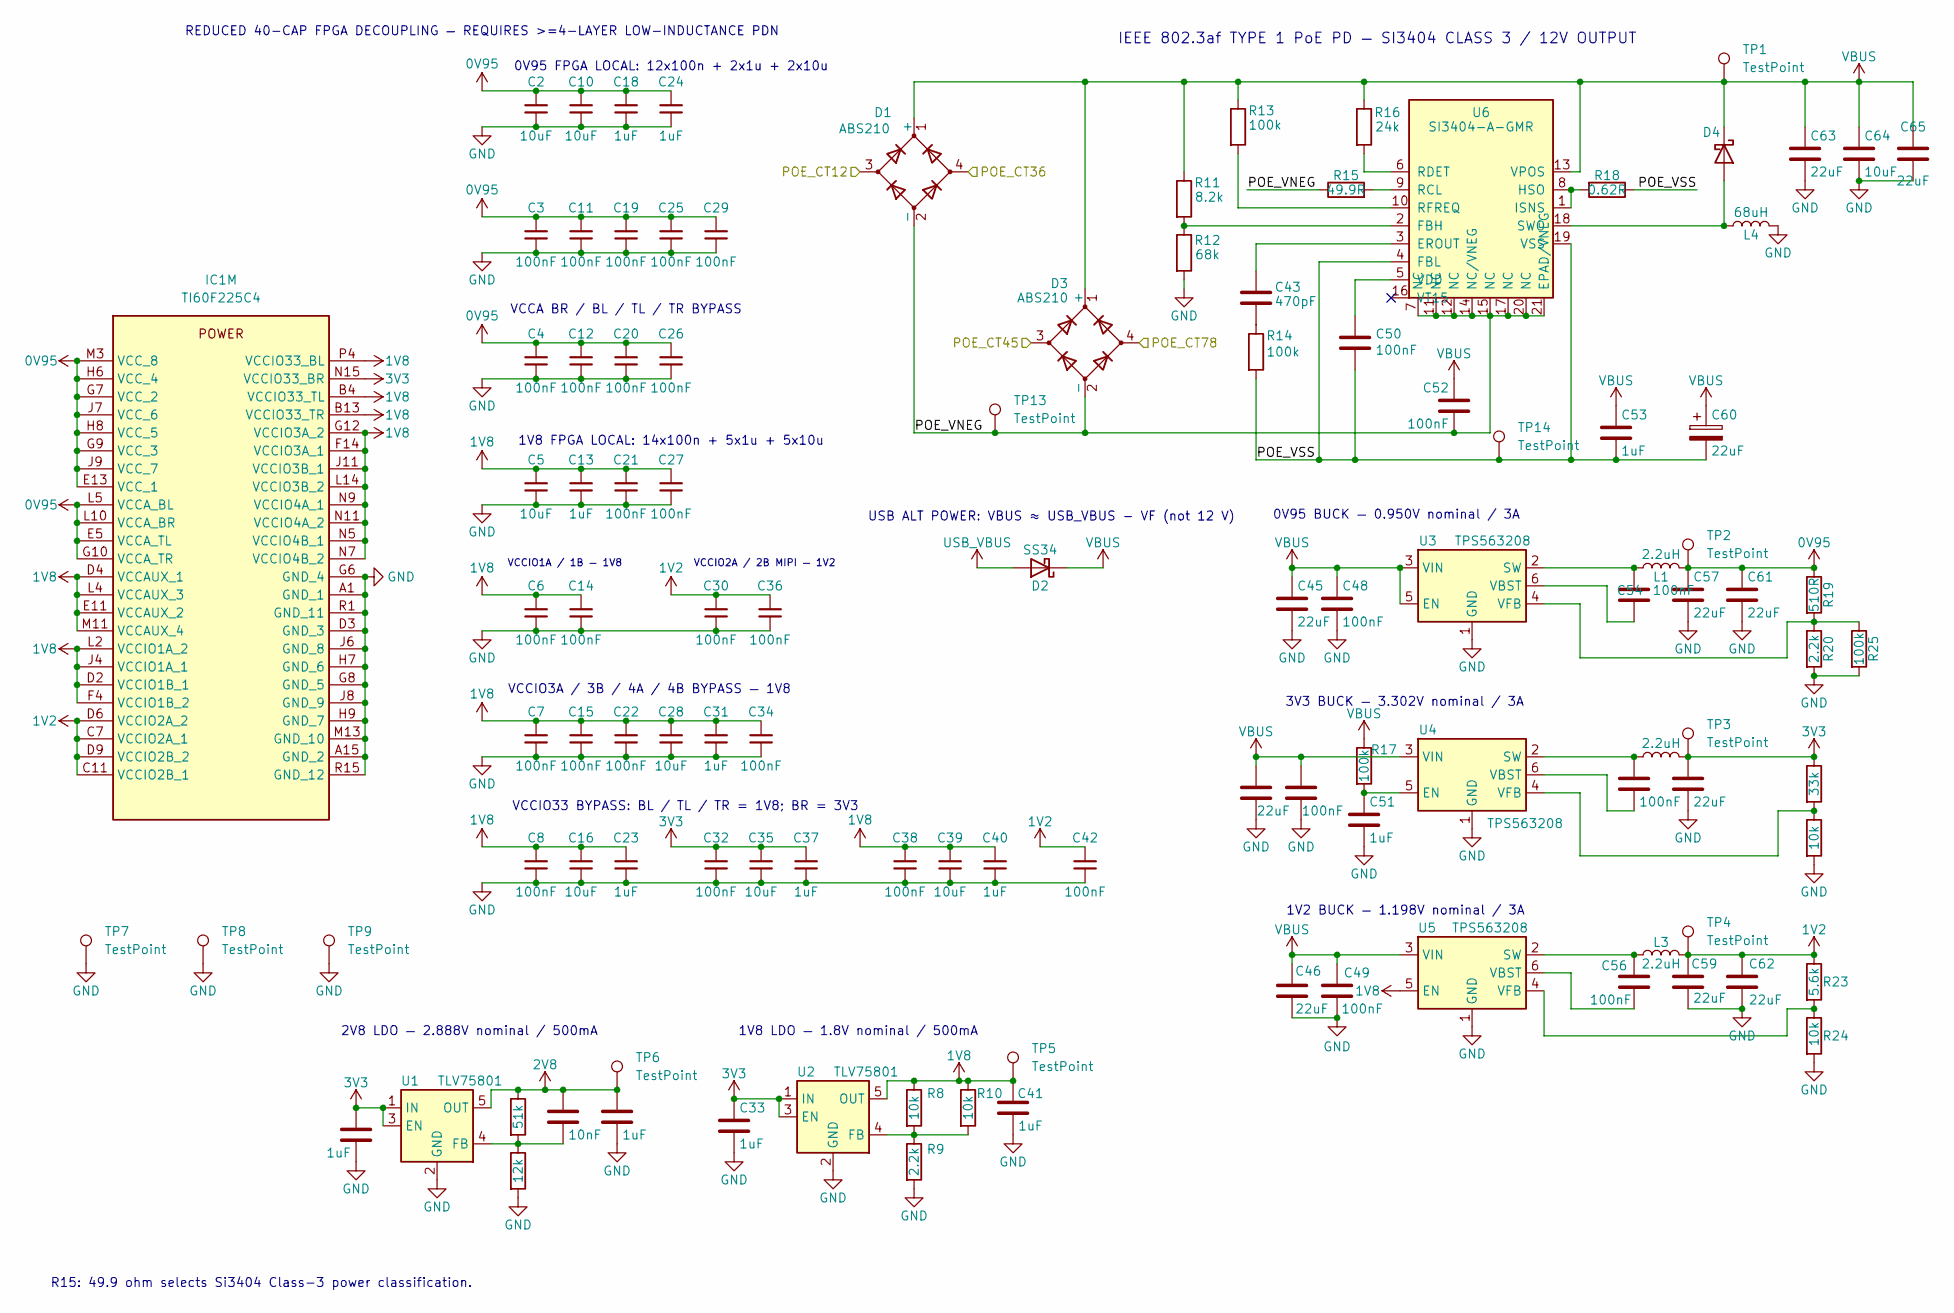
[picture p28: schematic power.kicad_sch]

Parts:
C1, C17, C33, C41, C51: 1uF; C_0402_1005Metric; MPN CL05A105KA5NQNC; LCSC C52923
C2, C5, C10, C16, C28, C35, C39: 10uF; C_0603_1608Metric; MPN CL10A106KP8NNNC; JLCPCB Library Basic
C3, C4, C6, C7, C11, C12, C14, C15, C19, C20, C21, C22, C25, C26, C27, C29, C30, C32, C34, C36, C38, C42: 100nF; C_0402_1005Metric; MPN CL05B104KO5NNNC; JLCPCB Library Basic
C8, C54, C55, C56: 100nF; C_0402_1005Metric; MPN CL05B104KO5NNNC; LCSC C1525
C9: 10nF; C_0402_1005Metric; MPN CL05B103KB5NNNC; LCSC C15195
C13, C18, C23, C24, C31, C37, C40: 1uF; C_0402_1005Metric; MPN CL05A105KA5NQNC; JLCPCB Library Basic
C43: 470pF; C_0402_1005Metric; MPN 0402B471K500NT; LCSC C1537
C44, C45, C46, C63, C65: 22uF; C_1206_3216Metric; MPN CL31A226KAHNNNE; LCSC C12891
C47, C48, C49, C50: 100nF; C_0402_1005Metric; MPN CL05B104KB54PNC; LCSC C307331
C52: 100nF; C_0805_2012Metric; MPN CL21B104KCFNNNE; LCSC C28233
C53: 1uF; C_1210_3225Metric; MPN CL32B105KCJNNNE; LCSC C444847
C57, C59, C61, C62: 22uF; C_0603_1608Metric; MPN CL10A226MQ8NRNC; LCSC C59461
C58: 22uF; C_0805_2012Metric; MPN CL21A226MAQNNNE; LCSC C45783
C60: 22uF; CP_Elec_6.3x9.9; MPN VKMC1002A220MV; LCSC C487431
C64: 10uF; C_0805_2012Metric; MPN CL21A106KAYNNNE; LCSC C15850
D1, D3: ABS210; ABS_4P_L5.0-W4.4_P4.10x5.81mm; MPN ABS210; LCSC C42406052
D2: SS34; D_SMA; MPN SS34; LCSC C8678
D4: PDS3100-13; D_PowerDI-5; MPN PDS3100-13; LCSC C154881
IC1: TI60F225C4; BGA225C65P15X15_1000X1000X100; Manufacturer_Part_Number TI60F225C4
L1, L2, L3: 2.2uH; L_Changjiang_FTC252012S; MPN FTC252012S2R2MBCA; LCSC C5832372
L4: 68uH; L_PROD_PSPMAA0605H_7.1x6.6mm; MPN PSPMAA0605H-680M-ANP; LCSC C49308193
R6: 51k; R_0402_1005Metric; MPN 0402WGF5102TCE; LCSC C25794
R7: 12k; R_0402_1005Metric; MPN 0402WGF1202TCE; LCSC C25752
R8, R22, R24: 10k; R_0402_1005Metric; MPN 0402WGF1002TCE; LCSC C25744
R9, R20: 2.2k; R_0402_1005Metric; MPN 0402WGF2201TCE; LCSC C25879
R10: 10k; R_0402_1005Metric; MPN 0402WGF1002TCE; JLCPCB Library Basic
R11: 8.2k; R_0402_1005Metric; MPN 0402WGF8201TCE; LCSC C25924
R12: 68k; R_0402_1005Metric; MPN 0402WGF6802TCE; LCSC C36871
R13, R14, R17: 100k; R_0402_1005Metric; MPN 0402WGF1003TCE; LCSC C25741
R15: 49.9R; R_0402_1005Metric; MPN 0402WGF499JTCE; LCSC C25120
R16: 24k; R_0402_1005Metric; MPN 0402WGF2402TCE; LCSC C25769
R18: 0.62R; R_0805_2012Metric; MPN FRL0805FR620TS; LCSC C2930222
R19: 510R; R_0402_1005Metric; MPN 0402WGF5100TCE; LCSC C25123
R21: 33k; R_0402_1005Metric; MPN 0402WGF3302TCE; LCSC C25779
R23: 5.6k; R_0402_1005Metric; MPN 0402WGF5601TCE; LCSC C25908
R25: 100k; R_0402_1005Metric; MPN 0402WGF1003TCE; JLCPCB Library Basic
TP1, TP2, TP3, TP4, TP5, TP6, TP7, TP8, TP9, TP13, TP14: TestPoint; TestPoint_Pad_D2.0mm
U1, U2: TLV75801; SOT-23-5; MPN TLV75801PDBVR; LCSC C2877852
U3, U4, U5: TPS563208; TSOT-23-6; MPN TPS563208DDCR; LCSC C468250
U6: SI3404-A-GMR; Skyworks_QFN-20-1EP_4x4mm_P0.5mm_EP2.6x2.6mm_NoVias; MPN SI3404-A-GMR; LCSC C461934

Connections:
0V95: C2.1, C3.1, C4.1, C10.1, C11.1, C12.1, C18.1, C19.1, C20.1, C24.1, C25.1, C26.1, C29.1, C57.1, C61.1, IC1.E5 (VCCA_TL), IC1.E13 (VCC_1), IC1.G7 (VCC_2), IC1.G9 (VCC_3), IC1.G10 (VCCA_TR), IC1.H6 (VCC_4), IC1.H8 (VCC_5), IC1.J7 (VCC_6), IC1.J9 (VCC_7), IC1.L5 (VCCA_BL), IC1.L10 (VCCA_BR), IC1.M3 (VCC_8), L1.2, R19.1, TP2.1 (1_1)
1V2: C30.1, C36.1, C42.1, C59.1, C62.1, IC1.C7 (VCCIO2A_1), IC1.C11 (VCCIO2B_1), IC1.D6 (VCCIO2A_2), IC1.D9 (VCCIO2B_2), L3.2, R23.1, TP4.1 (1_1); also elsewhere on the board
1V8: C5.1, C6.1, C7.1, C8.1, C13.1, C14.1, C15.1, C16.1, C21.1, C22.1, C23.1, C27.1, C28.1, C31.1, C34.1, C38.1, C39.1, C40.1, C41.1, IC1.B4 (VCCIO33_TL), IC1.B13 (VCCIO33_TR), IC1.D2 (VCCIO1B_1), IC1.D4 (VCCAUX_1), IC1.E11 (VCCAUX_2), IC1.F4 (VCCIO1B_2), IC1.F14 (VCCIO3A_1), IC1.G12 (VCCIO3A_2), IC1.J4 (VCCIO1A_1), IC1.J11 (VCCIO3B_1), IC1.L2 (VCCIO1A_2), IC1.L4 (VCCAUX_3), IC1.L14 (VCCIO3B_2), IC1.M11 (VCCAUX_4), IC1.N5 (VCCIO4B_1), IC1.N7 (VCCIO4B_2), IC1.N9 (VCCIO4A_1), IC1.N11 (VCCIO4A_2), IC1.P4 (VCCIO33_BL), R8.1, R10.1, TP5.1 (1_1), U2.5 (OUT), U5.5 (EN); also elsewhere on the board
2V8: C9.1, C17.1, R6.1, TP6.1 (1_1), U1.5 (OUT); also elsewhere on the board
3V3: C1.1, C32.1, C33.1, C35.1, C37.1, C58.1, IC1.N15 (VCCIO33_BR), L2.2, R21.1, TP3.1 (1_1), U1.1 (IN), U1.3 (EN), U2.1 (IN), U2.3 (EN); also elsewhere on the board
/ETHERNET_RTL8211F/POE_CT12: D1.3; also elsewhere on the board
/ETHERNET_RTL8211F/POE_CT36: D1.4; also elsewhere on the board
/ETHERNET_RTL8211F/POE_CT45: D3.3; also elsewhere on the board
/ETHERNET_RTL8211F/POE_CT78: D3.4; also elsewhere on the board
/Power/POE_VNEG: C52.2, D1.2 (-), D3.2 (-), R15.1, TP13.1 (1_1), U6.7 (NC), U6.11 (NC), U6.12 (NC), U6.14 (NC/VNEG), U6.15 (NC), U6.17 (NC), U6.20 (NC), U6.21 (EPAD/VNEG)
/Power/POE_VSS: C50.2, C53.2, C60.2, R14.2, R18.1, TP14.1 (1_1), U6.4 (FBL), U6.19 (VSS)
GND: C1.2, C2.2, C3.2, C4.2, C5.2, C6.2, C7.2, C8.2, C10.2, C11.2, C12.2, C13.2, C14.2, C15.2, C16.2, C17.2, C18.2, C19.2, C20.2, C21.2, C22.2, C23.2, C24.2, C25.2, C26.2, C27.2, C28.2, C29.2, C30.2, C31.2, C32.2, C33.2, C34.2, C35.2, C36.2, C37.2, C38.2, C39.2, C40.2, C41.2, C42.2, C44.2, C45.2, C46.2, C47.2, C48.2, C49.2, C51.2, C57.2, C58.2, C59.2, C61.2, C62.2, C63.2, C64.2, C65.2, IC1.A1 (GND_1), IC1.A15 (GND_2), IC1.D3 (GND_3), IC1.G6 (GND_4), IC1.G8 (GND_5), IC1.H7 (GND_6), IC1.H9 (GND_7), IC1.J6 (GND_8), IC1.J8 (GND_9), IC1.M13 (GND_10), IC1.R1 (GND_11), IC1.R15 (GND_12), L4.2, R7.2, R9.2, R12.2, R20.2, R22.2, R24.2, R25.2, TP7.1 (1_1), TP8.1 (1_1), TP9.1 (1_1), U1.2 (GND), U2.2 (GND), U3.1 (GND), U4.1 (GND), U5.1 (GND); also elsewhere on the board
unnamed: C43.2, R14.1
unnamed: D4.2 (A), L4.1, U6.18 (SWO)
unnamed: C9.2, R6.2, R7.1, U1.4 (FB)
unnamed: R8.2, R9.1, R10.2, U2.4 (FB)
unnamed: C54.1, L1.1, U3.2 (SW)
unnamed: C54.2, U3.6 (VBST)
unnamed: R19.2, R20.1, R25.1, U3.4 (VFB)
unnamed: C51.1, R17.2, U4.5 (EN)
unnamed: C55.1, L2.1, U4.2 (SW)
unnamed: C55.2, U4.6 (VBST)
unnamed: R21.2, R22.1, U4.4 (VFB)
unnamed: C56.1, L3.1, U5.2 (SW)
unnamed: C56.2, U5.6 (VBST)
unnamed: R23.2, R24.1, U5.4 (VFB)
unnamed: C43.1, U6.3 (EROUT)
unnamed: R11.2, R12.1, U6.2 (FBH)
unnamed: R18.2, U6.1 (ISNS), U6.8 (HSO)
unnamed: R15.2, U6.9 (RCL)
unnamed: R16.2, U6.6 (RDET)
unnamed: R13.2, U6.10 (RFREQ)
unnamed: C50.1, U6.5 (VDD)
USB_VBUS: D2.2 (A); also elsewhere on the board
VBUS: C44.1, C45.1, C46.1, C47.1, C48.1, C49.1, C52.1, C53.1, C60.1, C63.1, C64.1, C65.1, D1.1 (+), D2.1 (K), D3.1 (+), D4.1 (K), R11.1, R13.1, R16.1, R17.1, TP1.1 (1_1), U3.3 (VIN), U3.5 (EN), U4.3 (VIN), U5.3 (VIN), U6.13 (VPOS); also elsewhere on the board

Parts of its further copies:
C103: 1uF; C_0402_1005Metric; MPN CL05A105KA5NQNC; JLCPCB Library Basic

Connections of its further copies:
2V8: C103.1; also elsewhere on the board
/CAMERA_OV9282/CAM_AGND: C103.2; also elsewhere on the board

Notes on the sheet:
USB ALT POWER: VBUS ≈ USB_VBUS − VF (not 12 V)
3V3 BUCK — 3.302V nominal / 3A
IEEE 802.3af TYPE 1 PoE PD — SI3404 CLASS 3 / 12V OUTPUT
0V95 BUCK — 0.950V nominal / 3A
VCCIO1A / 1B — 1V8
0V95 FPGA LOCAL: 12x100n + 2x1u + 2x10u
1V8 FPGA LOCAL: 14x100n + 5x1u + 5x10u
VCCIO2A / 2B MIPI — 1V2
1V8 LDO — 1.8V nominal / 500mA
VCCA BR / BL / TL / TR BYPASS
2V8 LDO — 2.888V nominal / 500mA
1V2 BUCK — 1.198V nominal / 3A
R15: 49.9 ohm selects Si3404 Class-3 power classification.
VCCIO33 BYPASS: BL / TL / TR = 1V8; BR = 3V3
REDUCED 40-CAP FPGA DECOUPLING — REQUIRES >=4-LAYER LOW-INDUCTANCE PDN
VCCIO3A / 3B / 4A / 4B BYPASS — 1V8
