kingoflolz/lutcam/hardware/lutcam-hardware.kicad_pcb

## KiCad design hardware/lutcam-hardware.kicad_pcb (continued)

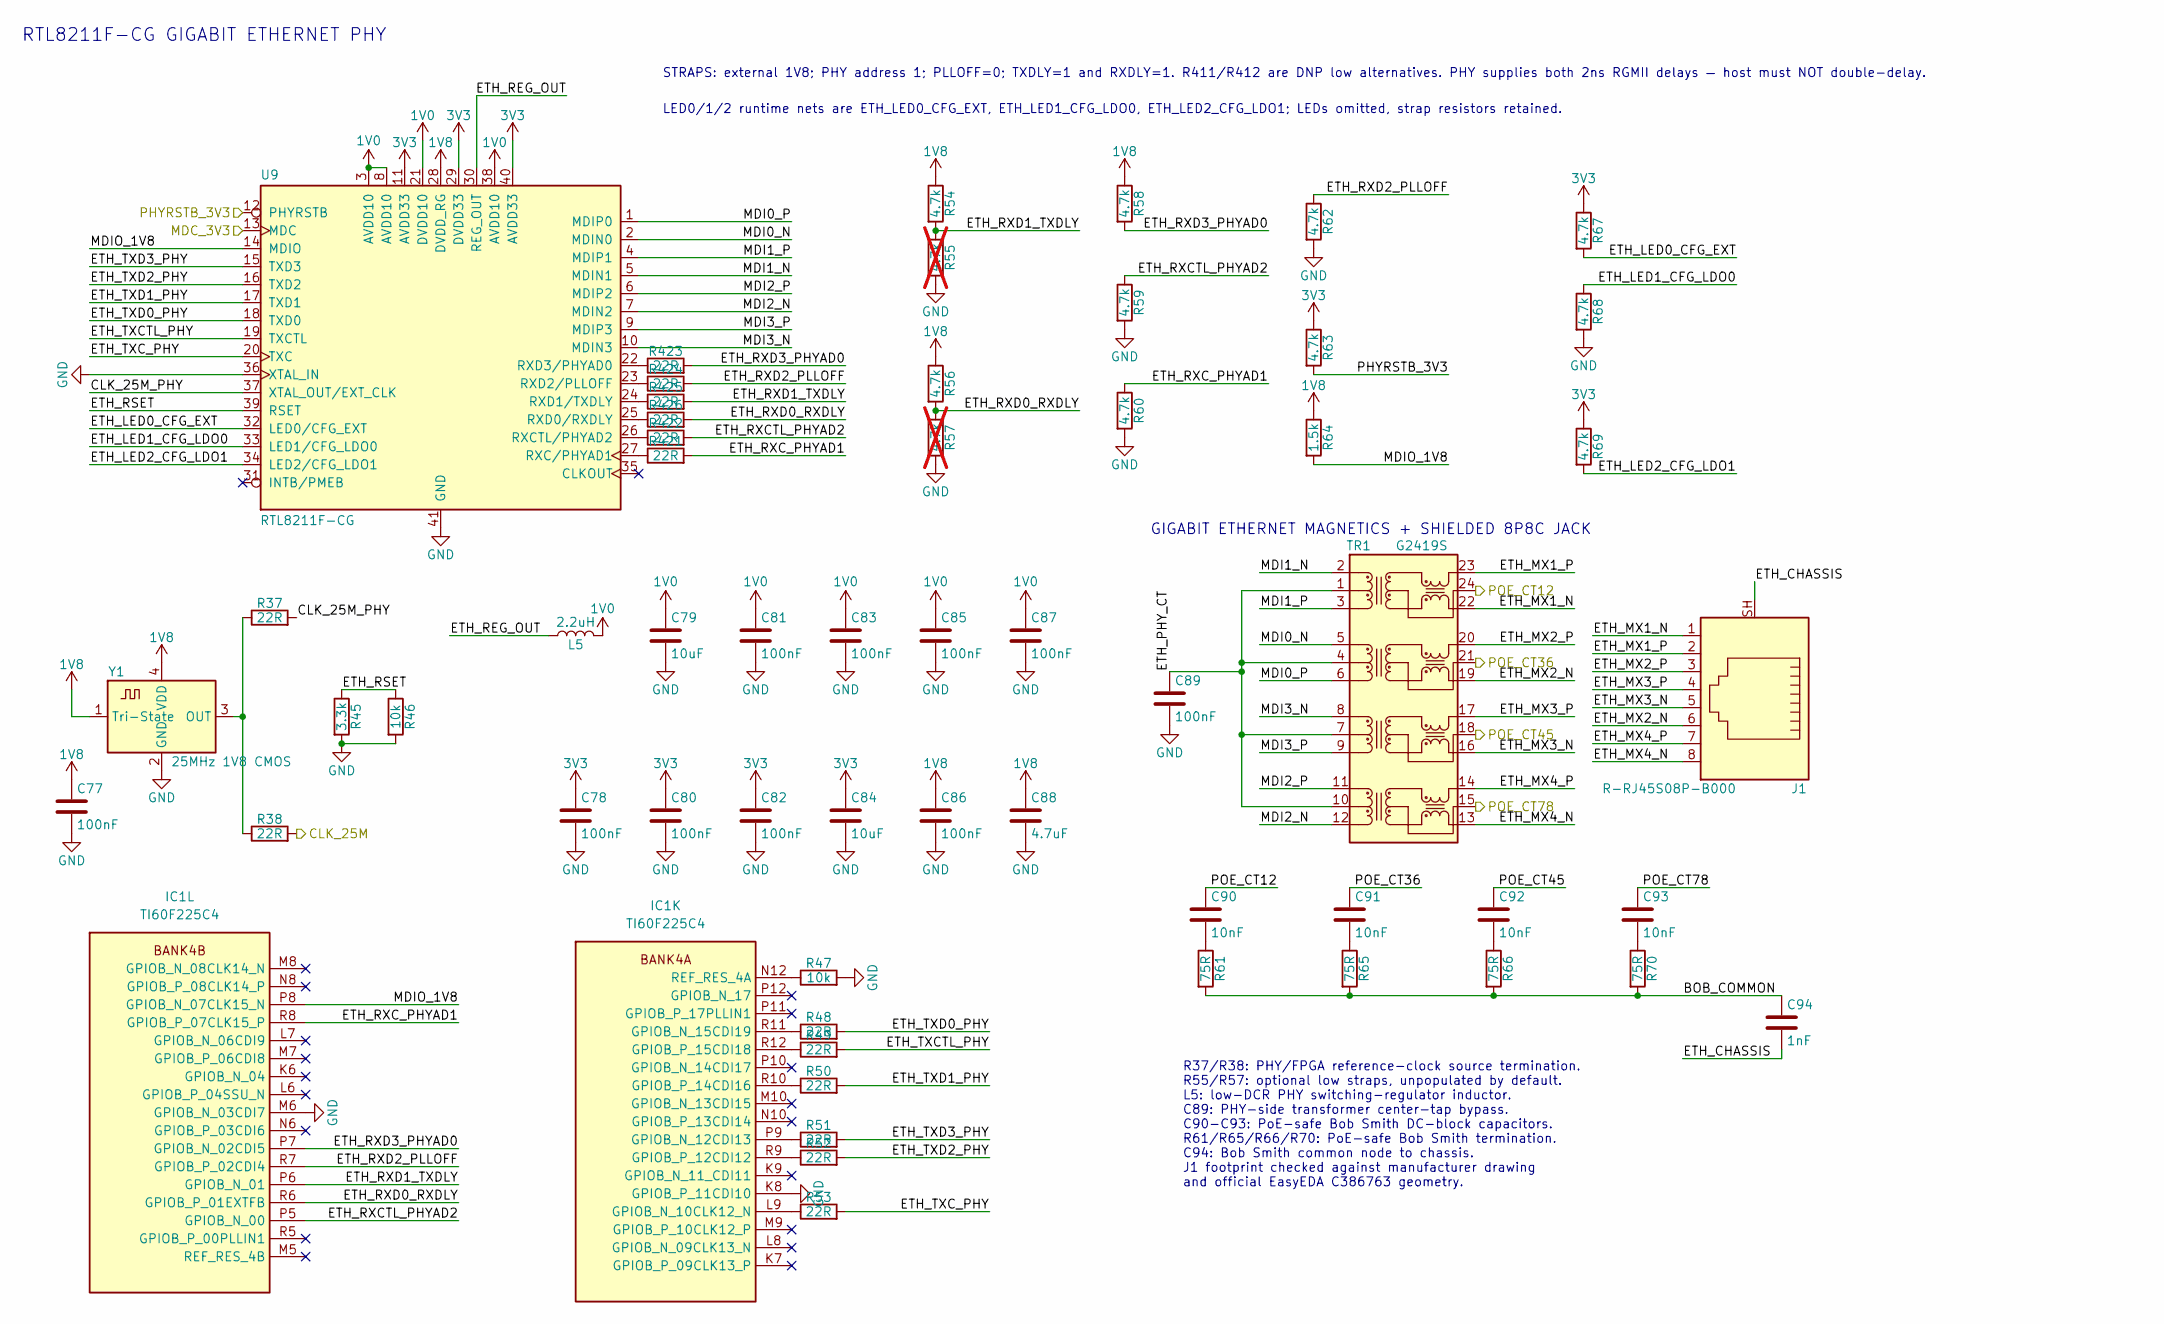
[picture p29: schematic ethernet.kicad_sch]

Parts:
C77, C78, C80, C81, C82, C83, C85, C86, C87: 100nF; C_0402_1005Metric; MPN CL05B104KO5NNNC; JLCPCB Library Basic
C79, C84: 10uF; C_0603_1608Metric; MPN CL10A106KP8NNNC; JLCPCB Library Basic
C88: 4.7uF; C_0603_1608Metric; MPN CL10A475KO8NNNC; JLCPCB Library Basic
C89: 100nF; C_0402_1005Metric; MPN CL05B104KO5NNNC; LCSC C1525
C90, C91, C92, C93: 10nF; C_0402_1005Metric; MPN CC0402KRX7R0BB103; LCSC C527014
C94: 1nF; C_1206_3216Metric; MPN 1206B102K202NT; LCSC C9196
IC1: TI60F225C4; BGA225C65P15X15_1000X1000X100; Manufacturer_Part_Number TI60F225C4
J1: R-RJ45S08P-B000; R-RJ45S08P-B000_8P8C_Vertical; MPN R-RJ45S08P-B000; LCSC C386763
L5: 2.2uH; L_Changjiang_FTC252012S; MPN FTC252012S2R2MBCA; JLCPCB Library Extended
R37, R38: 22R; R_0402_1005Metric; MPN 0402WGF220JTCE; LCSC C25092
R45: 3.3k; R_0402_1005Metric; MPN 0402WGF3301TCE; JLCPCB Library Basic
R46, R47: 10k; R_0402_1005Metric; MPN 0402WGF1002TCE; JLCPCB Library Basic
R48, R49, R50, R51, R52, R53, R421, R422, R423, R424, R425, R426: 22R; R_0402_1005Metric; MPN 0402WGF220JTCE; JLCPCB Library Basic
R54, R56, R58, R59, R60, R62, R63, R67, R68, R69: 4.7k; R_0402_1005Metric; MPN 0402WGF4701TCE; JLCPCB Library Basic
R55, R57: 4.7k; R_0402_1005Metric; MPN 0402WGF4701TCE; JLCPCB Library Basic; not fitted
R61, R65, R66, R70: 75R; R_0402_1005Metric; MPN 0402WGF750JTCE; LCSC C25133
R64: 1.5k; R_0402_1005Metric; MPN 0402WGF1501TCE; JLCPCB Library Basic
TR1: G2419S; G2419S_Transformer_SMD-24_15.1x7.1mm_P1.0mm; MPN G2419S; LCSC C3003220
U9: RTL8211F-CG; VQFN-40-1EP_5x5mm_P0.4mm_EP3.7x3.7mm; MPN RTL8211F-CG; LCSC C187932
Y1: 25MHz 1V8 CMOS; YXC_OT4EL89CJI_SMD1612_4Pin_1.6x1.2mm; MPN OT4EL89CJI-111YLC-25M; LCSC C41371106

Connections:
1V0: C79.1, C81.1, C83.1, C85.1, C87.1, L5.2, U9.3 (AVDD10), U9.8 (AVDD10), U9.21 (DVDD10), U9.38 (AVDD10)
1V8: C77.1, C86.1, C88.1, R54.1, R56.1, R58.1, R64.1, U9.28 (DVDD_RG), Y1.1 (Tri-State), Y1.4 (VDD); also elsewhere on the board
3V3: C78.1, C80.1, C82.1, C84.1, R63.1, R67.1, R69.1, U9.11 (AVDD33), U9.29 (DVDD33), U9.40 (AVDD33); also elsewhere on the board
/Config/CLK_25M: R38.2; also elsewhere on the board
/ETHERNET_RTL8211F/BOB_COMMON: C94.1, R61.2, R65.2, R66.2, R70.2
/ETHERNET_RTL8211F/CLK_25M_PHY: R37.2, U9.37 (XTAL_OUT/EXT_CLK)
/ETHERNET_RTL8211F/ETH_CHASSIS: C94.2, J1.SH
/ETHERNET_RTL8211F/ETH_LED0_CFG_EXT: R67.2, U9.32 (LED0/CFG_EXT)
/ETHERNET_RTL8211F/ETH_LED1_CFG_LDO0: R68.1, U9.33 (LED1/CFG_LDO0)
/ETHERNET_RTL8211F/ETH_LED2_CFG_LDO1: R69.2, U9.34 (LED2/CFG_LDO1)
/ETHERNET_RTL8211F/ETH_MX1_N: J1.1, TR1.22 (MX1-)
/ETHERNET_RTL8211F/ETH_MX1_P: J1.2, TR1.23 (MX1+)
/ETHERNET_RTL8211F/ETH_MX2_N: J1.6, TR1.19 (MX2-)
/ETHERNET_RTL8211F/ETH_MX2_P: J1.3, TR1.20 (MX2+)
/ETHERNET_RTL8211F/ETH_MX3_N: J1.5, TR1.16 (MX3-)
/ETHERNET_RTL8211F/ETH_MX3_P: J1.4, TR1.17 (MX3+)
/ETHERNET_RTL8211F/ETH_MX4_N: J1.8, TR1.13 (MX4-)
/ETHERNET_RTL8211F/ETH_MX4_P: J1.7, TR1.14 (MX4+)
/ETHERNET_RTL8211F/ETH_PHY_CT: C89.1, TR1.1 (CT), TR1.4 (CT), TR1.7 (CT), TR1.10 (CT)
/ETHERNET_RTL8211F/ETH_REG_OUT: L5.1, U9.30 (REG_OUT)
/ETHERNET_RTL8211F/ETH_RSET: R45.1, R46.1, U9.39 (RSET)
/ETHERNET_RTL8211F/ETH_RXCTL_PHYAD2: IC1.P5 (GPIOB_N_00), R59.1, R422.2
/ETHERNET_RTL8211F/ETH_RXC_PHYAD1: IC1.R8 (GPIOB_P_07CLK15_P), R60.1, R421.2
/ETHERNET_RTL8211F/ETH_RXD0_RXDLY: IC1.R6 (GPIOB_P_01EXTFB), R56.2, R57.1, R426.2
/ETHERNET_RTL8211F/ETH_RXD1_TXDLY: IC1.P6 (GPIOB_N_01), R54.2, R55.1, R425.2
/ETHERNET_RTL8211F/ETH_RXD2_PLLOFF: IC1.R7 (GPIOB_P_02CDI4), R62.1, R424.2
/ETHERNET_RTL8211F/ETH_RXD3_PHYAD0: IC1.P7 (GPIOB_N_02CDI5), R58.2, R423.2
/ETHERNET_RTL8211F/ETH_TXCTL_PHY: R49.2, U9.19 (TXCTL)
/ETHERNET_RTL8211F/ETH_TXC_PHY: R53.2, U9.20 (TXC)
/ETHERNET_RTL8211F/ETH_TXD0_PHY: R48.2, U9.18 (TXD0)
/ETHERNET_RTL8211F/ETH_TXD1_PHY: R50.2, U9.17 (TXD1)
/ETHERNET_RTL8211F/ETH_TXD2_PHY: R52.2, U9.16 (TXD2)
/ETHERNET_RTL8211F/ETH_TXD3_PHY: R51.2, U9.15 (TXD3)
/ETHERNET_RTL8211F/MDI0_N: TR1.5 (TD2+), U9.2 (MDIN0)
/ETHERNET_RTL8211F/MDI0_P: TR1.6 (TD2-), U9.1 (MDIP0)
/ETHERNET_RTL8211F/MDI1_N: TR1.2 (TD1+), U9.5 (MDIN1)
/ETHERNET_RTL8211F/MDI1_P: TR1.3 (TD1-), U9.4 (MDIP1)
/ETHERNET_RTL8211F/MDI2_N: TR1.12 (TD4-), U9.7 (MDIN2)
/ETHERNET_RTL8211F/MDI2_P: TR1.11 (TD4+), U9.6 (MDIP2)
/ETHERNET_RTL8211F/MDI3_N: TR1.8 (TD3+), U9.10 (MDIN3)
/ETHERNET_RTL8211F/MDI3_P: TR1.9 (TD3-), U9.9 (MDIP3)
/ETHERNET_RTL8211F/MDIO_1V8: IC1.P8 (GPIOB_N_07CLK15_N), R64.2, U9.14 (MDIO)
/ETHERNET_RTL8211F/POE_CT12: C90.1, TR1.24 (CT); also elsewhere on the board
/ETHERNET_RTL8211F/POE_CT36: C91.1, TR1.21 (CT); also elsewhere on the board
/ETHERNET_RTL8211F/POE_CT45: C92.1, TR1.18 (CT); also elsewhere on the board
/ETHERNET_RTL8211F/POE_CT78: C93.1, TR1.15 (CT); also elsewhere on the board
/MDC_3V3: U9.13 (MDC); also elsewhere on the board
/PHYRSTB_3V3: R63.2, U9.12 (PHYRSTB); also elsewhere on the board
GND: C77.2, C78.2, C79.2, C80.2, C81.2, C82.2, C83.2, C84.2, C85.2, C86.2, C87.2, C88.2, C89.2, IC1.K8 (GPIOB_P_11CDI10), IC1.M6 (GPIOB_N_03CDI7), R45.2, R46.2, R47.2, R55.2, R57.2, R59.2, R60.2, R62.2, R68.2, U9.36 (XTAL_IN), U9.41 (GND), Y1.2 (GND); also elsewhere on the board
unnamed: C90.2, R61.1
unnamed: C91.2, R65.1
unnamed: C92.2, R66.1
unnamed: C93.2, R70.1
unnamed: IC1.L9 (GPIOB_N_10CLK12_N), R53.1
unnamed: IC1.P9 (GPIOB_N_12CDI13), R51.1
unnamed: IC1.R11 (GPIOB_N_15CDI19), R48.1
unnamed: IC1.R9 (GPIOB_P_12CDI12), R52.1
unnamed: IC1.R10 (GPIOB_P_14CDI16), R50.1
unnamed: IC1.R12 (GPIOB_P_15CDI18), R49.1
unnamed: IC1.N12 (REF_RES_4A), R47.1
unnamed: R422.1, U9.26 (RXCTL/PHYAD2)
unnamed: R421.1, U9.27 (RXC/PHYAD1)
unnamed: R426.1, U9.25 (RXD0/RXDLY)
unnamed: R425.1, U9.24 (RXD1/TXDLY)
unnamed: R424.1, U9.23 (RXD2/PLLOFF)
unnamed: R423.1, U9.22 (RXD3/PHYAD0)
unnamed: R37.1, R38.1, Y1.3 (OUT)

Notes on the sheet:
RTL8211F-CG GIGABIT ETHERNET PHY
R37/R38: PHY/FPGA reference-clock source termination. R55/R57: optional low straps, unpopulated by default. L5: low-DCR PHY switching-regulator inductor. C89: PHY-side transformer center-tap bypass. C90-C93: PoE-safe Bob Smith DC-block capacitors. R61/R65/R66/R70: PoE-safe Bob Smith termination. C9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
LED0/1/2 runtime nets are ETH_LED0_CFG_EXT, ETH_LED1_CFG_LDO0, ETH_LED2_CFG_LDO1; LEDs omitted, strap resistors retained.
GIGABIT ETHERNET MAGNETICS + SHIELDED 8P8C JACK
STRAPS: external 1V8; PHY address 1; PLLOFF=0; TXDLY=1 and RXDLY=1. R411/R412 are DNP low alternatives. PHY supplies both 2ns RGMII delays — host must NOT double-delay.

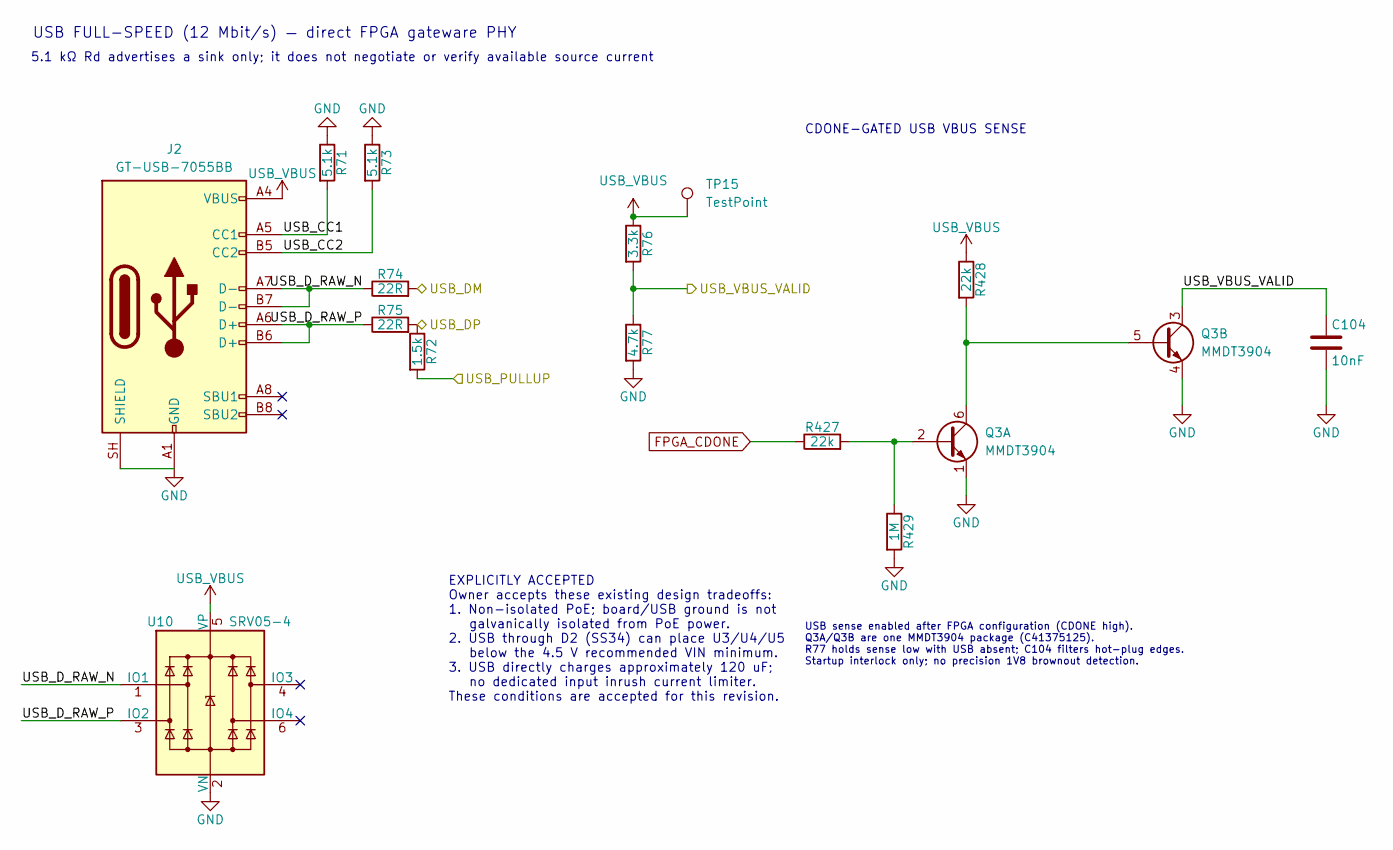
[picture p30: schematic usb.kicad_sch]

Parts:
C104: 10nF; C_0402_1005Metric; MPN CL05B103KB5NNNC; LCSC C15195
J2: GT-USB-7055BB; USB_C_Receptacle_G-Switch_GT-USB-7055BB; MPN GT-USB-7055BB; LCSC C7450621
Q3: MMDT3904; SOT-363_SC-70-6; MPN MMDT3904; LCSC C41375125
R71, R73: 5.1k; R_0402_1005Metric; MPN 0402WGF5101TCE; LCSC C25905
R72: 1.5k; R_0402_1005Metric; MPN 0402WGF1501TCE; LCSC C25867
R74, R75: 22R; R_0402_1005Metric; MPN 0402WGF220JTCE; LCSC C25092
R76: 3.3k; R_0402_1005Metric; MPN 0402WGF3301TCE; LCSC C25890
R77: 4.7k; R_0402_1005Metric; MPN 0402WGF4701TCE; LCSC C25900
R427, R428: 22k; R_0402_1005Metric; MPN 0402WGF2202TCE; LCSC C25768
R429: 1M; R_0402_1005Metric; MPN 0402WGF1004TCE; LCSC C26083
TP15: TestPoint; TestPoint_Pad_D2.0mm
U10: SRV05-4; SOT-23-6; MPN SRV05-4; LCSC C2836319

Connections:
/USB_D_N: R74.2; also elsewhere on the board
/USB_D_P: R72.1, R75.2; also elsewhere on the board
/USB_FS/USB_CC1: J2.A5 (CC1), R71.2
/USB_FS/USB_CC2: J2.B5 (CC2), R73.2
/USB_FS/USB_D_RAW_N: J2.A7 (D-), J2.B7 (D-), R74.1, U10.1 (IO1)
/USB_FS/USB_D_RAW_P: J2.A6 (D+), J2.B6 (D+), R75.1, U10.3 (IO2)
/USB_PULLUP: R72.2; also elsewhere on the board
/USB_VBUS_VALID: C104.1, Q3.3 (C2), R76.2, R77.1; also elsewhere on the board
FPGA_CDONE: R427.1; also elsewhere on the board
GND: C104.2, J2.A1 (GND), J2.A12 (GND), J2.B1 (GND), J2.B12 (GND), J2.SH (SHIELD), Q3.1 (E1), Q3.4 (E2), R71.1, R73.1, R77.2, R429.2, U10.2 (VN); also elsewhere on the board
unnamed: Q3.2 (B1), R427.2, R429.1
unnamed: Q3.5 (B2), Q3.6 (C1), R428.2
USB_VBUS: J2.A4 (VBUS), J2.A9 (VBUS), J2.B4 (VBUS), J2.B9 (VBUS), R76.1, R428.1, TP15.1 (1_1), U10.5 (VP); also elsewhere on the board

Notes on the sheet:
5.1 kΩ Rd advertises a sink only; it does not negotiate or verify available source current
USB sense enabled after FPGA configuration (CDONE high). Q3A/Q3B are one MMDT3904 package (C41375125). R77 holds sense low with USB absent; C104 filters hot-plug edges. Startup interlock only; no precision 1V8 brownout detection.
CDONE-GATED USB VBUS SENSE
EXPLICITLY ACCEPTED Owner accepts these existing design tradeoffs: 1. Non-isolated PoE; board/USB ground is not galvanically isolated from PoE power. 2. USB through D2 (SS34) can place U3/U4/U5 below the 4.5 V recommended VIN minimum. 3. USB directly charges approximately 120 uF; no dedicated input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
USB FULL-SPEED (12 Mbit/s) — direct FPGA gateware PHY

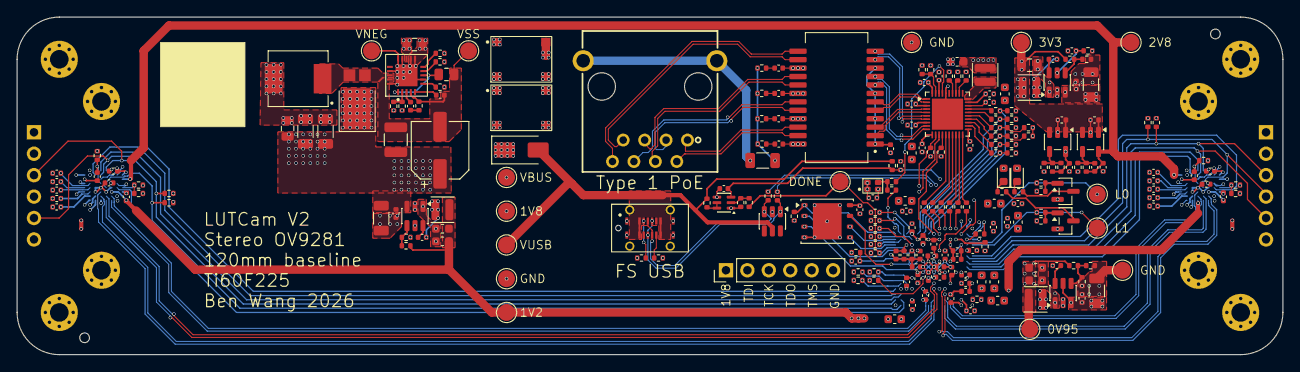
[picture p31: board lutcam-hardware.kicad_pcb from above]

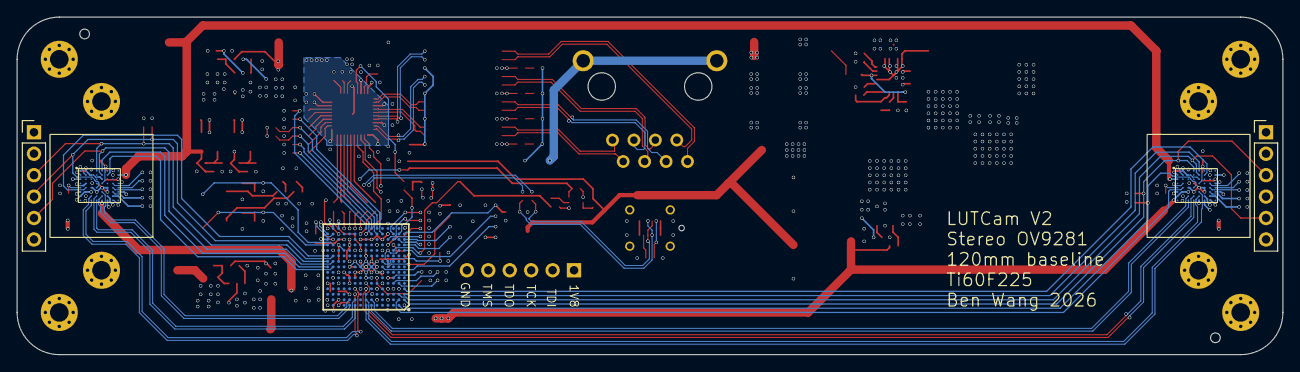
[picture p32: board lutcam-hardware.kicad_pcb from below]

Board: 6 copper layers, 150.0 x 40.0 mm, 255 parts (7 on the bottom side), 169 nets.
