kingoflolz/lutcam/gateware/rtl/lftag/LfTagCornerSelect9.sv

// Area-oriented LFTag nine-point geometry preflight.
//
// ChildArena supplies nine descriptors in ascending mass order.  Slots 7/8
// are the fixed top anchors.  The seven data points occupy three canonical
// rows: after orienting the top baseline, the deepest three are the bottom
// row.  Their minimum/maximum baseline projections select the two bottom
// corners.  Internal coordinate widths match the 15-bit X / 14-bit Y FIFO;
// descriptors outside that active-plane contract are rejected explicitly.
module LfTagCornerSelect9 #(
    parameter bit USE_DSP_SUBTRACT = 1'b0
) (
    input  logic                 clk,
    input  logic                 rst,
    input  logic                 in_valid,
    output logic                 in_ready,
    input  logic                 in_points_valid,
    input  logic [15:0]          in_min_baseline_q4,
    output logic                 desc_req_valid,
    output logic [3:0]           desc_req_index,
    input  logic                 desc_rsp_valid,
    input  logic signed [17:0]   desc_rsp_x_q4,
    input  logic signed [17:0]   desc_rsp_y_q4,
    input  logic [7:0]           desc_rsp_mass_q5_3,
    input  logic                 desc_rsp_centroid_valid,
    output logic                 out_valid,
    input  logic                 out_ready,
    output logic [2:0]           out_status,
    output logic                 out_input_valid,
    output logic                 out_baseline_valid,
    output logic                 out_dominant_valid,
    output logic                 out_corners_valid,
    output logic                 out_quad_valid,
    output logic [15:0]          out_corner_index_flat,
    output logic [19:0]          out_remaining_index_flat,
    output logic [71:0]          out_corner_x_q4_flat,
    output logic [71:0]          out_corner_y_q4_flat,
    output logic [7:0]           out_cycles
);
    localparam logic [2:0] STATUS_VALID = 3'd0;
    localparam logic [2:0] STATUS_INVALID_INPUT = 3'd1;
    localparam logic [2:0] STATUS_BASELINE_SHORT = 3'd2;
    localparam logic [2:0] STATUS_DOMINANT_SIDE = 3'd3;
    localparam logic [2:0] STATUS_CORNER_SELECTION = 3'd4;
    localparam logic [2:0] STATUS_INVALID_QUAD = 3'd5;

    typedef enum logic [3:0] {
        S_IDLE,
        S_ANCHOR_SCAN,
        S_BASE_SETUP,
        S_BASE_LENGTH,
        S_BASE_MINIMUM,
        S_SIDE_SCAN,
        S_DEPTH_SCAN,
        S_PICK_SCAN,
        S_CORNER_LEFT_CAPTURE,
        S_CORNER_RIGHT_CAPTURE,
        S_QUAD_CHECK,
        S_FINISH
    } state_t;

    state_t state;
    logic [15:0] minimum_baseline_q4;
    logic [3:0] scan_index;
    logic [1:0] depth_pass;
    logic pick_right;

    logic [14:0] anchor_a_x;
    logic [13:0] anchor_a_y;
    logic [14:0] anchor_b_x;
    logic [13:0] anchor_b_y;
    logic signed [15:0] base_x;
    logic signed [14:0] base_y;
    logic orientation_flip;

    // Before the depth scan value0 holds the baseline norm.  It then holds
    // one maximum depth or one projection extreme.  Three
    // short FIFO passes find the three deepest indices without a rank bank.
    logic [31:0] value0;
    logic [2:0] depth_index0;
    logic [2:0] depth_index1;
    logic [2:0] depth_index2;

    logic [2:0] positive_count;
    logic [2:0] negative_count;
    logic [2:0] bottom_left;
    logic [2:0] bottom_right;
    logic [14:0] bottom_left_x;
    logic [13:0] bottom_left_y;
    logic [14:0] bottom_right_x;
    logic [13:0] bottom_right_y;
    logic [7:0] cycle_counter;
    logic [7:0] anchor_first_mass;
    logic anchor_mass_order_valid;
    logic anchor_centroids_valid;

    logic signed [15:0] descriptor_dx;
    logic signed [14:0] descriptor_dy;

    logic signed [17:0] multiply_a0;
    logic signed [17:0] multiply_b0;
    logic signed [17:0] multiply_a1;
    logic signed [17:0] multiply_b1;
    (* syn_use_dsp = "yes" *) logic signed [31:0] metric_q;
    logic product_launch;
    logic product_valid_q;
    logic product_is_baseline_min_q;
    logic [2:0] product_index_q;
    logic [1:0] product_pass_q;
    logic signed [30:0] cross_value;
    logic signed [31:0] projection_value;
    logic [30:0] norm_value;
    logic [31:0] metric_value;
    logic coordinate_range_valid;
    logic [31:0] compare_left;
    logic [31:0] compare_right;
    logic compare_greater;
    logic [2:0] side_positive_next;
    logic [2:0] side_negative_next;
    logic depth_candidate_wins;
    logic [2:0] product_point_index;


    assign in_ready = state == S_IDLE;
    assign out_valid = (state == S_FINISH);
    assign desc_req_valid = ((state == S_IDLE) && in_valid
            && in_points_valid)
        || ((state == S_ANCHOR_SCAN) && desc_rsp_valid
            && (scan_index == 7))
        || (state == S_BASE_MINIMUM)
        || ((state == S_SIDE_SCAN) && (
            (desc_rsp_valid && (scan_index < 6))
            || (product_valid_q && !product_is_baseline_min_q
                && (product_index_q == 6))))
        || ((state == S_DEPTH_SCAN) && (
            (desc_rsp_valid
                && ((scan_index < 6) || (depth_pass < 2)))
            || (product_valid_q && (product_pass_q == 2)
                && (product_index_q == 6))))
        || ((state == S_PICK_SCAN) && (
            (desc_rsp_valid && (scan_index < 2))
            || (product_valid_q && (product_index_q == 2))))
        || ((state == S_CORNER_LEFT_CAPTURE) && desc_rsp_valid);

    always_comb begin
        case (scan_index[1:0])
            2'd0: desc_req_index = {1'b0, depth_index0};
            2'd1: desc_req_index = {1'b0, depth_index1};
            default: desc_req_index = {1'b0, depth_index2};
        endcase
        if (state == S_IDLE)
            desc_req_index = 4'd7;
        else if (state == S_ANCHOR_SCAN)
            desc_req_index = 4'd8;
        else if (state == S_BASE_MINIMUM)
            desc_req_index = 4'd0;
        else if (state == S_SIDE_SCAN) begin
            if (product_valid_q && !product_is_baseline_min_q
                    && (product_index_q == 6))
                desc_req_index = 4'd0;
            else
                desc_req_index = scan_index + 1'b1;
        end
        else if (state == S_DEPTH_SCAN) begin
            if (product_valid_q && (product_pass_q == 2)
                    && (product_index_q == 6))
                desc_req_index = {1'b0, depth_index0};
            else if (scan_index == 6)
                desc_req_index = 4'd0;
            else
                desc_req_index = scan_index + 1'b1;
        end else if (state == S_PICK_SCAN) begin
            if (product_valid_q && (product_index_q == 2)) begin
                if (pick_right)
                    desc_req_index = {1'b0, bottom_left};
                else
                    desc_req_index = {1'b0, depth_index0};
            end else begin
                case (scan_index[1:0])
                    2'd0: desc_req_index = {1'b0, depth_index1};
                    default: desc_req_index = {1'b0, depth_index2};
                endcase
            end
        end else if (state == S_CORNER_LEFT_CAPTURE)
            desc_req_index = {1'b0, bottom_right};
    end

    logic signed [15:0] base_delta_x;
    logic signed [14:0] base_delta_y;
    logic signed [17:0] quad_delta_x_right, quad_delta_y_left;
    logic signed [17:0] quad_delta_y_right, quad_delta_x_left;
    LfTagCornerSubtract #(.WIDTH(16), .USE_DSP(USE_DSP_SUBTRACT)) descriptor_x (
        .a({1'b0, desc_rsp_x_q4[14:0]}), .b({1'b0, anchor_a_x}), .result(descriptor_dx));
    LfTagCornerSubtract #(.WIDTH(15), .USE_DSP(USE_DSP_SUBTRACT)) descriptor_y (
        .a({1'b0, desc_rsp_y_q4[13:0]}), .b({1'b0, anchor_a_y}), .result(descriptor_dy));
    LfTagCornerSubtract #(.WIDTH(16), .USE_DSP(USE_DSP_SUBTRACT)) baseline_x (
        .a({1'b0, anchor_b_x}), .b({1'b0, anchor_a_x}), .result(base_delta_x));
    LfTagCornerSubtract #(.WIDTH(15), .USE_DSP(USE_DSP_SUBTRACT)) baseline_y (
        .a({1'b0, anchor_b_y}), .b({1'b0, anchor_a_y}), .result(base_delta_y));
    LfTagCornerSubtract #(.WIDTH(18), .USE_DSP(USE_DSP_SUBTRACT)) quad_x_right (
        .a({3'b0, bottom_right_x}), .b({3'b0, anchor_b_x}), .result(quad_delta_x_right));
    LfTagCornerSubtract #(.WIDTH(18), .USE_DSP(USE_DSP_SUBTRACT)) quad_y_left (
        .a({4'b0, bottom_left_y}), .b({4'b0, anchor_b_y}), .result(quad_delta_y_left));
    LfTagCornerSubtract #(.WIDTH(18), .USE_DSP(USE_DSP_SUBTRACT)) quad_y_right (
        .a({4'b0, anchor_b_y}), .b({4'b0, bottom_right_y}), .result(quad_delta_y_right));
    LfTagCornerSubtract #(.WIDTH(18), .USE_DSP(USE_DSP_SUBTRACT)) quad_x_left (
        .a({3'b0, bottom_left_x}), .b({3'b0, anchor_b_x}), .result(quad_delta_x_left));
    assign coordinate_range_valid = !(|desc_rsp_x_q4[17:15])
        && !(|desc_rsp_y_q4[17:14]);
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
